soham0777/dermasense-vishwakarma-2026/5_cad/calc_mechanical_report.md

# Mechanical calculations (generated by calc_mechanical.py, 2026-10-14)

| Quantity | Result | Basis |
|---|---|---|
| Pin spring rate (linear assumption) | 0.49 N/mm | [DS] 100 g at 2 mm travel (Probots P75-B1 listing) |
| Pin compression when clamped | 1.48 mm (of 2.0 mm travel) | [DES] protrusion − film |
| Contact force per pin / total | 0.72 N / 2.89 N | [EST] |
| Lid deflection (PETG, 4.0 mm, span 35.7 mm) | 11.2 µm | [EST] simply supported, centre load |
| Lid bending stress (same beam model) | 0.42 MPa | [EST] vs PETG yield ~40-50 MPa [DS typ.]: FoS ≈ 95; > 40 even if FDM printing halves strength. Analytical check, not FEA |
| Pin landing tolerance on 3 mm pad | allow ±1.35 mm; worst-case 0.49, RSS 0.25 mm | [EST] margin 2.8× worst-case |
| Strip bending strain at 10 mm radius | 0.62 % | t/2R; Kapton yields near 3 % [DS]; LIG cracking limit unknown → T-MECH-01 |
| Kapton bearing stress at dowels, 10 N tug | 20 MPa vs 231 MPa tensile | [EST] dowels take the load, not the pins (strain relief) |
| Pointed-tip contact stress (0.1 mm tip radius) | 23 MPa | [EST] may dent porous LIG → prefer rounded-head pins; verify in T-CON-01 |
| Stack heights | base 16.0 mm; dressing 4.0 mm; spacer 12 mm | [DES] keeps the dressing top level with the clamp top |

**Conclusions:**
- The two M3 screws easily provide the 2.9 N pin reaction.
- The lid deflects only about 11 µm against 1.48 mm of pin compression, so contact force is set by the pin springs, not the lid.
- The tolerance stack uses at most 0.49 mm of the 1.35 mm allowed.
- The dowels take any pull on the strip (strain relief).
- **Open risk:** pointed pin tips on porous LIG. Use rounded-head pins or a silver-paint pad, and verify in T-CON-01.
