soham0777/dermasense-vishwakarma-2026/FINAL_SUBMISSION/SUBMIT_CHECKLIST.md

# Stage 2 submission: VK26-IITI-HT-0050 (Dermasense)

> **Submitted on 20 Oct 2026** through the Design Stage Form (Health Tech · Emergency Response & Remote Monitoring), with the PDF in this folder (MD5 `3264735b…`). The form confirmed: "We have received your response for Stage 2". The table below is kept as a record.

**Files to upload**
- `Dermasense_VK26-IITI-HT-0050_Stage2.pdf`: 19 pages, exported by PowerPoint from the PPTX next to it.
- `Dermasense_VK26-IITI-HT-0050_Stage2.pptx`: the editable source.

**Project link** (use it wherever the form asks for a project, repository or Drive link):
https://github.com/soham0777/dermasense-vishwakarma-2026

**Deadline:** 11:59 PM, 25 October 2026 (organiser's email; no timezone given). Submit a day early if you can.

## Already done
- Team feedback applied to slides 1–19 (wording, numbers, sources).
- Slide 12 now has the team photos (Soham with the early laser-written samples; Bhakti in the cleanroom) and the roles. It also has the GitHub link, which is clickable in the PDF.
- Old deck versions removed from the repository. The template and the engineering PDFs are kept (CAD drawings, KiCad schematic, E2 bench sheets).

## Still needs you
| # | Do | Pass when |
|---|---|---|
| 1 | Flip through the PDF once | Nothing looks wrong to you |
| 2 | **Roles on slide 12:** Soham = Mechanical Architecture & Sensor Design; Bhakti = Materials & Micro-fabrication (semiconductor background) | Both of you agree |
| 3 | **ID badges:** the template asks for institutional ID badges to be visible in the team photo. Neither photo shows one. If you have a photo with badges, right-click the photo → **Change Picture**, then **File → Export → PDF** | Badges visible, or you accept the risk |
| 4 | **Canva:** these edits are in the PPTX/PDF, not in your Canva design. Upload the PDF, or import the PPTX into Canva before sharing a Canva link | The file you submit is this version |
| 5 | Submit through the Design Stage Form in the organiser's email | Confirmation screenshot saved in `_private/` |
