soham0777/dermasense-vishwakarma-2026/3_decisions/decision_matrix.md

# Sensor decision matrix (generated by decision_matrix.py)

Scores 1–5 (5 = better / simpler / cheaper). Engineering judgement, to be re-scored after E2 and E4.

| Criterion (weight) | S1 | S2 | S3 | S4 | S5 |
|---|---|---|---|---|---|
| Signal contrast wet vs dry (3) | 5 | 5 | 5 | 3 | 3 |
| Discrimination (front vs condensation, leak, handling, failure) (3) | 2 | 4 | 4 | 3 | 3 |
| Repeatability given unknown LIG batch variation (3) | 4 | 4 | 4 | 2 | 3 |
| Calibration burden (2) | 4 | 4 | 4 | 2 | 3 |
| Geometry feasible with ~0.3 mm laser lines (2) | 5 | 4 | 3 | 4 | 4 |
| Fluid compatibility (fouling, electrochemistry) (2) | 4 | 4 | 4 | 3 | 5 |
| Electronics complexity (2) | 5 | 5 | 4 | 4 | 2 |
| Fabrication difficulty (layers, registration) (2) | 5 | 4 | 3 | 4 | 3 |
| Unit cost (2) | 5 | 5 | 4 | 5 | 4 |
| Disposable waste (1) | 5 | 5 | 4 | 5 | 4 |
| User workflow (2) | 4 | 4 | 4 | 4 | 4 |
| Safety (2) | 5 | 5 | 5 | 5 | 5 |
| Validation burden (2) | 4 | 4 | 3 | 2 | 3 |
| **Weighted score / 5** | **4.29** | **4.36** | **3.96** | **3.39** | **3.46** |

## Ranking

1. S2 Two-zone strip: centre C + change line A: **4.36**. Adds an ORDER check: a real front wets C before A. A-before-C flags CHECK (leak, handling, misplacement). Needs only 2 sense lanes.
2. S1 Single-zone strip at the change line: **4.29**. Simplest. Cannot tell a genuine front from a drip, an external leak or handling at the window.
3. S3 Four-zone front strip: C, M, A, E: **3.96**. Early warning (M) and a leak zone (E), but 4 lanes, tighter routing and more registration-critical windows; unproven benefit.
4. S5 Capacitive sealed electrodes (no fluid contact): **3.46**. Best fluid compatibility; needs a capacitance front end (the ESP32-C3 has no touch peripheral) and lamination.
5. S4 Continuous resistive front locator (1 line + collector): **3.39**. Elegant (3 contacts), but the reading depends directly on LIG Rs uniformity, our least-known property.
