soham0777/dermasense-vishwakarma-2026/3_decisions/sensor_selection.md

# Primary sensor design: two-zone moisture-front strip (decision D-012)

**Status:** SELECTED as design v0.1 (2026-10-14). **Not fabricated, not tested.** Scores are in `decision_matrix.md` (generated by `decision_matrix.py`).

## 1. Decision

| Rank | Concept | Score | Role |
|---|---|---|---|
| 1 | **S2: two-zone strip, pad centre C + change line A** | 4.36 | **Primary (v0.1)** |
| 2 | S1: single zone at the change line | 4.29 | **Fallback 1**, if sealing registration fails in E2 (one window, no lane under it) |
| 3 | S3: four zones C, M, A, E | 3.96 | **Upgrade path**, only if E4 shows that early warning (M) or leak warning (E) changes a decision |
| 4 | S5: capacitive, sealed | 3.46 | Fallback 2, if saline contact proves unworkable (fouling, drift) |
| 5 | S4: continuous resistive locator | 3.39 | Rejected for now: its reading depends directly on LIG uniformity, our least-known property |

**Why S2 beats the earlier 4-zone idea under *our* constraints:**
- It keeps the one thing a single zone can't do, the **order check**: a real front wets C before A.
- It halves the routing (2 sense lanes instead of 4) and the number of alignment-critical windows.

## 2. How it works

- **Electrodes:** LIG electrodes face the absorbent pad on the pad's outer face, under the cover film. The strip never touches the wound.
- **Wetting:** when exudate reaches a zone window, the saline-like fluid bridges a 1.0 mm gap between that zone's sense electrode and the common electrode.
- **Signal:** resistance falls from ≥ 1 MΩ (dry, estimate) to about 4–15 kΩ (wet, calculated including leads). Details in `6_electronics/calc_readout_report.md`.
- **LIG is only the conductor here.** No chemical selectivity is claimed. LIG made in air is superhydrophilic (Li 2017), so fluid wets the windows readily. For the same reason **every trace outside a window is sealed** under polyimide tape, otherwise fluid could wick along it.

**Layer stack, wound side last:**
1. cover film
2. strip: Kapton with LIG facing down, plus polyimide-tape seal with windows
3. absorbent pad
4. wound-contact layer
5. wound

## 3. States (all must be physically measurable; firmware `zone_logic.h`)

| State | Condition (each zone: wet < 100 kΩ, dry > 300 kΩ, hysteresis between) | Meaning |
|---|---|---|
| OK | C dry, A dry; or C wet, A dry | Dressing still has capacity at the change line |
| CHANGE | A wet **after** C was wet, persisting ≥ 3 scans | Front reached the maker's change line |
| CHECK | A wet while C dry (order violated), persisting ≥ 3 scans | Possible external leak, handling, misplaced strip, or condensation at A only |
| FAULT | Common loop open (> 50 kΩ between its two ends), reading below the lead floor (< 1 kΩ = short), or self-test resistor out of ±5 % | Sensor or contact failure; never shown as "OK" |

**Decided against for v0.1:** SOON and LEAK. They need M and E zones, which are not in v0.1.

## 4. Telling a real front from look-alikes

| Look-alike | Expected signature (hypothesis) | Detection in v0.1 | Test that confirms or refutes |
|---|---|---|---|
| Real saturation front | C wets, then A after a delay that depends on flow; both reach low kΩ | Order + persistence | E4 runs (dressing + Solution A, centre inflow) |
| External leak or spill at the edge | A wets first, C stays dry | CHECK | E4-L: drip on the outer face at A |
| Condensation under the cover film | Both zones drift down slowly, probably not to the kΩ range (unknown) | Not separable from a front if it reaches < 100 kΩ | **E4-H:** warm humid chamber, dry dressing, 2 h. If readings drop below 300 kΩ, the threshold must change |
| Sweat (skin side) | The strip is on the outer face of the pad; sweat must pass through the pad first | Same as a front | Not tested on the bench; documented limitation |
| Handling / pressing | Brief changes | Persistence ≥ 3 scans (15 s) | E4-P: press and flex a dry strip |
| Cracked trace or bad contact | Loop open, or one zone stuck at the open-circuit limit | FAULT | Cut test: cut the common leg → must report FAULT |

## 5. Geometry v0.1 (PROVISIONAL: conservative 1.0 mm features until E2 measures line growth and minimum gap)

- **Strip:** 10 mm wide.
- **Zone windows:** 6 mm long along the strip; they expose the sense electrode, a 1.0 mm gap and the common electrode.
- **Spacing C to A:** 17.5 mm.
  - This assumes a 75 × 75 mm pad with the change line 20 mm inside the pad edge.
  - **It must be re-set to the actual test dressing's pad and its IFU rule.**
- **Tail:** leaves the dressing to a 4-pad paddle (SENSE_C, SENSE_A, COM_1, COM_2) at 5.08 mm pitch, with two Ø2.0 mm alignment holes.
- **Generated by** `4_sensor_strip/make_strip.py`, which writes the DXF and JSON and runs a clearance check. SolidWorks reads the same JSON (`5_cad/sw_build.py`).

## 6. What is NOT yet known

- Real Rs and line width (E2).
- Minimum isolating gap and sealing registration (E2).
- Dry baseline on real dressings, and the condensation response (E4-H).
- Whether the strip changes the dressing's fluid uptake (E4 control with no strip).
- Whether pogo-pin contact on LIG pads is stable (T-CON-01).
