soham0777/dermasense-vishwakarma-2026/1_presentation/template/TEMPLATE_PROVENANCE.md

# Official template: provenance

| File | MD5 | Source |
|---|---|---|
| `Vishwakarma Awards 2026-27 Stage 2 Submission Template.pptx` | 4d96244a04c6be5a3a952b42eb965679 | First copy (2026-10-14) |
| `Vishwakarma Awards 2026-27 Stage 2 Submission Template (2).pptx` | c58ef4fe526045f1a82a806e6532bc3c | The file the team named as the official template (`Downloads`, 2026-10-14) |

**Compared on 2026-10-14 with python-pptx:** both have 20 slides at 16:9, and every slide has the same shape count and the same text. The bytes differ only because the file was re-exported.

**Rule:**
- Both files stay unmodified. The deck builder must start from **Template (2)**.
- Never edit a template in place; work on a copy.
