soham0777/dermasense-vishwakarma-2026/6_electronics/kicad/out/reader_v0_1_schematic.pdf

1 | 2 | 3 | 4 | 5 | 6
1 | 2 | 3 | 4 | 5 | 6

AB

C

D

AB

C

### D Date: 2026-10-14

### KiCad E.D.A. 10.0.6

Size: A4 | Rev: 0.1 PROVISIONAL Id: 1/1

## Title: Dermasense two-zone reader v0.1

### File: reader_v0_1.kicad_sch

### Sheet: /

## Team Dermasense, Vishwakarma Awards 2026-27

### Bench reader: ESP32-C3 SuperMini + ADS1115 module

Generated by 6_electronics/kicad/make_reader_schematic.py - edit the script, not this file

R3
1k D1

LED green OK

R9

1k R2
1k R8
1k +3V3 | GND GND | R1

1k 1
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
# SuperMini left header GND

PWR_FLAG | GND+3V3 | D2
LED amber CHANGE D3

LED red CHECK/FAULT 1
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
# SuperMini right header PWR_FLAG

R7

1k GND | GND GND

1
2
3
4

J4

Strip pads (pogo P75-B1) +3V3 | R6

100k 0.1%

R5
100k 0.1%

R4
1k C1

10nF C0G

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
ADS1115 module header +3V3 GND
DRV_C | DRV_CHK N

N

S_C
S_A COM1

LED_G

DRV_LOOP
SDA SCL
LED_Y | COM2

LED_G

LED_Y

LED_R

DRV_REF DRV_CHK

LED_R

DRV_A | SCL SDAN | S_C DRV_C | DRV_A | COM1 S_A | N | COM2 N | DRV_LOOP | DRV_REF

GND
3V3 GPIO2/8/9 = strapping pins (8 = on-board LED, 9 = BOOT): left unused. 5V pin unused (USB powers the module). 1 Zone C: DRV_C and DRV_REF drive, all other drive pins high-Z. Phase +: DRV_C=1, DRV_REF=0; phase -: DRV_C=0, DRV_REF=1. Rx = Rref(Vdd/VN - 1) (phase +), Rx = Rref VN/(Vdd - VN) (phase -); average; subtract R1 + R3 = 2 x 1k. 2 Zone A: same with DRV_A. 3 Loop: DRV_LOOP vs DRV_REF through COM2 -> COM loop -> COM1 (open = FAULT). Thresholds (calc_readout): wet < 100 kohm, dry > 300 kohm, 3 consecutive scans. States: OK / CHANGE / CHECK (A wet before C) / FAULT.

A3

I2C address 0x48 (ADDR to GND); 10k pull-ups are on the module. A0 = node N (zone/loop/check). A1 = 3V3 rail (ratiometric Vdd). GPIO3 GPIO2

4 Check: DRV_CHK vs DRV_REF (known 100k) -> gain/loading correction. Between scans every drive pin is high-Z (no DC on the strip).

GPIO1 GPIO0 GPIO5 GPIO6 GPIO21 GPIO7 GPIO8 GPIO9 GPIO10 GPIO20 U1 ESP32-C3 SuperMini (module headers) | ADDR

# VDD Dermasense minimum two-zone reader v0.1 (bench, PROVISIONAL)

SENSE_C
SENSE_A
A1 | COM_1 U2 ADS1115 ADC module Measurement sequence (firmware 7_firmware/reader_v0_1):

## Drive and sense network (one node N, one zone at a time)

Bipolar DC drive per zone; values from 6_electronics/calc_readout.py. USB-powered bench tool, not for patient use. ALRT Power: USB-C -> SuperMini LDO -> 3V3

# A2GND

GPIO4 | SDA | J4 strip contact: 4 pogo pins in clamp_base_v0_1
SCL | COM_2 Status LEDs (1.3 mA each) 5V

A0 GND

PWR_FLAG +3V3 | PWR_FLAG

R5
100k 0.1%

R6
100k 0.1%

D3

LED red CHECK/FAULT D2 GND | LED amber CHANGE GND
D1 GND | LED green OK
