soham0777/dermasense-vishwakarma-2026/3_decisions/README.md

# 3_decisions: what we decided, and why

| File | What it is |
|---|---|
| `requirements.md` | Requirements for strip v0.1 → design element → test → status |
| `decisions.md` | Decision log (D-001 … D-015): what we chose, the alternatives, and what would change our mind |
| `sensor_selection.md` | Why the two-zone strip (decision D-012) |
| `decision_matrix.py` → `decision_matrix.md` | 5 concepts scored on 13 weighted criteria |
| `make_fmea.py` → `fmea_v0_1.md`, `fmea_v0_1.csv` | Design FMEA: 15 failure modes (ratings are estimates until tested) |
| `evidence_register.csv` | Every claim, labelled A (our record), B (to be measured), C (literature) or X (excluded) |
