soham0777/dermasense-vishwakarma-2026/2_research/README.md

# 2_research

| File | What it is |
|---|---|
| `literature.csv` | 41 sources, each with how it was verified and what we use from it |
| `research_matrix.csv` | 16 key sources compared side by side (material, process, results, limits, decision supported) |
| `research_gap.md` | What is known, what is not, and the evidence we still need |
| `interview_guide.md` | Guide for talking to nurses and carers (interviews not yet done) |
| `rezaei2024_critique.md` | Why a cited "Kapton graphene biosensor" paper is simulation only |
