soham0777/dermasense-vishwakarma-2026/1_presentation/figures/fig_journey_after.png

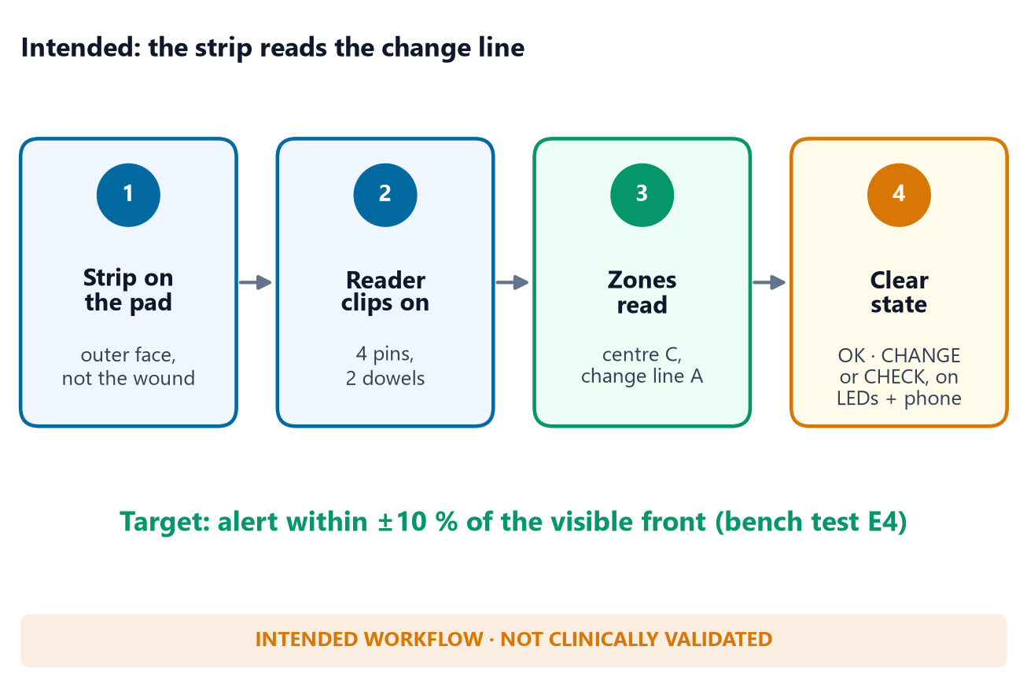
1_presentation/figures/fig_journey_after.png
