soham0777/dermasense-vishwakarma-2026/1_presentation/figures/fig_journey_before.png

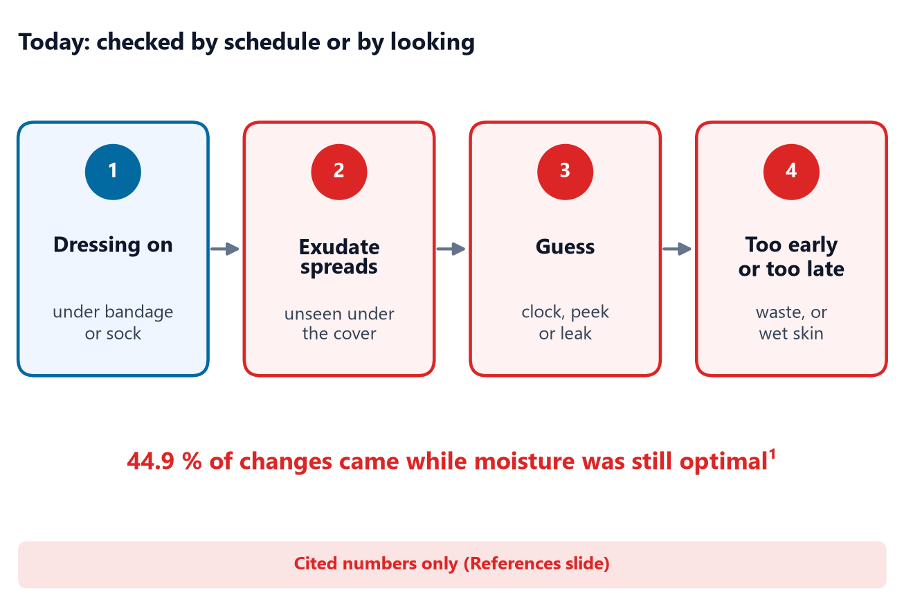
1_presentation/figures/fig_journey_before.png
