soham0777/dermasense-vishwakarma-2026/1_presentation/figures/fig_strip.png

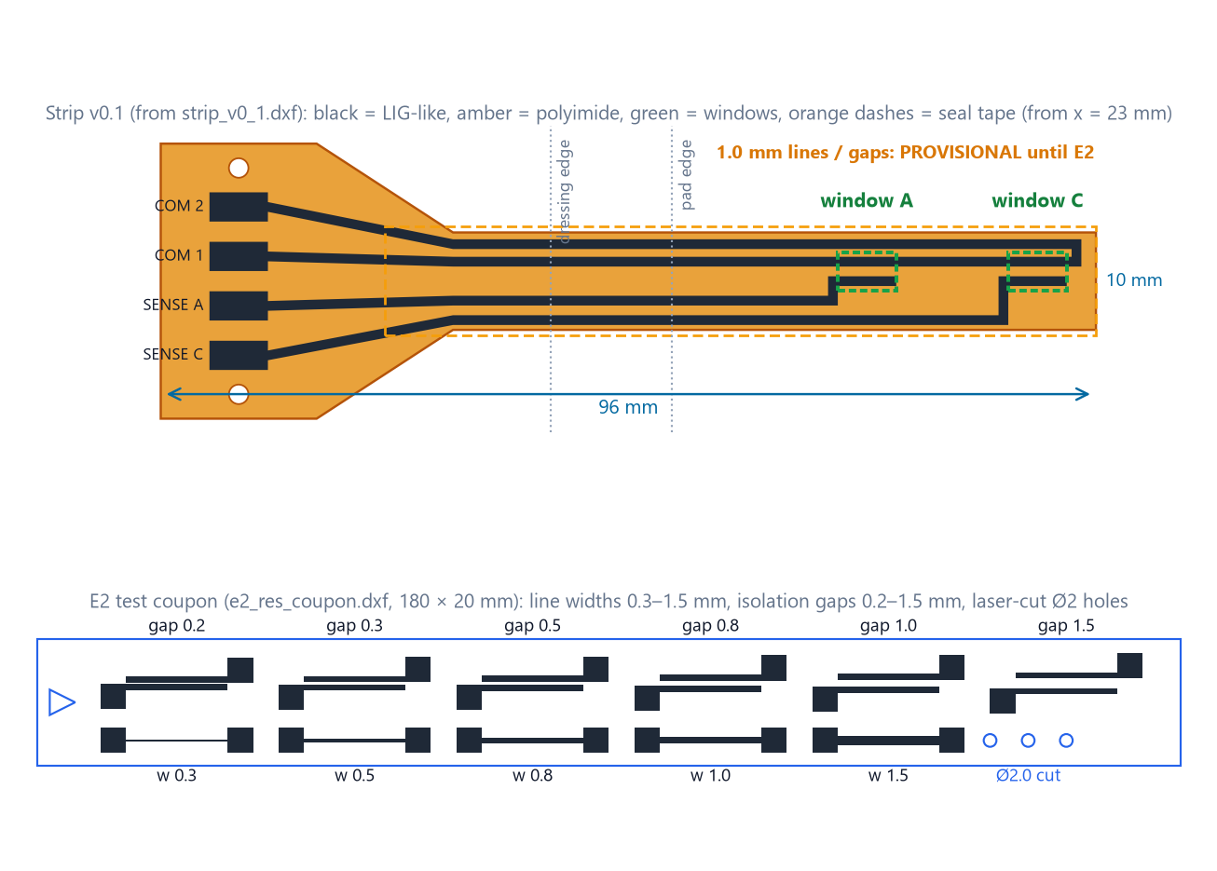
1_presentation/figures/fig_strip.png
