soham0777/dermasense-vishwakarma-2026/1_presentation/figures/placeholder_lab.png

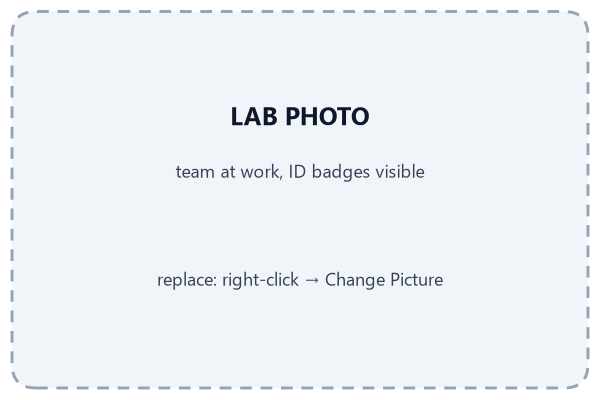
1_presentation/figures/placeholder_lab.png
