soham0777/dermasense-vishwakarma-2026/1_presentation/figures/placeholder_team.png

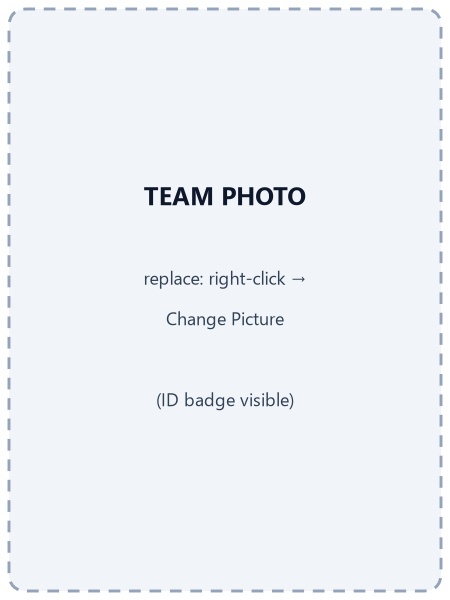
1_presentation/figures/placeholder_team.png
