soham0777/dermasense-vishwakarma-2026/5_cad/solidworks/clamp_base_v0_1_iso.JPG

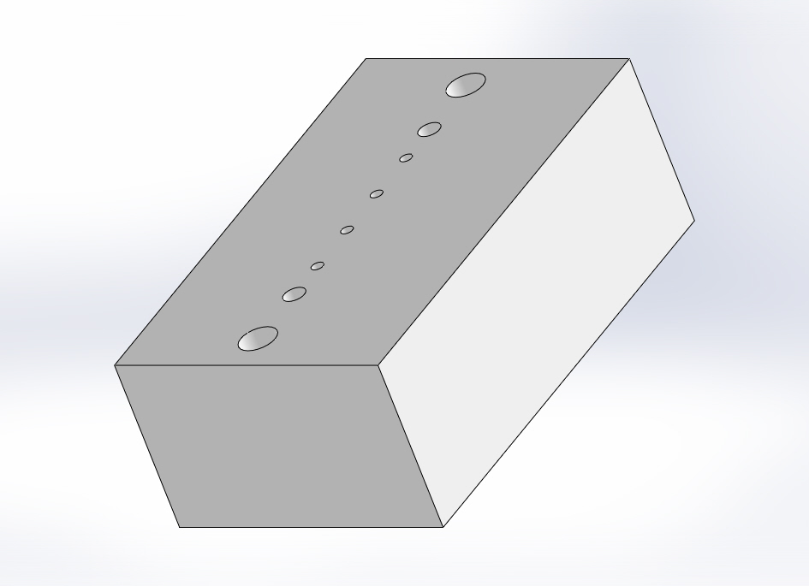
5_cad/solidworks/clamp_base_v0_1_iso.JPG
