soham0777/dermasense-vishwakarma-2026/5_cad/solidworks/dermasense_bench_v0_1_iso.JPG

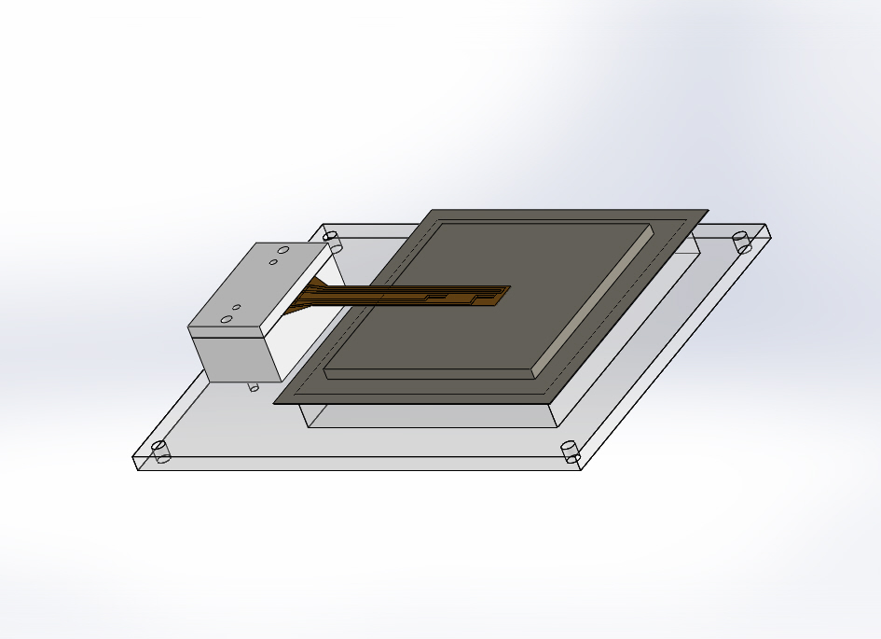
5_cad/solidworks/dermasense_bench_v0_1_iso.JPG
