soham0777/dermasense-vishwakarma-2026/6_electronics/bom_v0_1.csv

id | needed_for | subsystem | item | specification | qty | unit | est_unit_cost_inr | price_status | where_to_check | requirement_source | have_it_YN | notes
P01 | E2 | LIG | Polyimide film | Kapton-type polyimide, 0.125 mm (confirm the film already used; record lot) | 1 | sheet/roll | 0-1500 | estimate - may already be in lab | existing stock / Robu / Amazon.in | 4_sensor_strip/e2_experiment/E2_procedure.md S0-4 |  | say 'polyimide film' unless the label says Kapton
P02 | E2 | LIG | Silver conductive paint | for pad contacts; small bottle | 1 | bottle | 600-1500 | estimate | Robu.in / local electronics | E2 procedure A-6/B-3 |  | fallback: firm probe pressure (recorded)
P03 | E2 | LIG | Reference resistors 1 % | 100 ohm, 10 kohm, 1 Mohm (meter check) + 1k,10k(x3),47k,100k,220k,470k,1M (reader bench test) | 1 | set | 100-300 | estimate | local electronics / Robu | E2 A-5 + 7_firmware/BENCH_TEST.md
P04 | E2 | LIG | 2.00 mm dowel pin or drill bit (hole gauge) | ISO 8734 2 m6 x 12 stainless (same as the clamp dowel) | 4 | pcs | 10-40 | estimate | Amazon.in / industrial supplier | E2 B-6 + clamp |  | also used in the clamp (2 pcs)
P05 | E2 | LIG | IPA + lint-free wipes | isopropyl alcohol 99 % | 1 | bottle | 150-300 | estimate | lab stock / chemist | E2 A-1 |  | flammable: away from the laser
P06 | E2 | LIG | Nitrile gloves | box | 1 | box | 200-400 | estimate | lab stock | E2_safety_checklist.md
P07 | E2 (optional W) | LIG | Saline 0.9 % NaCl | sterile bottle, pharmacy | 1 | bottle | 30-60 | estimate | chemist | E2 Part W
P08 | E2 | LIG | DMM with >= 20 Mohm range | must read > 3 Mohm for the isolation rule | 1 | pcs | 0 (borrow) - 2500 | estimate | lab instrument | E2 equipment table |  | a 2 Mohm meter makes isolation inconclusive
R01 | Reader | Electronics | ESP32-C3 SuperMini | USB-C, native USB (CDC) | 1 | pcs | 242 | quoted 19 Oct 2026 incl. GST, in stock | probots.co.in SKU PRO4607 (ESP32-C3 SuperMini, USB-C) | 6_electronics/kicad/reader_v0_1.kicad_sch J1/J2
R02 | Reader | Electronics | ADS1115 module | 16-bit I2C ADC breakout (VDD,GND,SCL,SDA,ADDR,ALRT,A0-A3) | 1 | pcs | 125 | quoted 19 Oct 2026 incl. GST, in stock | probots.co.in SKU PRO789; alt. hubtronics.in Rs 190 | schematic J3
R03 | Reader | Electronics | Resistor 100 kohm 0.1 % 25 ppm/C | metal film (R5 Rref and R6 check) | 2 | pcs | 20-60 | estimate | element14 India / Mouser India / local | schematic R5 R6 |  | accuracy depends on these
R04 | Reader | Electronics | Resistor 1 kohm 1 % | metal film (R1-R4 protection; R7-R9 LEDs) | 7 | pcs | 1-3 | estimate | local | schematic
R05 | Reader | Electronics | Capacitor 10 nF C0G/NP0 | 50 V, 5 mm pitch | 1 | pcs | 5-15 | estimate | local | schematic C1 |  | ceramic X7R is NOT acceptable
R06 | Reader | Electronics | LEDs 3 mm | green, amber, red | 3 | pcs | 2-5 | estimate | local | schematic D1-D3
R07 | Reader | Electronics | Perfboard + female headers + hook-up wire | ~50 x 70 mm; 2 x 8-pin, 1 x 10-pin, 1 x 4-pin | 1 | set | 100-250 | estimate | local | 7_firmware/WIRING.md
R08 | Reader | Electronics | USB-C data cable |  | 1 | pcs | 0-200 | estimate | existing | BENCH_TEST T1
M01 | Clamp | Mechanical | Spring probe P75-B1 | 1.02 mm, 2 mm travel, ~100 g (Probots/Hubtronics listing) | 1 | pack of 100 | 354 | quoted 19 Oct 2026 incl. GST, 140 in stock | hubtronics.in SKU 05880 (P75-B1, 1 mm x 15.85 mm) | 5_cad pogo_pin_P75_simplified + calc_mechanical |  | 4 used + spares; pack of 100 is the smallest listed; tip shape not stated - prefer rounded head (calc_mechanical open risk)
M02 | Clamp | Mechanical | PETG print: clamp base + lid | 0.2 mm layers, 100 % infill around pin holes | 1 | set | 0-300 | estimate | lab printer | 5_cad clamp_base_v0_1 / clamp_lid_v0_1
M03 | Clamp | Mechanical | M3 x 25 screws + M3 nuts | stainless; 2 for the clamp | 4 | pcs | 5-15 | estimate | local | 5_cad screw_points
M04 | Rig | Mechanical | Cast acrylic 5 mm (rig base) + 6 mm (spacer x 2) | laser-cut | 1 | set | 0-600 | estimate | lab offcuts | 5_cad rig_base_v0_1 / wound_bed_spacer_v0_1
M05 | Rig | Mechanical | M4 rubber feet |  | 4 | pcs | 10-30 | estimate | local | rig_base_v0_1
S01 | Strip | Sensor | Polyimide adhesive tape (seal) | ~0.09 mm total, silicone adhesive; width >= 10 mm | 1 | roll | 200-500 | estimate | Robu.in / Amazon.in | 4_sensor_strip/strip_v0_1_encap.dxf
S02 | E4 (later) | Test | Bordered foam dressing (reference) | pad 75 mm, border 12.5 mm (as modelled) | 3 | pcs | 100-300 | estimate | chemist | 5_cad dressing_reference |  | needed for E4 concept validation
