soham0777/dermasense-vishwakarma-2026/6_electronics/kicad/out/reader_v0_1_bom.csv

Reference | Value | Footprint | QUANTITY | Description
C1 | 10nF C0G | Capacitor_THT:C_Disc_D5.0mm_W2.5mm_P5.00mm | 1 | node filter; settle >= 10 ms (10 tau)
D1 | LED green OK | LED_THT:LED_D3.0mm | 1 | green OK
D2 | LED amber CHANGE | LED_THT:LED_D3.0mm | 1 | amber CHANGE
D3 | LED red CHECK/FAULT | LED_THT:LED_D3.0mm | 1 | red CHECK/FAULT
J1 | SuperMini left header | Connector_PinHeader_2.54mm:PinHeader_1x08_P2.54mm_Vertical | 1 | ESP32-C3 SuperMini module pins
J2 | SuperMini right header | Connector_PinHeader_2.54mm:PinHeader_1x08_P2.54mm_Vertical | 1 | ESP32-C3 SuperMini module pins
J3 | ADS1115 module header | Connector_PinHeader_2.54mm:PinHeader_1x10_P2.54mm_Vertical | 1 | ADS1115 breakout
J4 | Strip pads (pogo P75-B1) | Connector_PinHeader_2.54mm:PinHeader_1x04_P2.54mm_Vertical | 1 | pads at 5.08 mm pitch, strip_v0_1
R1-R4,R7-R9 | 1k | Resistor_THT:R_Axial_DIN0207_L6.3mm_D2.5mm_P10.16mm_Horizontal | 7 | LED series resistor,common electrode protection,loop-check protection,zone A protection,zone C protection
R5,R6 | 100k 0.1% | Resistor_THT:R_Axial_DIN0207_L6.3mm_D2.5mm_P10.16mm_Horizontal | 2 | Rref, 0.1 %, 25 ppm/C,check resistor, 0.1 %
