soham0777/dermasense-vishwakarma-2026/3_decisions/fmea_v0_1.csv

id | item | failure_mode | effect | S | cause | O | current_control | D | RPN | action | verified_by
F01 | Zone electrodes (LIG) | Layer not conductive / Rs far higher than expected | Zones always read dry: CHANGE missed | 7 | Laser setting or focus drift, film lot | 5 | E2 Rs + CV acceptance; per-strip dry/loop check before use | 4 | 140 | Run E2; add a per-strip QC record (loop R, both zones dry > 1 Mohm) | E2
F02 | Electrode gap | Carbon bridges the gap | Zone reads wet when dry: false CHANGE/CHECK | 6 | Line growth larger than the 0.95 mm clearance | 4 | E2 isolation test; start-up rule: both zones must read dry | 3 | 72 | Set MIN_CLEAR from the E2 smallest isolating gap + growth | E2
F03 | COM loop trace | Crack or break | FAULT shown (no wrong state) | 5 | Bending at the dressing edge | 4 | Loop continuity measured every scan | 2 | 40 | Bend test of 1.0 mm lines at a 10 mm radius | T-MECH-01
F04 | SENSE_C / SENSE_A lead | Crack or break | That zone reads open = dry forever: CHANGE missed, no alarm | 7 | Bending at the dressing edge | 4 | None (the loop check covers COM only) | 8 | 224 | v0.2 candidate: loop each SENSE lead to a second pad (6-pad strip) so its continuity is checked every scan | design v0.2 + T-MECH-01
F05 | Pogo-pin contact on LIG pad | High or unstable contact resistance | Readings drift high (towards dry) | 6 | Porous LIG dented by pointed tips, dust, oxidation | 5 | COM pins checked by the loop; silver-painted pads | 4 | 120 | Rounded-head pins; measure contact R vs clamp cycles | T-CON-01
F06 | Seal registration | Window shifted onto a lead | Wet lead read as wet zone: early CHANGE/CHECK | 5 | Tape cut or placement error | 4 | DRC: window A is 2.5 mm from the nearest foreign net; alignment holes | 5 | 100 | Seal jig using the 2 mm dowels; inspect each strip | E4
F07 | Sensing concept | Exudate front does not reach the windows as assumed | CHANGE late or never | 7 | Dressing wicking differs from the model; strip position | 5 | None yet (concept not validated) | 6 | 210 | Simulated-exudate test on real bordered foam dressings | E4
F08 | Thresholds | Dry baseline of a humid dressing below 300 kohm | False wet | 6 | Humidity, saline residue | 5 | Hysteresis + 3-scan persistence | 5 | 150 | Measure dry baselines on dressings; adjust config.h with a written reason | E4
F09 | Readout | Wrong reading from ADC or reference drift | Wrong state | 7 | Component fault, wiring error | 2 | Known 100 k check resistor every scan -> FAULT outside +/-5 %; consistency check of netlist vs firmware | 2 | 28 | Bench test T2-T10 | BENCH_TEST
F10 | Readout | DC current through wet electrodes | Electrode corrosion, drift | 4 | Firmware bug leaves a pin driven | 2 | Bipolar drive; all pins high-Z between scans | 3 | 24 | Bench test T8 (average DC < 5 mV) | BENCH_TEST
F11 | Strip placement | Strip inserted reversed or off-centre | Zones swapped: CHECK instead of OK/CHANGE | 5 | User error | 3 | CHECK state flags A-before-C; asymmetric paddle | 3 | 45 | Orientation mark on the paddle; instructions | E4
F12 | Fabrication | Operator exposed to polyimide fumes | Respiratory irritation | 8 | Exhaust off or lid opened early | 3 | E2 safety checklist (exhaust check, 30 s wait) | 2 | 48 | Checklist signed every session | E2 safety checklist
F13 | Fabrication | Fire in the laser | Injury, equipment damage | 9 | Unattended job, too much power | 2 | Never unattended; CO2 extinguisher; lowest power first | 2 | 36 | Checklist signed every session | E2 safety checklist
F14 | Bench reader | Mains-connected laptop coupled to a person | Electric shock path | 9 | Using the USB bench reader on a person | 1 | Bench-only rule; 'not for patient use' on schematic and README | 3 | 27 | Battery-only, isolated design before any human use (out of v0.1 scope) | design rule
F15 | Strip material | LIG particles shed into the dressing | Foreign material near the wound | 8 | Abrasion, porous carbon | 3 | Strip is outside the wound bed; leads sealed; tape test in E2 | 5 | 120 | Literature and standards review of carbon/polyimide contact; shedding test on wet dressing | E2 tape test + E4 + review
