soham0777/dermasense-vishwakarma-2026/Stage2_Review_Output_2026-10-20/new_sources.csv

ref | citation | doi_or_url | how_read | number_used | where_used | caveat
16 | Gupta N, Gupta SK, Shukla VK, Singh SP. An Indian community-based epidemiological study of wounds. J Wound Care 13(8):323-325 (2004) | 10.12968/jowc.2004.13.8.26657 | abstract (BHU repository) + citation in ref 17, read 20 Oct 2026 | 31 chronic wounds in 6,917 people = 4.5 per 1,000 | slide 4 card | 2001-03, Varanasi urban + rural; small sample
17 | Sharma A, Srivastava V, Shankar R, Yadav AK, Ansari MA, Gupta SK. Epidemiological profile of chronic wounds in an Indian population. Cureus 16(9):e68684 (2024) | 10.7759/cureus.68684 | full text (PMC11452775), read 20 Oct 2026 | 19 in 10,003 = 1.9 per 1,000; diabetic foot ulcers 36.8 % of chronic wounds | slide 4 card + notes | one district; 19 cases
18 | Anjana RM et al. Metabolic non-communicable disease health report of India: the ICMR-INDIAB national cross-sectional study (ICMR-INDIAB-17). Lancet Diabetes Endocrinol 11(7):474-489 (2023) | Lancet Diabetes Endocrinol 2023;11(7):474-489 | abstract and press summaries, read 20 Oct 2026 | 101 million with diabetes (11.4 %) | slide 4 card | data window reported differently by summaries
19 | Armstrong DG, Boulton AJM, Bus SA. Diabetic foot ulcers and their recurrence. N Engl J Med 376:2367-2375 (2017) | 10.1056/NEJMra1615439 | secondary summaries, read 20 Oct 2026 | lifetime foot-ulcer incidence 19-34 % in diabetes | slide 4 card (labelled EST.) | review estimate; upper bound contested (Diabetic Foot Journal commentary)
20 | Price PE et al. Dressing-related pain in patients with chronic wounds: an international patient perspective. Int Wound J 5(2):159-171 (2008) | 10.1111/j.1742-481X.2008.00471.x | abstract, read 20 Oct 2026 | 790 of 2,018 patients (40.3 %): pain at dressing change is the worst part of living with a wound | slides 3, 4, 5 | 15 countries, not India-specific
