soham0777/dermasense-vishwakarma-2026/3_decisions/evidence_register.csv

id | category | statement | source | date_recorded | status | how_to_verify_or_use
A1 | A (team observation) | At a machine/LaserCAD power setting described as "12", a black layer that looked like laser-induced graphene formed on Kapton film | Team member recollection (Soham) | 2026-10-14 | PRELIMINARY - no photo | parameter record or measurement found on this PC | Reproduce in Experiment E1 (reference condition); record all settings
A2 | A (team record) | LaserCAD V8.28 installed on the team laptop on 2026-07-20; config written 2026-07-20 (SysCfg.ini) and temp file 2026-08-23 - consistent with 'several months ago' timing | C:\LaserCAD\ file timestamps | 2026-10-14 | RECORDED | Confirm the Kapton trial date from phone photos/messages
A3 | A (team record) | Machine configuration stored by LaserCAD: X range 1200 mm, Y range 900 mm, max speed X 500 / Y 400 mm/s, engrave accel 10000, PWM frequency 20000 Hz, MaxPower 98 (%), LaserMode 0 | C:\LaserCAD\AWCCfg\SysCfg.ini | 2026-10-14 | RECORDED (laptop copy) | Confirm it matches the lab machine (bed size | controller model on panel)
A4 | A (team record) | Last LaserCAD document name was 'laptop_sta' (an unrelated job); temp files contain no Kapton job parameters | C:\LaserCAD\AWCCfg\SoftCfg.ini, _Temp2 | 2026-10-14 | RECORDED | Earlier Kapton settings must come from memory/lab PC/phone photos
A5 | A (team document claim) | Substrate described as '100-micron DuPont Kapton HN film' | Stage 1 proposal PDF (archive) | 2026-10-14 | UNVERIFIED CLAIM - no purchase record or measurement | Measure thickness with micrometer; check packaging/label/invoice
B1 | B (planned measurement) | Meaning of setting '12' (LaserCAD % command vs panel value) and tube current (mA) at settings 10-16 | E1 Session 0 (machine_record.md) |  | PLANNED | Read LaserCAD layer dialog + machine ammeter during firing
B2 | B (planned measurement) | Film thickness (5 points) and grade | E1 Session 0 |  | PLANNED | Micrometer screw gauge 0.01 mm
B3 | B (planned measurement) | Sheet resistance (TLM), contact resistance and fit quality per cell around the reference setting | E1 coupons |  | PLANNED | 4_sensor_strip/analyze_e1.py
B4 | B (planned measurement) | Reproducibility: CV of sheet resistance for the reference condition within a day and between two days | E1 (n = 8 reference cells) |  | PLANNED | Acceptance: CV <= 20 %
B5 | B (planned measurement) | Measured vs drawn strip width (line growth) at each condition | E1 microscope |  | PLANNED | Needed before any sensor geometry is finalised
C1 | C (literature) | LIG on Kapton with 10.6 um CO2 laser: threshold 2.4 W at ~89 mm/s, ~120 um spot; Rs < 35 ohm/sq at threshold, < 15 ohm/sq at 5.4 W | Lin et al. 2014 Nat Commun (L01) | 2026-10-14 | CONFIRMED (full text) | Benchmark for our Rs values
C2 | C (literature) | Desktop CO2 laser limited LIG quality (inconsistent scribing speed, poor thermal management); PI brand strongly affected LIG quality | Carbon Letters 2023 lasing-parameter study (L30) | 2026-10-14 | SUPPORTED (abstract) | Supports reproducibility as a real issue; record film brand/lot
C3 | C (literature) | Sheet-resistance minima do not follow a constant power/speed ratio - parameter interactions matter | Design-of-experiments LIG study (L31) | 2026-10-14 | SUPPORTED (abstract) | Change one factor at a time around reference; replicate centre point
C4 | C (engineering observation) | CO2 glass-tube current is spiky/unstable below ~25 % PWM; current vs PWM roughly linear only at mid range | Engineering blog measurements (L34; not peer-reviewed) | 2026-10-14 | SUPPORTED-WEAK | Our '12' is in this range -> measure tube current and repeatability
C5 | C (theory/software) | In LaserCAD/AWC systems layer power is entered as a percentage (Min/Max power %) of the PWM command; it is not watts | LaserCAD UI convention + SysCfg MaxPower=98 | 2026-10-14 | LIKELY - TO CONFIRM on machine | Session 0
C6 | C (literature) | 44.9 % of 588 dressing changes occurred when wound moisture was in the optimal range (WoundSense study) | Milne et al. 2016 Int Wound J (L08) | 2026-10-14 | CONFIRMED (full text) | Problem framing only; not our result
C7 | C (literature) | Dressing makers define change as exudate approaching ~2 cm from pad edge (some foams) or strike-through at 3 edges (Mepilex Border Flex) | Manufacturer instructions (L28) | 2026-10-14 | SUPPORTED | Application hypothesis H-APP1 only
C8 | C (literature) | Moisture inside dressings is spatially non-uniform; 8-point in-vitro sensor array under dressings (2007) | McColl et al. 2007 Int J Surg (L26) | 2026-10-14 | SUPPORTED (abstract) | Prior art: spatial mapping itself is not novel
X1 | X (unsupported earlier claim) | 'Repeatable 130 ohm/sq at Z = 6 mm, 288 um spot' | v1 deck slides 6/8/12 (archive) | 2026-10-14 | EXCLUDED - no data | Do not reuse
X2 | X (unsupported earlier claim) | 'Penetrates precisely 20 +/- 2 um, 80 um virgin barrier' | v1 deck slide 8 | 2026-10-14 | EXCLUDED - no data | Would need cross-section microscopy/SEM
X3 | X (unsupported earlier claim) | '<4.8 % resistance change after 1000 bends'; '+/-12 ohm/sq across 30 samples'; 'chiller drift 120 -> 380 ohm/sq'; '+/-35 % contact drift' | v1 deck slides 8/12/16/18 | 2026-10-14 | EXCLUDED - no data | Do not reuse
X4 | X (unsupported earlier claim) | Pluronic F-127 rheology, 1.5 m drop test, ISO 10993 'confirmed', KiCad '0 DRC', SolidWorks '18 features', team lab photo | v1 deck | 2026-10-14 | EXCLUDED - no files/data; images were AI-generated | Do not reuse
