soham0777/dermasense-vishwakarma-2026/2_research/literature.csv

id | citation | year | doi_or_url | type | how_verified | topic | what_we_use_from_it | evidence_level | used_for | caveats
L01 | Lin J, Peng Z, ... Tour JM. Laser-induced porous graphene films from commercial polymers. Nat Commun 5:5714 | 2014 | 10.1038/ncomms6714 | peer-reviewed | full text (PMC4264682) read 2026-10-14 | LIG process | CO2 10.6 um, threshold 2.4 W @3.5 in/s, ~120 um beam, 0.005in Kapton; Rs <35 ohm/sq at threshold, <15 at 5.4 W; BET ~340 m2/g; C 97 at%; 2D peak single Lorentzian ~2700 cm-1 | CONFIRMED | process window anchor | different machine; our nominal power unverified
L02 | Ye R, James DK, Tour JM. Laser-induced graphene: from discovery to translation. Adv Mater 31(1):1803621 | 2018 | https://scholars.cityu.edu.hk/en/publications/laser-induced-graphene-from-discovery-to-translation/ | review | bibliographic record only | LIG review | background on porosity/composition control and applications | SUPPORTED | background | DOI likely 10.1002/adma.201803621 but NOT verified; read full text before quoting
L03 | Jiang Y, Trotsyuk AA, Niu S, ... Gurtner GC, Bao Z. Wireless, closed-loop, smart bandage with integrated sensors and stimulators for advanced wound care and accelerated healing. Nat Biotechnol | 2022 | 10.1038/s41587-022-01528-3 | peer-reviewed | NIH listing + press coverage (PMID 36424488) | prior art | impedance + temperature -> electrical stimulation, closed loop, wireless; thermoresponsive adhesive hydrogel releasing ~40 C; ~25% faster closure in mice | CONFIRMED | competitive landscape; ES deferred | mouse model; not LIG
L04 | Shirzaei Sani E, Xu C, ... Armstrong DG, Gao W. A stretchable wireless wearable bioelectronic system for multiplexed monitoring and combination treatment of infected chronic wounds. Sci Adv 9:eadf7388 | 2023 | 10.1126/sciadv.adf7388 | peer-reviewed | full text read 2026-10-14 | prior art | temperature, pH, NH4+, glucose, lactate, uric acid in wound exudate + ES + drug release; Au on SEBS (not LIG) | CONFIRMED | competitive landscape; analyte choice | microfabricated (cleanroom); rodents
L05 | Asgharian H, Kammarchedu V, Gu SJ, Ebrahimi A. WoundMx: multiplexed detection of wound infection biomarkers with a multimodal sensor system based on laser-induced graphene. Research Square preprint | 2025 | 10.21203/rs.3.rs-7274589/v1 | preprint | full text read via PMC12393471 | prior art / S3 | LIG on 0.005in Kapton; PANi pH -54 mV/pH buffer, -49 in wound-simulating medium, -26 on agar; UA by DPV; ESP32 + app; in vitro only | SUPPORTED | S3 design anchor; competitive landscape | preprint; peer-reviewed version (npj 2D Mater Appl) not checked
L06 | Singh SP, Li Y, Be'er A, Oren Y, Tour JM, Arnusch CJ. Laser-induced graphene layers and electrodes prevents microbial fouling and exerts antimicrobial action. ACS Appl Mater Interfaces | 2017 | 10.1021/acsami.7b04863 | peer-reviewed | title/authors + ACS SI listing; press coverage | LIG biology | LIG resists biofilm; at 1.1-2.5 V strongly antibacterial, partly via H2O2 | SUPPORTED | risk note for any DC on LIG electrodes | full text not read
L07 | Yang Y, Song Y, Bo X, ... Gao W. A laser-engraved wearable sensor for sensitive detection of uric acid and tyrosine in sweat. Nat Biotechnol 38:217-224 | 2019 | 10.1038/s41587-019-0321-x | peer-reviewed | DOI page + Caltech record | LIG sweat sensing | all-laser-engraved sensor: temperature, respiration, uric acid, tyrosine in sweat | SUPPORTED | sweat concept evaluation | online Nov 2019, print 2020; volume/pages not re-verified
L08 | Milne SD, Seoudi I, Al Hamad H, ... Connolly P. A wearable wound moisture sensor as an indicator for wound dressing change: an observational study of wound moisture and status. Int Wound J 13(6):1309-1314 | 2016 | 10.1111/iwj.12521 | peer-reviewed | full text read via PMC7950073 | clinical need S1 | WoundSense (impedance) readings: 44.9% (264/588) of dressing changes made while moisture optimal -> many unnecessary changes; DFU dressings wetter than pressure ulcers | CONFIRMED | UN-1 / S1 justification; competitor | observational; mixed dressings; sensor is spot-check not continuous
L09 | Armstrong DG, Holtz-Neiderer K, Wendel C, Mohler MJ, Kimbriel HR, Lavery LA. Skin temperature monitoring reduces the risk for diabetic foot ulceration in high-risk patients. Am J Med | 2007 | https://experts.arizona.edu/en/publications/skin-temperature-monitoring-reduces-the-risk-for-diabetic-foot-ul/ | peer-reviewed RCT | institutional record + trial summary | clinical need C9/S2 | RCT n=225; >4 F (~2.2 C) left-right difference triggered action; ulceration 12.2% vs 4.7% (OR 3.0, CI 1.0-8.5) | SUPPORTED | C9 pivot option; S2 relevance | author list and DOI not re-verified; CI lower bound at 1.0
L10 | Fierheller M, Sibbald RG. A clinical investigation into the relationship between increased periwound skin temperature and local wound infection in patients with chronic leg ulcers. Adv Skin Wound Care 23:369-379 | 2010 | 10.1097/01.ASW.0000383197.28192.98 | peer-reviewed | DOI from citing literature; abstract-level only | clinical need S2 | periwound skin temperature increase associated with local infection (n=40) | SUPPORTED | UN-2 / S2 | full text not read
L11 | (Authors not recorded) Wound bed temperature has potential to indicate infection status: a cross-sectional study | 2025 | https://pmc.ncbi.nlm.nih.gov/articles/PMC12315627/ | peer-reviewed | search abstract | clinical need S2 | n=267; wound-periwound temperature difference vs clinician infection status: fair correlation r=0.32 | SUPPORTED | tempers S2 claims (supplementary indicator only) | record authors/DOI before citing
L12 | Gethin G. The significance of surface pH in chronic wounds. Wounds UK 3:52-56 | 2007 | https://research.universityofgalway.ie/en/publications/the-significance-of-surface-ph-in-chronic-wounds/ | review | institutional record | clinical need S3 | chronic non-healing wounds tend to be alkaline; healing favoured in acidic environment; pH monitoring proposed | SUPPORTED | S3 justification | no DOI; NOTE Gethin et al. 2008 honey/pH study is RETRACTED - do not cite
L13 | Kuo SH, et al. Role of pH value in clinically relevant diagnosis. Diagnostics 10(2):107 | 2020 | 10.3390/diagnostics10020107 | review | search listing | clinical need S3 | pH as diagnostic marker incl. skin and wound status | SUPPORTED | S3 justification | read before quoting numbers
L14 | Fei, Huang, Shi. Humidity sensor composed of laser-induced graphene electrode and graphene oxide for monitoring respiration and skin moisture. Sensors 23(15):6784 | 2023 | 10.3390/s23156784 | peer-reviewed | abstract | LIG IDE / humidity | picosecond-laser LIG IDE + drop-cast GO; capacitive 10-90% RH; electrode gap studied; impedance used for mechanism | SUPPORTED | S1 IDE design ideas; C7 | different laser (ps); GO coating needed for humidity
L15 | Barber R, et al. Laser induced graphene sensors for assessing pH: application to wound management. Electrochem Commun 123:106914 | 2021 | https://pure.ulster.ac.uk/en/publications/laser-induced-graphene-sensors-for-assessing-ph-application-to-wo/ | peer-reviewed | search abstract | S3 | bare LIG potentiometric pH sub-Nernstian; riboflavin voltammetric ~56 mV/pH | SUPPORTED | S3: bare LIG is NOT a good pH sensor | DOI not recorded
L16 | (Authors not recorded) PANi-modified LIG potentiometric pH and uric acid sensors made with a low-cost visible laser on polyimide tape. ACS Omega 11(17):25139-25148 | 2026 | search listing only | peer-reviewed | search abstract | S3 | PANi-LIG 56.7 +/- 2.6 mV/pH (pH 4-10), <10 s response, stable 6 weeks; made on PI TAPE with low-cost laser | SUPPORTED | S3 design anchor (tape + cheap laser like ours) | record DOI and reference-electrode details before citing
L17 | Massaglia G, et al. Laser-induced graphene electrodes for flexible pH sensors. Nanomaterials 14(24):2008 | 2024 | 10.3390/nano14242008 | peer-reviewed | search abstract | S3 alternative | fully LIG 3-electrode pH with PEDOT:PSS; super-Nernstian 75.6 +/- 9.1 mV/pH (pH 1-7) | SUPPORTED | S3 alternative chemistry | acidic range only; large spread
L18 | (Penn State group) Moisture-resistant, stretchable NOx gas sensors based on laser-induced graphene for environmental monitoring and breath analysis. Microsyst Nanoeng | 2022 | https://pmc.ncbi.nlm.nih.gov/articles/PMC9270215/ | peer-reviewed | search abstract | C10 gas | LIG is hydrophilic -> humidity interferes; needed semipermeable encapsulation to tolerate 90% RH | SUPPORTED | reason to reject gas concept | record authors/DOI before citing
L19 | Review: Challenges and strategies in developing an enzymatic wearable sweat glucose biosensor | 2022 | https://pmc.ncbi.nlm.nih.gov/articles/PMC8781831/ | review | search abstract | C6 sweat glucose | sweat glucose ~0.01-1.1 mM vs blood 2-40 mM; sample volume, evaporation, enzyme instability; Berkeley work found no simple sweat-blood correlation | SUPPORTED | reason to reject sweat glucose | record authors before citing
L20 | Rezaei I, Haghverdi AB, Soldoozy A, Aghaee T, Biabanifard S. Wearable Kapton graphene biosensor for detection of toxic gases. J Hazard Mater Adv 15:100452 | 2024 | 10.1016/j.hazadv.2024.100452 | peer-reviewed | full text read | uploaded paper | CST simulation of 76-86 GHz graphene patch on 125 um Kapton; no fabrication; not LIG | WRONG (physics) - see paper_notes/rezaei2024_critique.md | critical evaluation only | do NOT use as feasibility evidence
L21 | (Several) Temperature coefficient of resistance of LIG on polyimide ~ -0.04 to -0.05 %/C (e.g. J Mater Chem C 2026, D5TC04055H) | 2026 | https://pubs.rsc.org/en/Content/ArticleLanding/2026/TC/D5TC04055H | peer-reviewed | search snippets only | S2 | LIG/PI is a weak NTC thermistor (~-0.05 %/C) -> needs good ADC; humidity/strain cross-sensitivity | SUPPORTED | S2 design; ES-3 | full text not read; we will MEASURE ours
L22 | DuPont statement on use of DuPont materials in medical applications (+ Kapton datasheet caution H-50102) | 2019 | https://www.dupont.com/position-statements/medical-applications-policy.html | manufacturer statement | web page | materials/regulatory | Kapton is not sold as medical grade; caution against implantation; trademark not to be used with medical devices without agreement | CONFIRMED | PR-8 wording; risk register
L23 | Escobar-Chavez JJ, et al. Applications of thermo-reversible Pluronic F-127 gels in pharmaceutical formulations. J Pharm Pharm Sci 9(3):339-358 | 2006 | https://sites.ualberta.ca/~csps/JPPS9_3/Article_349/art349.html | review | web page | materials | F-127 is a reverse thermogel: liquid cold -> gel warm; reverses on cooling | CONFIRMED | correction of v1 hydrogel claim | first author name from memory - check page
L24 | Analog Devices AD5940/AD5941 datasheet and product pages | 2024 | https://www.analog.com/en/products/ad5941.html | datasheet | product page + distributor listings | electronics | impedance to 200 kHz (HS loop), low-power potentiostat, 16-bit ADC; AD5940 = WLCSP-56 (not hand-solderable), AD5941 = LFCSP-48 | CONFIRMED | Phase B AFE | check full datasheet before schematic
L25 | Espressif ESP32-C3 datasheet | 2025 | https://documentation.espressif.com/api/resource/doc/file/aYwvqd1B/FILE/esp32-c3_datasheet_en.pdf | datasheet | search of datasheet text | electronics | BLE 5; 2x 12-bit SAR ADC; no DAC in feature list; chip deep-sleep 5 uA (boards draw more, e.g. ~43 uA) | CONFIRMED | MCU choice; power budget | BLE TX current not yet read
L26 | McColl D, Cartlidge B, Connolly P. Real-time monitoring of moisture levels in wound dressings in vitro: an experimental study. Int J Surg 5(5):316-322 | 2007 | 10.1016/j.ijsu.2007.02.008 | peer-reviewed | Strathclyde repository abstract + PubMed listing | prior art (moisture mapping) | model wound bed + fluid injection + 8 monitoring points beneath dressing; moisture across dressings non-uniform; parts of foam dressings dried during constant injection | SUPPORTED | differentiator prior art (spatial mapping not novel) | full text not read
L27 | US patents on wound moisture maps / impedance dressings: US 11141100, US 11744511, US 12458278, US 12414881 (moisture assessment systems); US 10716490 (dressing with impedance sensor); US 12714606 (moisture sensor) | 2015-2026 | https://image-ppubs.uspto.gov/dirsearch-public/print/downloadPdf/11141100 | patents | search snippets only | prior art / IP | multi-element moisture arrays and moisture maps around wounds; occlusion/maceration problem of array sensors on insulating substrates (10716490) | SUPPORTED | freedom-to-operate check needed before any IP claim | claims not read - patent attorney/search needed
L28 | Dressing manufacturer instructions: some foam dressings 'change when exudate approaches 2 cm from the edge'; 3M Tegaderm silicone foam border 'when exudate spreads to the edges of the foam pad'; Molnlycke Mepilex Border Flex 'saturated when strike-through reaches 3 edges' | 2020-2025 | https://www.molnlycke.com/globalassets/local/anz/campaigns/mepilex-border-flex_time-to-change_brochure.pdf | manufacturer IFU | search snippets of IFU documents | application (change criterion) | dressing change criterion is spatial (distance of exudate front from pad edge) | SUPPORTED | H-APP1 framing | product-specific; quote the exact IFU of the dressing used in tests
L29 | EN 13726-1:2002 Test methods for primary wound dressings - absorbency ('Solution A': 142 mmol/L Na+, 2.5 mmol/L Ca2+ as chlorides); replaced by EN 13726:2023 | 2002/2023 | https://iteh.es/catalog/standards/cen/3eb17b79-e68a-4ea2-a2a8-dd6d98145e73/en-13726-1-2002 | standard | catalogue + citing papers | test method | simulated exudate composition for bench dressing tests | SUPPORTED | E3 test fluid | check 2023 edition text if available; Solution A is a simplified protein-free fluid
L30 | (Javeriana / Caltech authors) Influence of lasing parameters on the morphology and electrical resistance of polyimide-based laser-induced graphene. Carbon Letters | 2023 | https://perfilesycapacidades.javeriana.edu.co/en/publications/influence-of-lasing-parameters-on-the-morphology-and-electrical-r/ | peer-reviewed | search abstract | LIG process / reproducibility | desktop CO2 unit limited LIG quality via inconsistent scribing speed and poor thermal management; passes and spot overlap reduce Rs; PI brand strongly affects LIG quality | SUPPORTED | research gap rows 2-4 | record authors/DOI from full text
L31 | (UCC Cork authors) Design of experiments and optimization of laser-induced graphene | 2023 | https://research.ucc.ie/en/publications/design-of-experiments-and-optimization-of-laser-induced-graphene/ | peer-reviewed | search abstract | LIG process | Rs global minimum at low speed (70 mm/s) and low power (2.1 W) and a second minimum at 340 mm/s, 3.4 W; minima do not follow constant power/speed ratio | SUPPORTED | E1 design (interactions matter) | record DOI and Rs values from full text
L32 | (Authors not recorded) LIG with continuous-wave CO2 laser: conductivity 7.7-10 S/cm, Rs 26-49 ohm/sq, contact resistivity 9-43 ohm.mm2 for fluence 31-137 J/cm2 | 2024 | https://journals.ioffe.ru/articles/viewPDF/62275 | peer-reviewed | search snippet | LIG process | fluence rather than power alone drives Rs | SUPPORTED-WEAK | benchmark ranges | verify authors, journal and values from the PDF
L33 | (Authors not recorded) 40 W CO2 laser LIG: optimum at 2.9 W optical, 29 J/cm2, 100 mm/s, 0.1 mm focal diameter | 2025 | search snippet only | peer-reviewed? | search snippet | LIG process | example of reporting delivered optical power rather than % setting | UNCERTAIN | illustrates why '12' must be converted to measured quantities | source not identified - do not cite until found
L34 | Engineering blog measurements of CO2 laser tube current vs PWM (softsolder.com series, 2022-2024) | 2022 | https://softsolder.com/2022/09/29/co₂-laser-tube-current-variable-power/ | engineering blog (not peer-reviewed) | web pages via search | laser source behaviour | below ~25 % PWM tube current appears as high spiky pulses with little difference between settings; mid-range roughly linear | SUPPORTED-WEAK | research gap row 4; E1 Session 0 | non-peer-reviewed; different machine/PSU
L35 | LightBurn forum user data: 90 W tube on Ruida controller, ~6 mA at 25 %, ~18 mA at 50 %, ~31 mA above 85 % | 2024 | https://forum.lightburnsoftware.com/t/reasons-to-tune-my-psu-to-my-tube-ratings/116722 | user forum | search snippet | laser source behaviour | setting % to tube current is non-linear and machine-specific | SUPPORTED-WEAK | why we measure our own mA | anecdotal
L36 | Le et al. Machine-learning prediction of sheet resistance of laser-induced graphitic carbon. Flexible and Printed Electronics | 2023 | https://www.eecs.yorku.ca/~grau/Publications/Le%20et%20al%20LIG%20ML%20sheet%20resistance%20prediction%202023.pdf | peer-reviewed | search listing | LIG process | ML models predict Rs from laser settings | SUPPORTED | research gap row 2 (parameter-property mapping well studied) | full text not read
L39 | Wounds UK news: 'New research finds UK nurses carry out 180 wound dressing changes a year - on each chronic wound patient' (survey of >200 people with chronic wounds, conducted by Molnlycke, Aug 2018) | 2018 | https://wounds-uk.com/must-reads/new-research-finds-uk-nurses-carry-out-180-wound-dressing-changes-a-year-on-each-chronic-wound-patient/ | industry-sponsored survey (news report) | web page read 2026-10-19 | workload benchmark | patients report an average dressing time of 18 min; changes on average 5 times a week; 80 % at least twice weekly; 35 % daily | SUPPORTED-WEAK | slide 3 time benchmark | patient-reported, UK, sponsored by a dressing maker; headline 180/yr does not match 5/week; not a time-and-motion study
L40 | Smith+Nephew ALLEVYN LIFE product page (Australia pharmacy range): change indicator | 2026 | https://prod-we-cm.smith-nephew.com/en-au/pharmacy/product-range/healthcare-in-the-home/allevyn-life | manufacturer web page | web page read 2026-10-19 | prior art (visual change indicator) | 'has a change indicator that lets you know when dressing changes are needed'; 'At 75%, it's time to change your dressing'; up to 7-day wear | SUPPORTED | slides 2, 12: makers already define a visual change point; it is hidden when the dressing is covered | marketing page; indicator is visual, so it needs the dressing face to be visible
L41 | Indian retail listings (Truemeds): Mepilex Lite 10x10 cm and Mepilex Border 10x10 cm foam dressings | 2025 | https://www.truemeds.in/otc/mepilex-lite-10-x-10cm-dressing-1-tm-sual1-000048 ; https://www.truemeds.in/otc/mepilex-border-10-x-10cm4-x-4in-dressing-1-tm-sual1-000046 | retail price listing | Border page read 2026-10-19; Lite price from search listing | cost benchmark | Mepilex Lite 10x10 cm: Rs 241.86 (MRP 268.73), single dressing; Mepilex Border 10x10 cm: Rs 514.14 (MRP 571.27) | SUPPORTED-WEAK | slide 3 material cost per change; payback estimate | Border listing says 'box of 1' in the title but '5 dressings' in the text; prices dated Feb 2025; one retailer only
L42 | Vishwakarma Awards 2026-27 official website (Maker Bhavan Foundation): themes, timeline, eligibility, FAQ judging criteria | 2026 | https://vishwakarma-awards.org/ | organiser website | web page read 2026-10-19 | competition rules | Stage 2 = PPT of design specifications; prototype stage = 3-min video + updated PPT (Dec); semi-final virtual interviews (IIT Indore: Jan); IIT Indore finale 26 Jan - 1 Feb 2027; criteria: relevance, effectiveness, clarity, uniqueness, patentability, commercial viability, fact check, ease of use; only work done during the programme is evaluated; working hardware required | SUPPORTED | STAGE2_CHECKLIST.md; roadmap (D-014) | page mixes open/closed application wording; no stage-specific rubric weights
L43 | Internshala competition listing: Vishwakarma Awards 2026-27 | 2026 | https://internshala.com/competitions/vishwakarma-awards-2026-27/ | third-party listing | web page read 2026-10-19 | competition rules | design proposal submission 16 Oct 2026; design results 26 Oct 2026; prototype submission 4 Dec 2026; prizes per theme Rs 2,00,000 / 1,00,000 / 50,000; Rs 30,000 grant per finalist | SUPPORTED-WEAK | STAGE2_CHECKLIST.md; roadmap (D-014) | its 16 Oct design date conflicts with the organiser's email to us (25 Oct 2026, 23:59); the email is the direct instruction - confirm with the organisers
