soham0777/dermasense-vishwakarma-2026/2_research/research_matrix.csv

id | source | doi_or_link | read_level | type | material | laser_and_process | characterisation | measured_results | limitations | relevance_to_us | engineering_decision_supported
L01 | Lin et al., Nat Commun 5:5714 (2014) | 10.1038/ncomms6714 | full text | peer-reviewed experiment | Kapton PI, 0.005 in (127 um) | CO2 10.6 um, ~14 us pulses, ~120 um beam, 2.4-5.4 W, 3.5 in/s (~89 mm/s), 1000 ppi, air | sheet resistance, Raman, XPS, BET, SEM/TEM, CV (supercapacitors) | Rs <35 ohm/sq at 2.4 W threshold, <15 ohm/sq at 5.4 W; BET ~340 m2/g; C 97 at%; areal capacitance >4 mF/cm2 at 20 mV/s in 1 M H2SO4 | different laser (ULS); capacitance in acid electrolyte, not saline | benchmarks for Rs and process window; capacitance order of magnitude | E1 acceptance thinking (Rs tens of ohm/sq is achievable); readout calc: double-layer charging negligible -> bipolar DC pulses acceptable (calc_readout.py)
L37 | Li et al., Adv Mater 29:1700496 (2017) - LIG in controlled atmospheres | 10.1002/adma.201700496 | abstract + press + patent summary | peer-reviewed experiment | PI | CO2 laser in O2/air vs Ar/H2 atmospheres | water contact angle | contact angle 0 deg (air/O2, superhydrophilic) vs >150 deg (Ar/H2) | our atmosphere is air; no data on aged surfaces | exudate will wet LIG electrodes, and can wick along exposed LIG traces | all traces outside sensing windows must be sealed (polyimide tape); zone windows sized to define the wetted area
L08 | Milne et al., Int Wound J 13(6):1309-1314 (2016) | 10.1111/iwj.12521 | full text | observational clinical study | WoundSense Ag/AgCl impedance sensor | n/a | spot impedance readings in 5 moisture bands at dressing change (n=30 patients, 588 readings) | 44.9 % of changes made in optimum moisture band | observational; mixed dressings; spot-check device; not an RCT | baseline inefficiency figure for the user journey (published evidence) | quantified before-state (cite as published evidence only)
L26 | McColl, Cartlidge, Connolly, Int J Surg 5(5):316-322 (2007) | 10.1016/j.ijsu.2007.02.008 | abstract | peer-reviewed bench study | electrode array under dressings | n/a | 8-point impedance moisture mapping with fluid injection | moisture distribution non-uniform; some foam regions dried during constant injection | abstract only | prior art for spatial moisture sensing; motivates measuring spread, not one point | multi-zone concept is prior art -> novelty limited to change-line placement + LIG process
L28 | Dressing instructions for use (foam dressings with 2 cm rule; Molnlycke Mepilex Border Flex; 3M Tegaderm silicone foam border) | https://www.molnlycke.com/globalassets/local/anz/campaigns/mepilex-border-flex_time-to-change_brochure.pdf | search snippets | manufacturer IFU | dressings | n/a | n/a | change when exudate approaches ~2 cm from pad edge (some foams); saturated when strike-through reaches 3 edges (Mepilex) | product-specific; read exact IFU of dressing actually tested | defines the change line the strip must detect | alert zone A placed at the IFU change line of the specific test dressing
L29 | EN 13726-1:2002 (replaced by EN 13726:2023) - absorbency test methods | https://iteh.es/catalog/standards/cen/3eb17b79-e68a-4ea2-a2a8-dd6d98145e73/en-13726-1-2002 | catalogue + citing papers | standard | 'Solution A': 142 mmol/L Na+, 2.5 mmol/L Ca2+ (chlorides) | n/a | gravimetric absorbency | n/a | protein-free; free-swell method criticised as non-physiological | simulated exudate recipe for bench tests | E3 uses Solution A (documented recipe) and directional inflow from a centre port, not free swell
L38 | Dealey C, Cameron J, Arrowsmith M. A study comparing two objective methods of quantifying the production of wound exudate. J Wound Care 15(4):149-153 (2006) | https://research.birmingham.ac.uk/en/publications/a-study-comparing-two-objective-methods-of-quantifying-the-produc | abstract (repository page read 2026-10-15) | clinical method study | n/a | n/a | gravimetric / canister methods | 0.10-0.21 g/cm2/24h (2 patients, one method); mean 1.3 g/cm2/24h (one method, 5 patients) - methods disagree | tiny sample; which value belongs to which method unclear | order of magnitude of real exudate rates | E3 runs at accelerated inflow (documented); real-time rates are 10-100x slower -> state that bench timing is not clinical timing
L30 | Influence of lasing parameters on morphology and electrical resistance of PI-based LIG, Carbon Letters (2023) | https://perfilesycapacidades.javeriana.edu.co/en/publications/influence-of-lasing-parameters-on-the-morphology-and-electrical-r/ | abstract | peer-reviewed experiment | PI (several brands) | desktop CO2 laser; power, speed, passes, spot overlap | Raman, sheet resistance, SEM | passes and spot overlap reduce Rs; PI brand strongly affects quality; desktop unit limited by speed control and thermal management | abstract only | process variability is real; film brand is a variable | record film brand/lot in every E1 row; keep one roll for all experiments
L31 | Design of experiments and optimization of LIG (UCC Cork, 2023) | https://research.ucc.ie/en/publications/design-of-experiments-and-optimization-of-laser-induced-graphene/ | abstract | peer-reviewed experiment | PI | CO2 laser engraver; power x speed DoE | sheet resistance | Rs minima at (70 mm/s, 2.1 W) and (340 mm/s, 3.4 W); minima do not follow constant power/speed ratio | abstract only | parameter interactions matter | E1 brackets power AND speed around the reference rather than assuming a P/v rule
L32 | (Authors not recorded) CW CO2 LIG fluence study (2024) | https://journals.ioffe.ru/articles/viewPDF/62275 | search snippet | peer-reviewed experiment | PI | CW CO2; fluence 31-137 J/cm2 | conductivity, Rs, contact resistivity | Rs 26-49 ohm/sq; contact resistivity 9-43 ohm.mm2 | authors/journal not verified | contact resistance to LIG is significant | transmission-line (3-length) test separates contact from material resistance
L34 | softsolder.com CO2 tube current vs PWM measurements (2022) | https://softsolder.com/2022/09/29/co%e2%82%82-laser-tube-current-variable-power/ | web pages | engineering blog (not peer-reviewed) | n/a | glass CO2 tube + PSU | oscilloscope tube current | below ~25 % PWM current is spiky with little difference between settings | different machine; not peer-reviewed | our '12' sits in the low-PWM range | E1 logs tube current per setting and repeats the reference on 2 days
L05 | Asgharian et al., WoundMx preprint (2025) | 10.21203/rs.3.rs-7274589/v1 | full text | preprint experiment | LIG on 0.005 in Kapton | ULS VLS2.30, 12.6 % power, 5.5 % speed, 1000 ppi | OCP, DPV, EGFET in buffer, wound-simulating medium, agar | pH -54 mV/pH (buffer) falling to -26 mV/pH on agar | in vitro only; preprint | LIG wound sensors exist in labs; sensitivity drops in realistic media | do not claim chemical sensing; moisture-front sensing is physically simpler
L03 | Jiang et al., Nat Biotechnol (2022) | 10.1038/s41587-022-01528-3 | abstract + press | peer-reviewed experiment (mice) | PEDOT:PSS hydrogel electrodes + flexible electronics | n/a | impedance, temperature, ES in mouse wounds | ~25 % faster closure in mice | animal model; complex electronics | closed-loop therapy is prior art and out of our reach | therapy deferred; scope = moisture-front indication only
P01 | US 5,469,145 and US 5,838,240 - Wet diaper detector (detachable conductor strip + clip-on detector) | https://patents.google.com/patent/US5469145A/en | search summary | patent | embedded spaced conductors in disposable strip | n/a | n/a | n/a | claims not read; legal status not checked | architecture prior art: disposable strip + reusable clip-on reader | no novelty claim on architecture; patent check before any IP filing
P02 | US 9,291,589 - Wearable articles with wetness sensing (carbon-ink electrodes on PE film); US 10,928,344 - slotted sensor for diaper moisture (detachable strip) | https://patents.google.com/patent/US10928344 | search summary | patent | printed carbon electrodes on polymer film | n/a | n/a | n/a | claims not read; US 10,928,344 listed as active (Google assumption) | printed-electrode film wetness strips are prior art; LIG is a different way to make the electrodes | freedom-to-operate check needed; our contribution must be the wound-dressing change-line use + validation, not the strip itself
L20 | Rezaei et al., J Hazard Mater Adv 15:100452 (2024) - uploaded paper | 10.1016/j.hazadv.2024.100452 | full text | simulation only (CST) | idealised graphene sheet on 125 um Kapton | no laser; no fabrication | S11 simulation 76-86 GHz | claimed 0.12-2.4 % resonance shifts for gases | physically implausible by ~10^6; no experiment | none for design | not used as evidence (D-007)
