soham0777/dermasense-vishwakarma-2026/4_sensor_strip/e2_experiment/e2_res_coupon.dxf

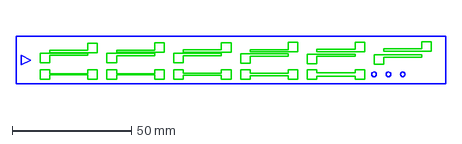
[picture p39: CAD file, 2026-10-14]
4_sensor_strip/e2_experiment/e2_res_coupon.dxf
180.0 x 20.0 mm
