soham0777/dermasense-vishwakarma-2026/4_sensor_strip/strip_v0_1.dxf

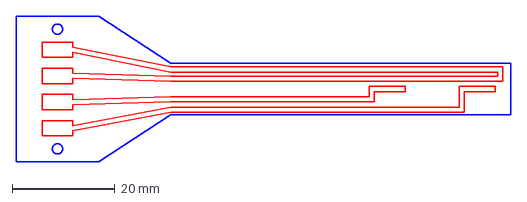
[picture p40: CAD file, 2026-10-14]
4_sensor_strip/strip_v0_1.dxf
96.0 x 28.2 mm
