soham0777/dermasense-vishwakarma-2026/5_cad/solidworks/rig_base_v0_1.STEP

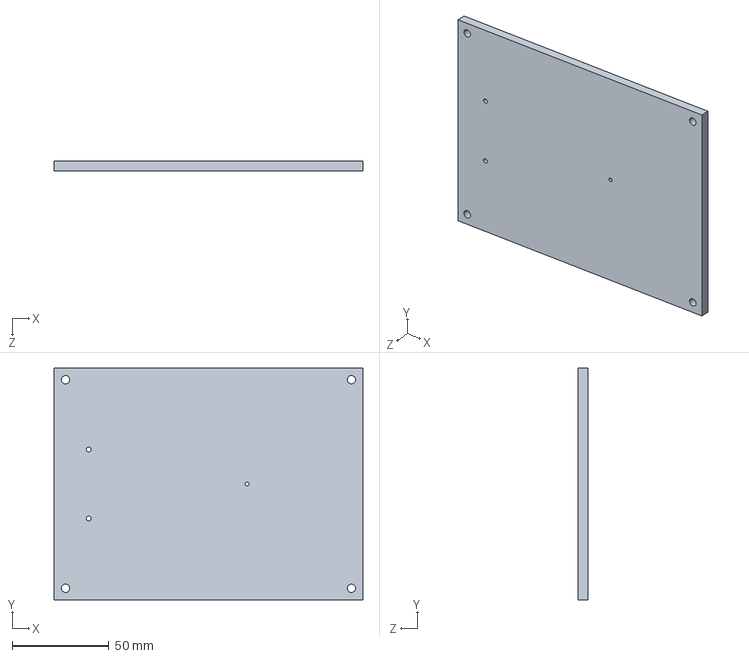
[picture p41: CAD file, 2026-10-14]
5_cad/solidworks/rig_base_v0_1.STEP
160.0 x 120.0 x 5.00 mm
