soham0777/dermasense-vishwakarma-2026/4_sensor_strip/strip_v0_1_encap.dxf

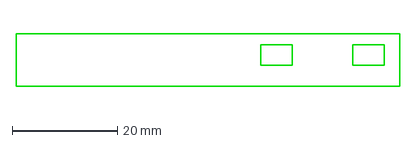
[picture p42: CAD file, 2026-10-14]
4_sensor_strip/strip_v0_1_encap.dxf
73.0 x 10.0 mm
