soham0777/dermasense-vishwakarma-2026/5_cad/solidworks/dressing_reference_bordered_foam.STEP

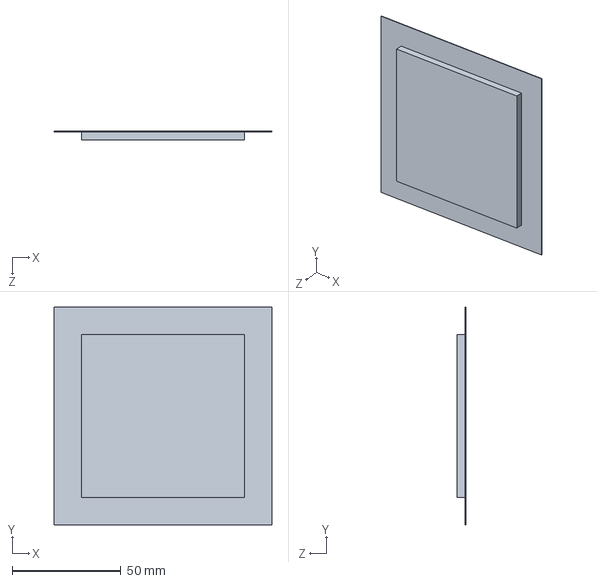
[picture p43: CAD file, 2026-10-14]
5_cad/solidworks/dressing_reference_bordered_foam.STEP
100.0 x 100.0 x 4.00 mm
