soham0777/dermasense-vishwakarma-2026/4_sensor_strip/lig_test_coupon.dxf

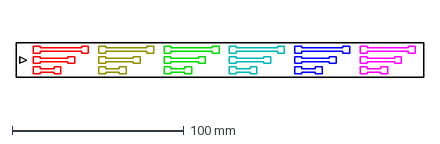
[picture p44: CAD file, 2026-10-14]
4_sensor_strip/lig_test_coupon.dxf
237.0 x 20.0 mm
