soham0777/dermasense-vishwakarma-2026/5_cad/solidworks/pogo_pin_P75_simplified.STEP

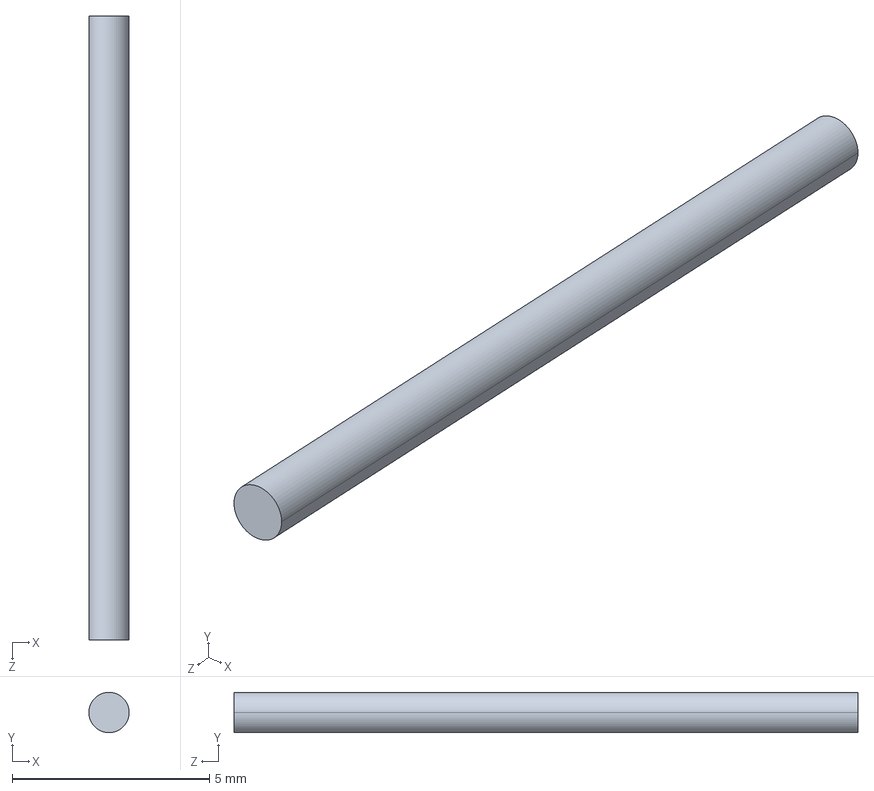
[picture p45: CAD file, 2026-10-14]
5_cad/solidworks/pogo_pin_P75_simplified.STEP
1.02 x 1.02 x 15.8 mm
