soham0777/dermasense-vishwakarma-2026/5_cad/solidworks/clamp_base_v0_1.STEP

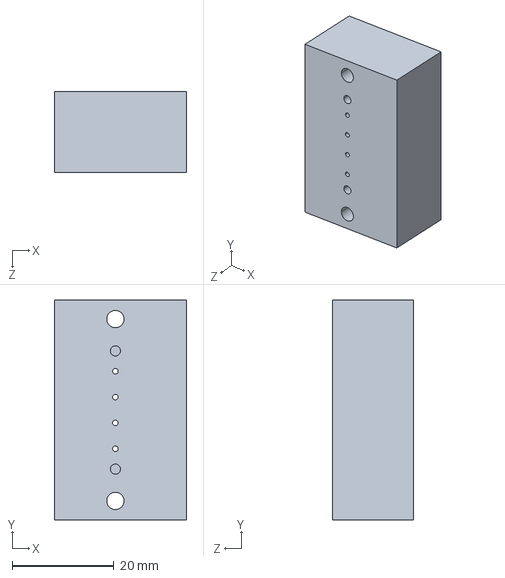
[picture p46: CAD file, 2026-10-14]
5_cad/solidworks/clamp_base_v0_1.STEP
26.0 x 43.2 x 16.0 mm
