soham0777/dermasense-vishwakarma-2026/5_cad/solidworks/dowel_2x12.STEP

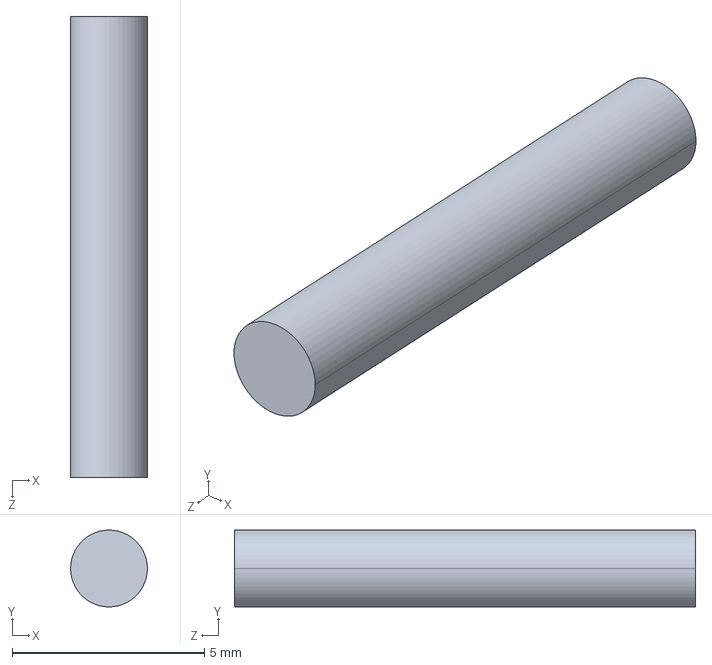
[picture p47: CAD file, 2026-10-14]
5_cad/solidworks/dowel_2x12.STEP
2.00 x 2.00 x 12.0 mm
