soham0777/dermasense-vishwakarma-2026/5_cad/solidworks/clamp_lid_v0_1.STEP

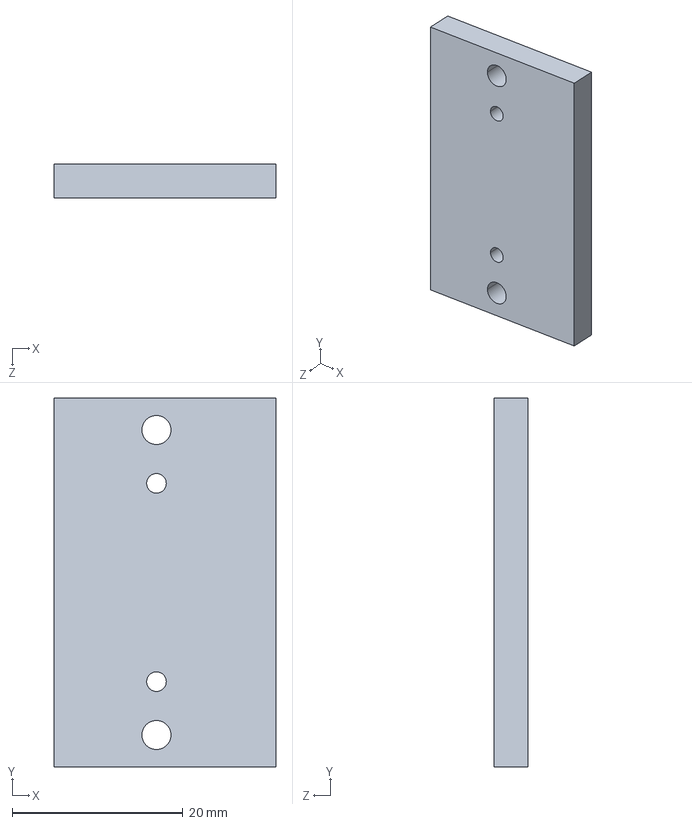
[picture p48: CAD file, 2026-10-14]
5_cad/solidworks/clamp_lid_v0_1.STEP
26.0 x 43.2 x 4.00 mm
