soham0777/dermasense-vishwakarma-2026/5_cad/solidworks/dermasense_bench_v0_1.STEP

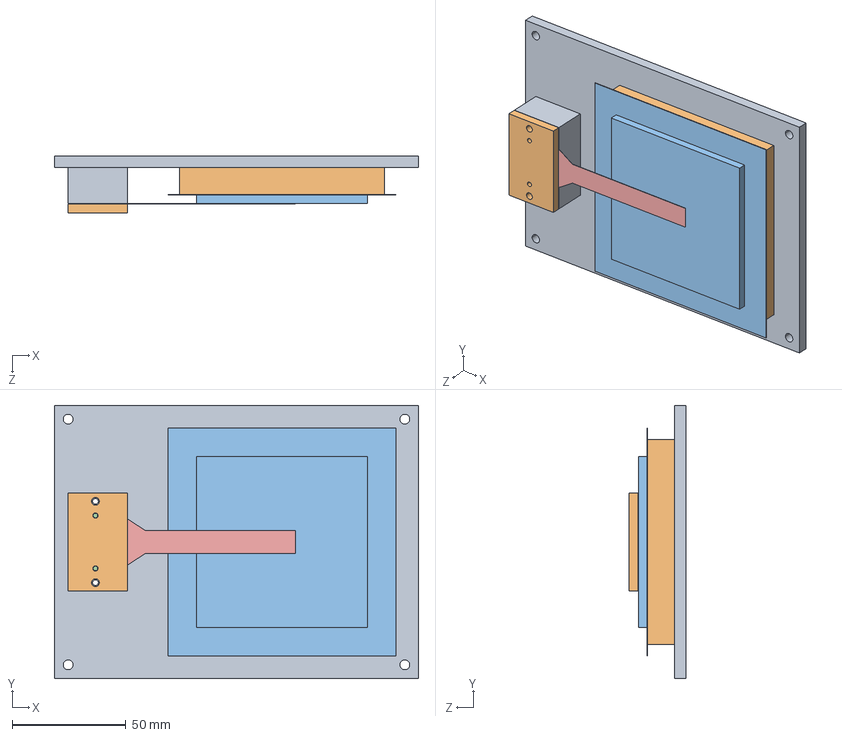
[picture p49: CAD file, 2026-10-14]
5_cad/solidworks/dermasense_bench_v0_1.STEP
160.0 x 120.0 x 25.1 mm
rig_base_v0_1
wound_bed_spacer_v0_1
dressing_reference_bordered_foam
seal_v0_1
strip_v0_1
clamp_base_v0_1
clamp_lid_v0_1
pogo_pin_P75_simplified x 4
dowel_2x12 x 2
