soham0777/dermasense-vishwakarma-2026/5_cad/solidworks/seal_v0_1.STEP

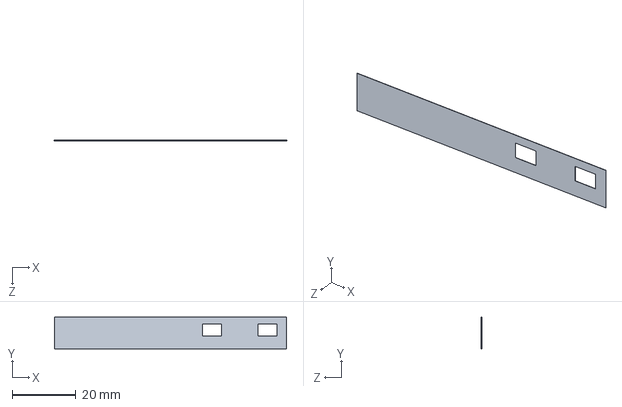
[picture p50: CAD file, 2026-10-14]
5_cad/solidworks/seal_v0_1.STEP
73.0 x 10.0 x 0.09 mm
