soham0777/dermasense-vishwakarma-2026/5_cad/solidworks/wound_bed_spacer_v0_1.STEP

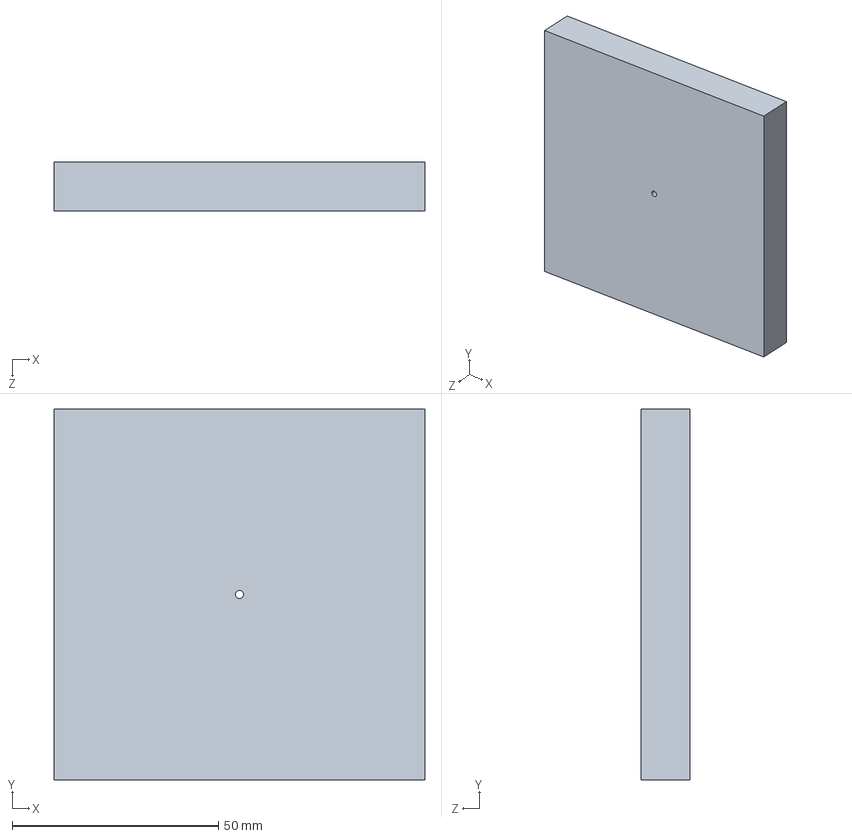
[picture p51: CAD file, 2026-10-14]
5_cad/solidworks/wound_bed_spacer_v0_1.STEP
90.0 x 90.0 x 11.9 mm
