soham0777/dermasense-vishwakarma-2026/5_cad/solidworks/strip_v0_1.STEP

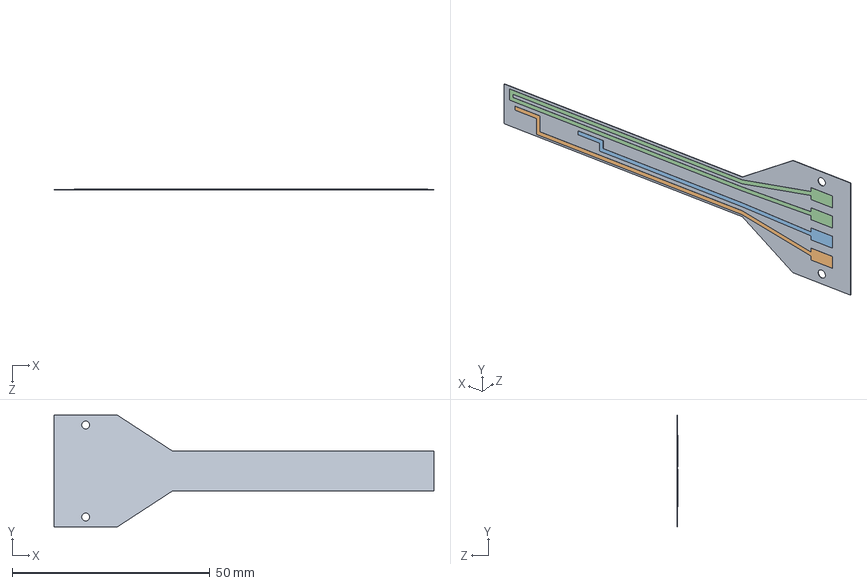
[picture p52: CAD file, 2026-10-14]
5_cad/solidworks/strip_v0_1.STEP
96.0 x 28.2 x 0.145 mm
