soham0777/dermasense-vishwakarma-2026/(list of files, cad)

Other CAD files:
5_cad/solidworks/clamp_base_v0_1.SLDDRW
5_cad/solidworks/clamp_base_v0_1.SLDPRT
5_cad/solidworks/clamp_lid_v0_1.SLDDRW
5_cad/solidworks/clamp_lid_v0_1.SLDPRT
5_cad/solidworks/dermasense_bench_v0_1.SLDASM
5_cad/solidworks/dermasense_bench_v0_1.SLDDRW
5_cad/solidworks/dowel_2x12.SLDPRT
5_cad/solidworks/dressing_reference_bordered_foam.SLDPRT
5_cad/solidworks/pogo_pin_P75_simplified.SLDPRT
5_cad/solidworks/rig_base_v0_1.SLDDRW
5_cad/solidworks/rig_base_v0_1.SLDPRT
5_cad/solidworks/seal_v0_1.SLDDRW
5_cad/solidworks/seal_v0_1.SLDPRT
5_cad/solidworks/strip_v0_1.SLDDRW
5_cad/solidworks/strip_v0_1.SLDPRT
5_cad/solidworks/wound_bed_spacer_v0_1.SLDDRW
5_cad/solidworks/wound_bed_spacer_v0_1.SLDPRT
