soham0777/dermasense-vishwakarma-2026/7_firmware/WIRING.md

# Reader v0.1: point-to-point wiring (perfboard)

Generated by `tools/check_consistency.py` from the KiCad netlist. **Do not edit by hand.**
Each row is one electrical node: join everything in the row.
Check every row with the multimeter's continuity beeper before applying power.

| Net | Connect together |
|---|---|
| `+3V3` | SuperMini 3V3 · ADS1115 VDD · ADS1115 A1 |
| `COM1` | pogo pin 3 (strip COM_1) · R3 (1k) end 1 |
| `COM2` | pogo pin 4 (strip COM_2) · R4 (1k) end 2 |
| `DRV_A` | SuperMini GPIO4 · R2 (1k) end 1 |
| `DRV_C` | SuperMini GPIO3 · R1 (1k) end 1 |
| `DRV_CHK` | SuperMini GPIO20 · R6 (100k 0.1%) end 1 |
| `DRV_LOOP` | SuperMini GPIO5 · R4 (1k) end 1 |
| `DRV_REF` | SuperMini GPIO10 · R5 (100k 0.1%) end 1 |
| `GND` | C1 (10nF C0G) end 2 · D1 LED cathode (-) · D2 LED cathode (-) · D3 LED cathode (-) · SuperMini GND · ADS1115 GND · ADS1115 ADDR |
| `LED_G` | SuperMini GPIO0 · R7 (1k) end 1 |
| `LED_R` | SuperMini GPIO21 · R9 (1k) end 1 |
| `LED_Y` | SuperMini GPIO1 · R8 (1k) end 1 |
| `N` | C1 (10nF C0G) end 1 · ADS1115 A0 · R3 (1k) end 2 · R5 (100k 0.1%) end 2 · R6 (100k 0.1%) end 2 |
| `Net-(D1-A)` | D1 LED anode (+) · R7 (1k) end 2 |
| `Net-(D2-A)` | D2 LED anode (+) · R8 (1k) end 2 |
| `Net-(D3-A)` | D3 LED anode (+) · R9 (1k) end 2 |
| `SCL` | SuperMini GPIO7 · ADS1115 SCL |
| `SDA` | SuperMini GPIO6 · ADS1115 SDA |
| `S_A` | pogo pin 2 (strip SENSE_A) · R2 (1k) end 2 |
| `S_C` | pogo pin 1 (strip SENSE_C) · R1 (1k) end 2 |

**Leave unconnected:** ADS1115 A2, ADS1115 A3, ADS1115 ALRT, SuperMini 5V, SuperMini GPIO2, SuperMini GPIO8, SuperMini GPIO9

**Parts:** C1 10nF C0G, D1 LED green OK, D2 LED amber CHANGE, D3 LED red CHECK/FAULT, J1 SuperMini left header, J2 SuperMini right header, J3 ADS1115 module header, J4 Strip pads (pogo P75-B1), R1 1k, R2 1k, R3 1k, R4 1k, R5 100k 0.1%, R6 100k 0.1%, R7 1k, R8 1k, R9 1k

R5 and R6 must be 0.1 % parts (they set the accuracy). C1 must be C0G/NP0.
