soham0777/dermasense-vishwakarma-2026/1_presentation/figures/cad_assembly_iso.png

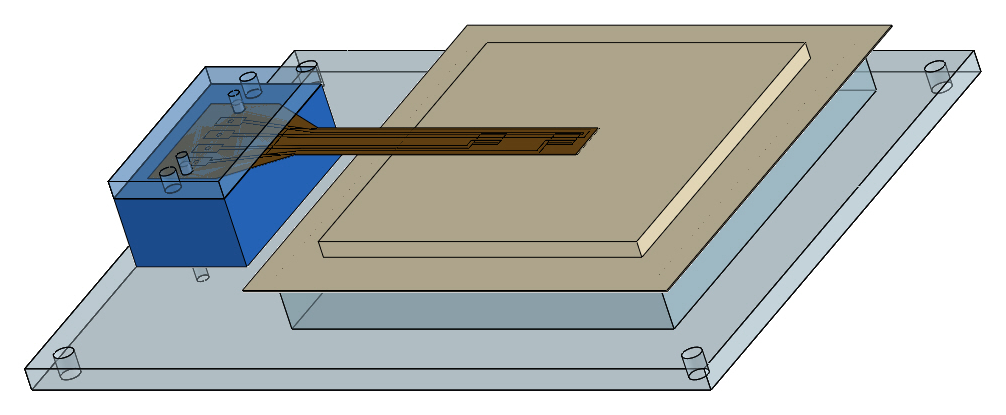
1_presentation/figures/cad_assembly_iso.png
