soham0777/dermasense-vishwakarma-2026/Stage2_Review_Output_2026-10-20/build/assets/placeholder_team_photo.png

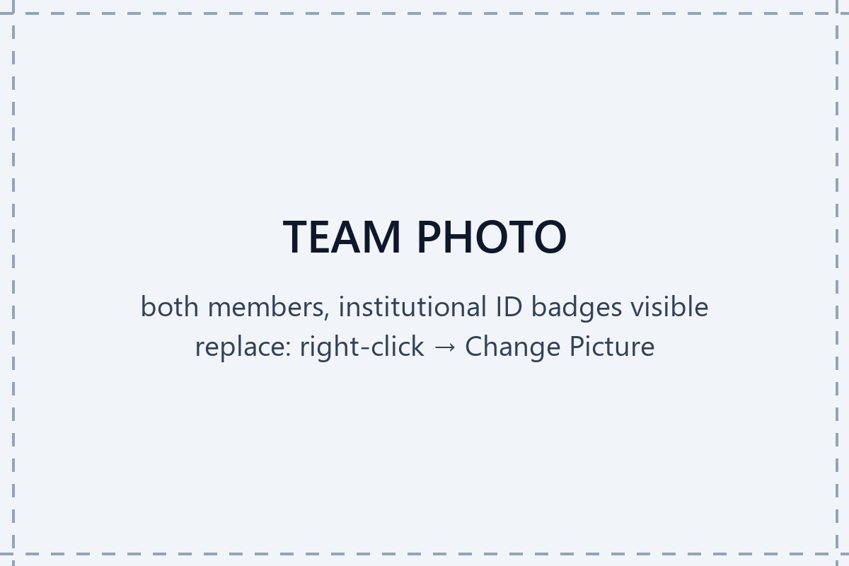
Stage2_Review_Output_2026-10-20/build/assets/placeholder_team_photo.png
