soham0777/dermasense-vishwakarma-2026/4_sensor_strip/e2_experiment/e2_machine_log.csv

coupon_id | date_time | layer_colour | purpose | mode_planned | power_planned | speed_planned_mm_s | interval_planned_mm | entered_mode | entered_min_power | entered_max_power | power_field_units | entered_speed_mm_s | entered_interval_mm | entered_passes | scan_direction_X_or_Y | bidirectional_YN | layer_order_no | focus_method_and_height | air_assist | tube_current_mA | job_file_name | screenshot_photo | notes
E2-A-R |  | RED | speed ladder | Scan | 12 | 50 | 0.1
E2-A-R |  | YELLOW | speed ladder | Scan | 12 | 100 | 0.1
E2-A-R |  | GREEN | speed ladder | Scan | 12 | 150 | 0.1
E2-A-R |  | CYAN | speed ladder | Scan | 12 | 200 | 0.1
E2-A-R |  | BLUE | speed ladder | Scan | 12 | 300 | 0.1
E2-A-R |  | MAGENTA | speed ladder | Scan | 12 | 400 | 0.1
CUTSEARCH |  | BLUE | cut attempt 1 | Cut | ref + 3 per step | 20
CUTSEARCH |  | BLUE | cut attempt 2 | Cut | ref + 3 per step | 20
CUTSEARCH |  | BLUE | cut attempt 3 | Cut | ref + 3 per step | 20
CUTSEARCH |  | BLUE | cut attempt 4 | Cut | ref + 3 per step | 20
CUTSEARCH |  | BLUE | cut attempt 5 | Cut | ref + 3 per step | 20
CUTSEARCH |  | BLUE | cut attempt 6 | Cut | ref + 3 per step | 20
CUTSEARCH |  | BLUE | cut attempt 7 | Cut | ref + 3 per step | 20
CUTSEARCH |  | BLUE | cut attempt 8 | Cut | ref + 3 per step | 20
E2-A-D1-C1 |  | RED | power -2 | Scan | 10 | S_ref | 0.1
E2-A-D1-C1 |  | YELLOW | speed -33 % | Scan | 12 | 0.67 x S_ref | 0.1
E2-A-D1-C1 |  | GREEN | REFERENCE replicate 1 | Scan | 12 | S_ref | 0.1
E2-A-D1-C1 |  | CYAN | speed +50 % | Scan | 12 | 1.5 x S_ref | 0.1
E2-A-D1-C1 |  | BLUE | power +2 | Scan | 14 | S_ref | 0.1
E2-A-D1-C1 |  | MAGENTA | REFERENCE replicate 2 (other end) | Scan | 12 | S_ref | 0.1
E2-A-D1-C1 |  | BLACK (OUTLINE_CUT) | coupon outline | Cut or OFF | cut setting | cut speed
E2-A-D1-C2 |  | RED | power -2 | Scan | 10 | S_ref | 0.1
E2-A-D1-C2 |  | YELLOW | speed -33 % | Scan | 12 | 0.67 x S_ref | 0.1
E2-A-D1-C2 |  | GREEN | REFERENCE replicate 1 | Scan | 12 | S_ref | 0.1
E2-A-D1-C2 |  | CYAN | speed +50 % | Scan | 12 | 1.5 x S_ref | 0.1
E2-A-D1-C2 |  | BLUE | power +2 | Scan | 14 | S_ref | 0.1
E2-A-D1-C2 |  | MAGENTA | REFERENCE replicate 2 (other end) | Scan | 12 | S_ref | 0.1
E2-A-D1-C2 |  | BLACK (OUTLINE_CUT) | coupon outline | Cut or OFF | cut setting | cut speed
E2-A-D2-C1 |  | RED | power -2 | Scan | 10 | S_ref | 0.1
E2-A-D2-C1 |  | YELLOW | speed -33 % | Scan | 12 | 0.67 x S_ref | 0.1
E2-A-D2-C1 |  | GREEN | REFERENCE replicate 1 | Scan | 12 | S_ref | 0.1
E2-A-D2-C1 |  | CYAN | speed +50 % | Scan | 12 | 1.5 x S_ref | 0.1
E2-A-D2-C1 |  | BLUE | power +2 | Scan | 14 | S_ref | 0.1
E2-A-D2-C1 |  | MAGENTA | REFERENCE replicate 2 (other end) | Scan | 12 | S_ref | 0.1
E2-A-D2-C1 |  | BLACK (OUTLINE_CUT) | coupon outline | Cut or OFF | cut setting | cut speed
E2-A-D2-C2 |  | RED | power -2 | Scan | 10 | S_ref | 0.1
E2-A-D2-C2 |  | YELLOW | speed -33 % | Scan | 12 | 0.67 x S_ref | 0.1
E2-A-D2-C2 |  | GREEN | REFERENCE replicate 1 | Scan | 12 | S_ref | 0.1
E2-A-D2-C2 |  | CYAN | speed +50 % | Scan | 12 | 1.5 x S_ref | 0.1
E2-A-D2-C2 |  | BLUE | power +2 | Scan | 14 | S_ref | 0.1
E2-A-D2-C2 |  | MAGENTA | REFERENCE replicate 2 (other end) | Scan | 12 | S_ref | 0.1
E2-A-D2-C2 |  | BLACK (OUTLINE_CUT) | coupon outline | Cut or OFF | cut setting | cut speed
E2-B-D1-C1 |  | GREEN (ENGRAVE) | all lines and gaps | Scan | reference | S_ref | 0.1
E2-B-D1-C1 |  | BLUE (CUT) | outline + holes (after engraving) | Cut | cut setting | cut speed
E2-B-D1-C2 |  | GREEN (ENGRAVE) | all lines and gaps | Scan | reference | S_ref | 0.1
E2-B-D1-C2 |  | BLUE (CUT) | outline + holes (after engraving) | Cut | cut setting | cut speed
E2-B-D2-C1 |  | GREEN (ENGRAVE) | all lines and gaps | Scan | reference | S_ref | 0.1
E2-B-D2-C1 |  | BLUE (CUT) | outline + holes (after engraving) | Cut | cut setting | cut speed
