soham0777/dermasense-vishwakarma-2026/4_sensor_strip/e2_experiment/e2_summary.md

# E2 summary (2026-10-16 03:04)

**Status: NO DATA**

No measurements entered yet. Fill the e2_*.csv files (see E2_procedure.md) and run again.
measured_process.json is NOT written until real data exists.
