soham0777/dermasense-vishwakarma-2026/7_firmware/bench_test.csv

step | setup | quantity | dmm_true_value | reader_value | error_pct_or_result | pass_fail | log_file | date | operator | notes
T0 | all | DMM values of test resistors
T1 | - | flash + banner
T2 | J4 open | FAULT LOOP_OPEN, k_check
T3 | loop 10k | rloop vs DMM
T4 | zone C = 1k, loop 10k | rc median of 5 vs DMM
T4 | zone C = 10k, loop 10k | rc median of 5 vs DMM
T4 | zone C = 47k, loop 10k | rc median of 5 vs DMM
T4 | zone C = 100k, loop 10k | rc median of 5 vs DMM
T4 | zone C = 220k, loop 10k | rc median of 5 vs DMM
T4 | zone C = 470k, loop 10k | rc median of 5 vs DMM
T4 | zone C = 1M, loop 10k | rc median of 5 vs DMM
T5 | zone A = 1k, loop 10k | ra median of 5 vs DMM
T5 | zone A = 10k, loop 10k | ra median of 5 vs DMM
T5 | zone A = 47k, loop 10k | ra median of 5 vs DMM
T5 | zone A = 100k, loop 10k | ra median of 5 vs DMM
T5 | zone A = 220k, loop 10k | ra median of 5 vs DMM
T5 | zone A = 470k, loop 10k | ra median of 5 vs DMM
T5 | zone A = 1M, loop 10k | ra median of 5 vs DMM
T6a | C open, A open | state
T6b | C 10k | state + scans to c_wet
T6c | C 10k + A 10k | CHANGE after scans
T6d | C open, A 10k | CHECK after scans
T7 | C 10k -> 220k -> 470k | hysteresis
T8 | C 10k | DC mV across J4.1-J4.3
T9 | loop removed | FAULT next scan
T10 | C 10k, A 100k, loop 10k, 30 min | bad lines, drift %, resets
T11 | C/A per T6, loop 10 k | BLE state vs serial state
