soham0777/dermasense-vishwakarma-2026/4_sensor_strip/e2_experiment/e2_isolation.csv

sample_id | drawn_gap_mm | reading_no | R_ohm | display_if_not_number | meter_range_ohm | bridge_seen_YN | notes
E2-B-D1-C1-G020 | 0.2 | 1
E2-B-D1-C1-G020 | 0.2 | 2
E2-B-D1-C1-G030 | 0.3 | 1
E2-B-D1-C1-G030 | 0.3 | 2
E2-B-D1-C1-G050 | 0.5 | 1
E2-B-D1-C1-G050 | 0.5 | 2
E2-B-D1-C1-G080 | 0.8 | 1
E2-B-D1-C1-G080 | 0.8 | 2
E2-B-D1-C1-G100 | 1.0 | 1
E2-B-D1-C1-G100 | 1.0 | 2
E2-B-D1-C1-G150 | 1.5 | 1
E2-B-D1-C1-G150 | 1.5 | 2
E2-B-D1-C2-G020 | 0.2 | 1
E2-B-D1-C2-G020 | 0.2 | 2
E2-B-D1-C2-G030 | 0.3 | 1
E2-B-D1-C2-G030 | 0.3 | 2
E2-B-D1-C2-G050 | 0.5 | 1
E2-B-D1-C2-G050 | 0.5 | 2
E2-B-D1-C2-G080 | 0.8 | 1
E2-B-D1-C2-G080 | 0.8 | 2
E2-B-D1-C2-G100 | 1.0 | 1
E2-B-D1-C2-G100 | 1.0 | 2
E2-B-D1-C2-G150 | 1.5 | 1
E2-B-D1-C2-G150 | 1.5 | 2
E2-B-D2-C1-G020 | 0.2 | 1
E2-B-D2-C1-G020 | 0.2 | 2
E2-B-D2-C1-G030 | 0.3 | 1
E2-B-D2-C1-G030 | 0.3 | 2
E2-B-D2-C1-G050 | 0.5 | 1
E2-B-D2-C1-G050 | 0.5 | 2
E2-B-D2-C1-G080 | 0.8 | 1
E2-B-D2-C1-G080 | 0.8 | 2
E2-B-D2-C1-G100 | 1.0 | 1
E2-B-D2-C1-G100 | 1.0 | 2
E2-B-D2-C1-G150 | 1.5 | 1
E2-B-D2-C1-G150 | 1.5 | 2
