soham0777/dermasense-vishwakarma-2026/4_sensor_strip/e2_experiment/e2_linewidth.csv

sample_id | feature | drawn_mm | position_no | measured_mm | instrument | magnification | scale_reference | photo_file | notes
E2-A-D1-C1-RED-L16 | line | 2.0 | 1
E2-A-D1-C1-RED-L16 | line | 2.0 | 2
E2-A-D1-C1-RED-L16 | line | 2.0 | 3
E2-A-D1-C1-YELLOW-L16 | line | 2.0 | 1
E2-A-D1-C1-YELLOW-L16 | line | 2.0 | 2
E2-A-D1-C1-YELLOW-L16 | line | 2.0 | 3
E2-A-D1-C1-GREEN-L16 | line | 2.0 | 1
E2-A-D1-C1-GREEN-L16 | line | 2.0 | 2
E2-A-D1-C1-GREEN-L16 | line | 2.0 | 3
E2-A-D1-C1-CYAN-L16 | line | 2.0 | 1
E2-A-D1-C1-CYAN-L16 | line | 2.0 | 2
E2-A-D1-C1-CYAN-L16 | line | 2.0 | 3
E2-A-D1-C1-BLUE-L16 | line | 2.0 | 1
E2-A-D1-C1-BLUE-L16 | line | 2.0 | 2
E2-A-D1-C1-BLUE-L16 | line | 2.0 | 3
E2-A-D1-C1-MAGENTA-L16 | line | 2.0 | 1
E2-A-D1-C1-MAGENTA-L16 | line | 2.0 | 2
E2-A-D1-C1-MAGENTA-L16 | line | 2.0 | 3
E2-A-D1-C2-RED-L16 | line | 2.0 | 1
E2-A-D1-C2-RED-L16 | line | 2.0 | 2
E2-A-D1-C2-RED-L16 | line | 2.0 | 3
E2-A-D1-C2-YELLOW-L16 | line | 2.0 | 1
E2-A-D1-C2-YELLOW-L16 | line | 2.0 | 2
E2-A-D1-C2-YELLOW-L16 | line | 2.0 | 3
E2-A-D1-C2-GREEN-L16 | line | 2.0 | 1
E2-A-D1-C2-GREEN-L16 | line | 2.0 | 2
E2-A-D1-C2-GREEN-L16 | line | 2.0 | 3
E2-A-D1-C2-CYAN-L16 | line | 2.0 | 1
E2-A-D1-C2-CYAN-L16 | line | 2.0 | 2
E2-A-D1-C2-CYAN-L16 | line | 2.0 | 3
E2-A-D1-C2-BLUE-L16 | line | 2.0 | 1
E2-A-D1-C2-BLUE-L16 | line | 2.0 | 2
E2-A-D1-C2-BLUE-L16 | line | 2.0 | 3
E2-A-D1-C2-MAGENTA-L16 | line | 2.0 | 1
E2-A-D1-C2-MAGENTA-L16 | line | 2.0 | 2
E2-A-D1-C2-MAGENTA-L16 | line | 2.0 | 3
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
E2-B-D2-C1-H2 | hole | 2.0 | 2 |  |  |  |  |  | position 1 and 2 = perpendicular diameters
E2-B-D2-C1-H3 | hole | 2.0 | 1 |  |  |  |  |  | position 1 and 2 = perpendicular diameters
E2-B-D2-C1-H3 | hole | 2.0 | 2 |  |  |  |  |  | position 1 and 2 = perpendicular diameters
