soham0777/dermasense-vishwakarma-2026/4_sensor_strip/e2_experiment/e2_res_coupon.png

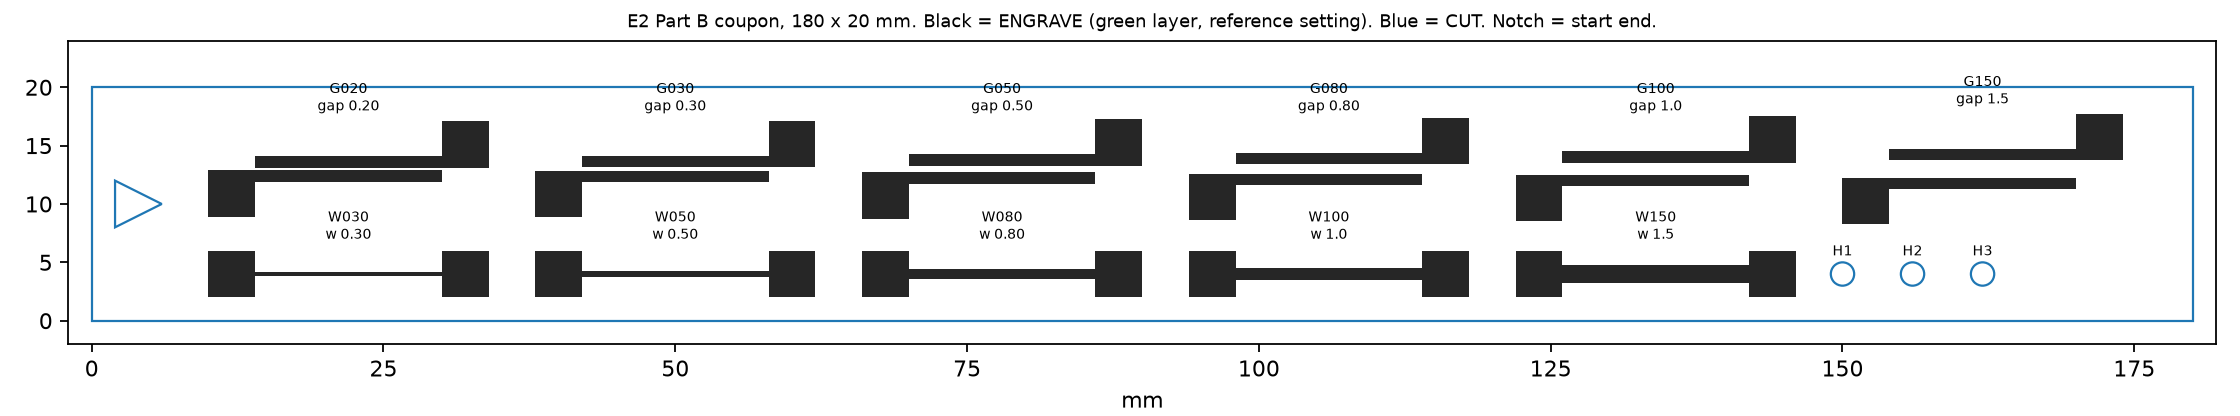
4_sensor_strip/e2_experiment/e2_res_coupon.png
