soham0777/dermasense-vishwakarma-2026/5_cad/solidworks/build_log.txt

--- run 2026-10-14 22:11:27 stages=('parts', 'drawings', 'assembly')
SolidWorks 27.4.0; templates {'part': 'C:\\ProgramData\\SolidWorks\\SOLIDWORKS 2019\\templates\\Part.prtdot', 'asm': 'C:\\ProgramData\\SolidWorks\\SOLIDWORKS 2019\\templates\\Assembly.asmdot', 'drw': 'C:\\ProgramData\\SolidWorks\\SOLIDWORKS 2019\\templates\\Drawing.drwdot'}
strip: Kapton volume 171.7 mm3; LIG bodies extruded 0.02 mm down (LIG faces the pad)
PART strip_v0_1: volume 179.5 mm3; sketch dims 7/7; save 0, STEP 0
PART seal_v0_1: volume 71.4 mm3; sketch dims 0/0; save 0, STEP 0
clamp base: block 17988 mm3 before cuts
PART clamp_base_v0_1: volume 16414.9 mm3; sketch dims 8/8; save 0, STEP 0
PART clamp_lid_v0_1: volume 4391.1 mm3; sketch dims 7/7; save 0, STEP 0
PART pogo_pin_P75_simplified: volume 12.9 mm3; sketch dims 1/1; save 0, STEP 0
PART dowel_2x12: volume 37.7 mm3; sketch dims 1/1; save 0, STEP 0
PART rig_base_v0_1: volume 95644.8 mm3; sketch dims 7/7; save 0, STEP 0
PART wound_bed_spacer_v0_1: volume 96433.6 mm3; sketch dims 5/5; save 0, STEP 0
PART dressing_reference_bordered_foam: volume 23812.5 mm3; sketch dims 0/0; save 0, STEP 0
DRAWING strip_v0_1: A3 ISO sheet True, scale 1:1, views True, imported dimensions 9, save 0, PDF 0
DRAWING seal_v0_1: A3 ISO sheet True, scale 1:1, views True, imported dimensions 1, save 0, PDF 0
DRAWING clamp_base_v0_1: A3 ISO sheet True, scale 1:1, views True, imported dimensions 10, save 0, PDF 0
DRAWING clamp_lid_v0_1: A3 ISO sheet True, scale 1:1, views True, imported dimensions 8, save 0, PDF 0
DRAWING rig_base_v0_1: A3 ISO sheet True, scale 1:2, views True, imported dimensions 8, save 0, PDF 0
DRAWING wound_bed_spacer_v0_1: A3 ISO sheet True, scale 1:2, views True, imported dimensions 6, save 0, PDF 0
RENDER strip_v0_1_iso.JPG: 0
RENDER clamp_base_v0_1_iso.JPG: 0
RENDER clamp_lid_v0_1_iso.JPG: 0
  rig_base_v0_1-1: 3 mates; position (0.0, 0.0, -21.02) vs target (0, 0, -21.02)
  wound_bed_spacer_v0_1-1: 3 mates; position (0.0, 0.0, -16.02) vs target (0, 0, -16.02)
  dressing_reference_bordered_foam-1: 3 mates; position (90.0, 5.0, -4.11) vs target (90.0, 5.0, -4.11) flipped axis 0; flipped axis 1;
  seal_v0_1-1: 3 mates; position (0.0, 0.0, -0.11) vs target (0, 0, -0.11)
  strip_v0_1-1: 3 mates; position (0.0, 0.0, 0.0) vs target (0, 0, 0.0)
  clamp_base_v0_1-1: 3 mates; position (0.0, 0.0, -16.02) vs target (0, 0, -16.02)
  clamp_lid_v0_1-1: 3 mates; position (0.0, 0.0, 0.125) vs target (0, 0, 0.125) flipped axis 2;
  pogo_pin_P75_simplified-1: 3 mates; position (8.0, -2.62, -15.82) vs target (8.0, -2.62, -15.82) flipped axis 0;
  pogo_pin_P75_simplified-2: 3 mates; position (8.0, 2.46, -15.82) vs target (8.0, 2.46, -15.82) flipped axis 0; flipped axis 1;
  pogo_pin_P75_simplified-3: 3 mates; position (8.0, 7.54, -15.82) vs target (8.0, 7.54, -15.82) flipped axis 0; flipped axis 1;
  pogo_pin_P75_simplified-4: 3 mates; position (8.0, 12.62, -15.82) vs target (8.0, 12.62, -15.82) flipped axis 0; flipped axis 1;
  dowel_2x12-1: 3 mates; position (8.0, -6.62, -10.02) vs target (8.0, -6.62, -10.02) flipped axis 0;
  dowel_2x12-2: 3 mates; position (8.0, 16.62, -10.02) vs target (8.0, 16.62, -10.02) flipped axis 0; flipped axis 1;
ASSEMBLY saved 0: dermasense_bench_v0_1.SLDASM
RENDER dermasense_bench_v0_1_iso.JPG: 0
RENDER dermasense_bench_v0_1_side.JPG: 0
DRAWING dermasense_bench_v0_1: A3 ISO sheet True, scale 1:2, views True, imported dimensions 66, save 0, PDF 0
done in 132 s
--- run 2026-10-14 22:17:33 stages=('parts', 'drawings', 'assembly')
SolidWorks 27.4.0; templates {'part': 'C:\\ProgramData\\SolidWorks\\SOLIDWORKS 2019\\templates\\Part.prtdot', 'asm': 'C:\\ProgramData\\SolidWorks\\SOLIDWORKS 2019\\templates\\Assembly.asmdot', 'drw': 'C:\\ProgramData\\SolidWorks\\SOLIDWORKS 2019\\templates\\Drawing.drwdot'}
strip: Kapton volume 171.7 mm3; LIG bodies extruded 0.02 mm down (LIG faces the pad)
PART strip_v0_1: volume 179.5 mm3; sketch dims 9/9; save 0, STEP 0
PART seal_v0_1: volume 71.4 mm3; sketch dims 7/7; save 0, STEP 0
clamp base: block 17988 mm3 before cuts
PART clamp_base_v0_1: volume 16414.9 mm3; sketch dims 8/8; save 0, STEP 0
PART clamp_lid_v0_1: volume 4391.1 mm3; sketch dims 7/7; save 0, STEP 0
PART pogo_pin_P75_simplified: volume 12.9 mm3; sketch dims 1/1; save 0, STEP 0
PART dowel_2x12: volume 37.7 mm3; sketch dims 1/1; save 0, STEP 0
PART rig_base_v0_1: volume 95644.8 mm3; sketch dims 7/7; save 0, STEP 0
PART wound_bed_spacer_v0_1: volume 96433.6 mm3; sketch dims 5/5; save 0, STEP 0
PART dressing_reference_bordered_foam: volume 23812.5 mm3; sketch dims 0/0; save 0, STEP 0
done in 64 s
--- run 2026-10-14 22:19:25 stages=('drawings', 'assembly')
SolidWorks 27.4.0; templates {'part': 'C:\\ProgramData\\SolidWorks\\SOLIDWORKS 2019\\templates\\Part.prtdot', 'asm': 'C:\\ProgramData\\SolidWorks\\SOLIDWORKS 2019\\templates\\Assembly.asmdot', 'drw': 'C:\\ProgramData\\SolidWorks\\SOLIDWORKS 2019\\templates\\Drawing.drwdot'}
SolidWorks 27.4.0; templates {'part': 'C:\\ProgramData\\SolidWorks\\SOLIDWORKS 2019\\templates\\Part.prtdot', 'asm': 'C:\\ProgramData\\SolidWorks\\SOLIDWORKS 2019\\templates\\Assembly.asmdot', 'drw': 'C:\\ProgramData\\SolidWorks\\SOLIDWORKS 2019\\templates\\Drawing.drwdot'}
DRAWING strip_v0_1: A3 ISO sheet True, scale 1:1, views True, imported dimensions 24, note True, save 0, PDF 0
DRAWING seal_v0_1: A3 ISO sheet True, scale 1:1, views True, imported dimensions 16, note True, save 0, PDF 0
DRAWING clamp_base_v0_1: A3 ISO sheet True, scale 1:1, views True, imported dimensions 14, note True, save 0, PDF 0
DRAWING clamp_lid_v0_1: A3 ISO sheet True, scale 1:1, views True, imported dimensions 18, note True, save 0, PDF 0
DRAWING rig_base_v0_1: A3 ISO sheet True, scale 1:2, views True, imported dimensions 18, note True, save 0, PDF 0
DRAWING wound_bed_spacer_v0_1: A3 ISO sheet True, scale 1:2, views True, imported dimensions 13, note True, save 0, PDF 0
RENDER strip_v0_1_iso.JPG: 0
RENDER clamp_base_v0_1_iso.JPG: 0
RENDER clamp_lid_v0_1_iso.JPG: 0
  rig_base_v0_1-1: 3 mates; position (0.0, 0.0, -21.02) vs target (0, 0, -21.02)
  wound_bed_spacer_v0_1-1: 3 mates; position (0.0, 0.0, -16.02) vs target (0, 0, -16.02)
  dressing_reference_bordered_foam-1: 3 mates; position (90.0, 5.0, -4.11) vs target (90.0, 5.0, -4.11) flipped axis 0; flipped axis 1;
  seal_v0_1-1: 3 mates; position (0.0, 0.0, -0.11) vs target (0, 0, -0.11)
  strip_v0_1-1: 3 mates; position (0.0, 0.0, 0.0) vs target (0, 0, 0.0)
  clamp_base_v0_1-1: 3 mates; position (0.0, 0.0, -16.02) vs target (0, 0, -16.02)
  clamp_lid_v0_1-1: 3 mates; position (0.0, 0.0, 0.125) vs target (0, 0, 0.125) flipped axis 2;
  pogo_pin_P75_simplified-1: 3 mates; position (8.0, -2.62, -15.82) vs target (8.0, -2.62, -15.82) flipped axis 0;
  pogo_pin_P75_simplified-2: 3 mates; position (8.0, 2.46, -15.82) vs target (8.0, 2.46, -15.82) flipped axis 0; flipped axis 1;
  pogo_pin_P75_simplified-3: 3 mates; position (8.0, 7.54, -15.82) vs target (8.0, 7.54, -15.82) flipped axis 0; flipped axis 1;
  pogo_pin_P75_simplified-4: 3 mates; position (8.0, 12.62, -15.82) vs target (8.0, 12.62, -15.82) flipped axis 0; flipped axis 1;
  dowel_2x12-1: 3 mates; position (8.0, -6.62, -10.02) vs target (8.0, -6.62, -10.02) flipped axis 0;
  dowel_2x12-2: 3 mates; position (8.0, 16.62, -10.02) vs target (8.0, 16.62, -10.02) flipped axis 0; flipped axis 1;
ASSEMBLY saved 0: dermasense_bench_v0_1.SLDASM
RENDER dermasense_bench_v0_1_iso.JPG: 0
RENDER dermasense_bench_v0_1_side.JPG: 0
DRAWING dermasense_bench_v0_1: A3 ISO sheet True, scale 1:2, views True, imported dimensions 135, note True, save 0, PDF 0
done in 91 s
--- run 2026-10-14 22:28:47 stages=('parts', 'drawings', 'assembly')
SolidWorks 27.4.0; templates {'part': 'C:\\ProgramData\\SolidWorks\\SOLIDWORKS 2019\\templates\\Part.prtdot', 'asm': 'C:\\ProgramData\\SolidWorks\\SOLIDWORKS 2019\\templates\\Assembly.asmdot', 'drw': 'C:\\ProgramData\\SolidWorks\\SOLIDWORKS 2019\\templates\\Drawing.drwdot'}
strip: Kapton volume 171.7 mm3; LIG bodies extruded 0.02 mm down (LIG faces the pad)
PART strip_v0_1: volume 179.5 mm3; sketch dims 11/11; save 0, STEP 0
PART seal_v0_1: volume 71.4 mm3; sketch dims 7/7; save 0, STEP 0
clamp base: block 17988 mm3 before cuts
PART clamp_base_v0_1: volume 16414.9 mm3; sketch dims 8/8; save 0, STEP 0
PART clamp_lid_v0_1: volume 4391.1 mm3; sketch dims 7/7; save 0, STEP 0
PART pogo_pin_P75_simplified: volume 12.9 mm3; sketch dims 1/1; save 0, STEP 0
PART dowel_2x12: volume 37.7 mm3; sketch dims 1/1; save 0, STEP 0
PART rig_base_v0_1: volume 95644.8 mm3; sketch dims 7/7; save 0, STEP 0
PART wound_bed_spacer_v0_1: volume 96433.6 mm3; sketch dims 5/5; save 0, STEP 0
PART dressing_reference_bordered_foam: volume 23812.5 mm3; sketch dims 0/0; save 0, STEP 0
DRAWING strip_v0_1: A3 ISO sheet True; sheet scale 1:1 (asked 1:1); first-angle; views 4/4; dimensions 13 (removed 15 repeats); note True; DWG NO. resized 1; save 0, PDF 0
DRAWING seal_v0_1: A3 ISO sheet True; sheet scale 1:1 (asked 1:1); first-angle; views 4/4; dimensions 8 (removed 8 repeats); note True; DWG NO. resized 1; save 0, PDF 0
DRAWING clamp_base_v0_1: A3 ISO sheet True; sheet scale 1:1 (asked 1:1); first-angle; views 4/4; dimensions 11 (removed 4 repeats); note True; DWG NO. resized 1; save 0, PDF 0
DRAWING clamp_lid_v0_1: A3 ISO sheet True; sheet scale 1:1 (asked 1:1); first-angle; views 4/4; dimensions 8 (removed 10 repeats); note True; DWG NO. resized 1; save 0, PDF 0
DRAWING rig_base_v0_1: A3 ISO sheet True; sheet scale 1:2 (asked 1:2); first-angle; views 4/4; dimensions 8 (removed 10 repeats); note True; DWG NO. resized 1; save 0, PDF 0
DRAWING wound_bed_spacer_v0_1: A3 ISO sheet True; sheet scale 1:2 (asked 1:2); first-angle; views 4/4; dimensions 6 (removed 7 repeats); note True; DWG NO. resized 1; save 0, PDF 0
RENDER strip_v0_1_iso.JPG: 0
RENDER clamp_base_v0_1_iso.JPG: 0
RENDER clamp_lid_v0_1_iso.JPG: 0
  rig_base_v0_1-1: 3 mates; position (0.0, 0.0, -21.02) vs target (0, 0, -21.02)
  wound_bed_spacer_v0_1-1: 3 mates; position (0.0, 0.0, -16.02) vs target (0, 0, -16.02)
  dressing_reference_bordered_foam-1: 3 mates; position (90.0, 5.0, -4.11) vs target (90.0, 5.0, -4.11) flipped axis 0; flipped axis 1;
  seal_v0_1-1: 3 mates; position (0.0, 0.0, -0.11) vs target (0, 0, -0.11)
  strip_v0_1-1: 3 mates; position (0.0, 0.0, 0.0) vs target (0, 0, 0.0)
  clamp_base_v0_1-1: 3 mates; position (0.0, 0.0, -16.02) vs target (0, 0, -16.02)
  clamp_lid_v0_1-1: 3 mates; position (0.0, 0.0, 0.125) vs target (0, 0, 0.125) flipped axis 2;
  pogo_pin_P75_simplified-1: 3 mates; position (8.0, -2.62, -15.82) vs target (8.0, -2.62, -15.82) flipped axis 0;
  pogo_pin_P75_simplified-2: 3 mates; position (8.0, 2.46, -15.82) vs target (8.0, 2.46, -15.82) flipped axis 0; flipped axis 1;
  pogo_pin_P75_simplified-3: 3 mates; position (8.0, 7.54, -15.82) vs target (8.0, 7.54, -15.82) flipped axis 0; flipped axis 1;
  pogo_pin_P75_simplified-4: 3 mates; position (8.0, 12.62, -15.82) vs target (8.0, 12.62, -15.82) flipped axis 0; flipped axis 1;
  dowel_2x12-1: 3 mates; position (8.0, -6.62, -10.02) vs target (8.0, -6.62, -10.02) flipped axis 0;
  dowel_2x12-2: 3 mates; position (8.0, 16.62, -10.02) vs target (8.0, 16.62, -10.02) flipped axis 0; flipped axis 1;
ASSEMBLY saved 0: dermasense_bench_v0_1.SLDASM
RENDER dermasense_bench_v0_1_iso.JPG: 0
RENDER dermasense_bench_v0_1_side.JPG: 0
done in 242 s
--- run 2026-10-14 22:30:55 stages=('drawings', 'assembly')
SolidWorks 27.4.0; templates {'part': 'C:\\ProgramData\\SolidWorks\\SOLIDWORKS 2019\\templates\\Part.prtdot', 'asm': 'C:\\ProgramData\\SolidWorks\\SOLIDWORKS 2019\\templates\\Assembly.asmdot', 'drw': 'C:\\ProgramData\\SolidWorks\\SOLIDWORKS 2019\\templates\\Drawing.drwdot'}
DRAWING strip_v0_1: A3 ISO sheet True; sheet scale 1:1 (asked 1:1); first-angle; views 4/4; dimensions 13 (removed 15 repeats); note True; DWG NO. resized 1; save 0, PDF 0
DRAWING seal_v0_1: A3 ISO sheet True; sheet scale 1:1 (asked 1:1); first-angle; views 4/4; dimensions 8 (removed 8 repeats); note True; DWG NO. resized 1; save 0, PDF 0
DRAWING clamp_base_v0_1: A3 ISO sheet True; sheet scale 2:1 (asked 2:1); first-angle; views 4/4; dimensions 11 (removed 4 repeats); note True; DWG NO. resized 1; save 0, PDF 0
DRAWING clamp_lid_v0_1: A3 ISO sheet True; sheet scale 2:1 (asked 2:1); first-angle; views 4/4; dimensions 8 (removed 10 repeats); note True; DWG NO. resized 1; save 0, PDF 0
DRAWING rig_base_v0_1: A3 ISO sheet True; sheet scale 1:2 (asked 1:2); first-angle; views 4/4; dimensions 8 (removed 10 repeats); note True; DWG NO. resized 1; save 0, PDF 0
DRAWING wound_bed_spacer_v0_1: A3 ISO sheet True; sheet scale 1:2 (asked 1:2); first-angle; views 4/4; dimensions 6 (removed 7 repeats); note True; DWG NO. resized 1; save 0, PDF 0
done in 115 s
--- run 2026-10-14 22:32:31 stages=('assembly',)
SolidWorks 27.4.0; templates {'part': 'C:\\ProgramData\\SolidWorks\\SOLIDWORKS 2019\\templates\\Part.prtdot', 'asm': 'C:\\ProgramData\\SolidWorks\\SOLIDWORKS 2019\\templates\\Assembly.asmdot', 'drw': 'C:\\ProgramData\\SolidWorks\\SOLIDWORKS 2019\\templates\\Drawing.drwdot'}
SolidWorks 27.4.0; templates {'part': 'C:\\ProgramData\\SolidWorks\\SOLIDWORKS 2019\\templates\\Part.prtdot', 'asm': 'C:\\ProgramData\\SolidWorks\\SOLIDWORKS 2019\\templates\\Assembly.asmdot', 'drw': 'C:\\ProgramData\\SolidWorks\\SOLIDWORKS 2019\\templates\\Drawing.drwdot'}
RENDER strip_v0_1_iso.JPG: 0
RENDER clamp_base_v0_1_iso.JPG: 0
RENDER clamp_lid_v0_1_iso.JPG: 0
SolidWorks 27.4.0; templates {'part': 'C:\\ProgramData\\SolidWorks\\SOLIDWORKS 2019\\templates\\Part.prtdot', 'asm': 'C:\\ProgramData\\SolidWorks\\SOLIDWORKS 2019\\templates\\Assembly.asmdot', 'drw': 'C:\\ProgramData\\SolidWorks\\SOLIDWORKS 2019\\templates\\Drawing.drwdot'}
  rig_base_v0_1-1: 3 mates; position (0.0, 0.0, -21.02) vs target (0, 0, -21.02)
  wound_bed_spacer_v0_1-1: 3 mates; position (0.0, 0.0, -16.02) vs target (0, 0, -16.02)
  dressing_reference_bordered_foam-1: 3 mates; position (90.0, 5.0, -4.11) vs target (90.0, 5.0, -4.11) flipped axis 0; flipped axis 1;
  seal_v0_1-1: 3 mates; position (0.0, 0.0, -0.11) vs target (0, 0, -0.11)
  strip_v0_1-1: 3 mates; position (0.0, 0.0, 0.0) vs target (0, 0, 0.0)
  clamp_base_v0_1-1: 3 mates; position (0.0, 0.0, -16.02) vs target (0, 0, -16.02)
  clamp_lid_v0_1-1: 3 mates; position (0.0, 0.0, 0.125) vs target (0, 0, 0.125) flipped axis 2;
  pogo_pin_P75_simplified-1: 3 mates; position (8.0, -2.62, -15.82) vs target (8.0, -2.62, -15.82) flipped axis 0;
  pogo_pin_P75_simplified-2: 3 mates; position (8.0, 2.46, -15.82) vs target (8.0, 2.46, -15.82) flipped axis 0; flipped axis 1;
  pogo_pin_P75_simplified-3: 3 mates; position (8.0, 7.54, -15.82) vs target (8.0, 7.54, -15.82) flipped axis 0; flipped axis 1;
  pogo_pin_P75_simplified-4: 3 mates; position (8.0, 12.62, -15.82) vs target (8.0, 12.62, -15.82) flipped axis 0; flipped axis 1;
  dowel_2x12-1: 3 mates; position (8.0, -6.62, -10.02) vs target (8.0, -6.62, -10.02) flipped axis 0;
  dowel_2x12-2: 3 mates; position (8.0, 16.62, -10.02) vs target (8.0, 16.62, -10.02) flipped axis 0; flipped axis 1;
ASSEMBLY saved 0: dermasense_bench_v0_1.SLDASM
RENDER dermasense_bench_v0_1_iso.JPG: 0
RENDER dermasense_bench_v0_1_side.JPG: 0
DRAWING dermasense_bench_v0_1: A3 ISO sheet True; sheet scale 1:2 (asked 1:2); first-angle; views 4/4; BOM inserted, balloons 5; note True; DWG NO. resized 1; save 0, PDF 0
done in 62 s
--- run 2026-10-14 22:38:01 stages=('parts', 'drawings', 'assembly')
SolidWorks 27.4.0; templates {'part': 'C:\\ProgramData\\SolidWorks\\SOLIDWORKS 2019\\templates\\Part.prtdot', 'asm': 'C:\\ProgramData\\SolidWorks\\SOLIDWORKS 2019\\templates\\Assembly.asmdot', 'drw': 'C:\\ProgramData\\SolidWorks\\SOLIDWORKS 2019\\templates\\Drawing.drwdot'}
strip: Kapton volume 171.7 mm3; LIG bodies extruded 0.02 mm down (LIG faces the pad)
PART strip_v0_1: volume 179.5 mm3; sketch dims 11/11; save 0, STEP 0
PART seal_v0_1: volume 71.4 mm3; sketch dims 7/7; save 0, STEP 0
clamp base: block 17988 mm3 before cuts
PART clamp_base_v0_1: volume 16414.9 mm3; sketch dims 15/15; save 0, STEP 0
PART clamp_lid_v0_1: volume 4391.1 mm3; sketch dims 7/7; save 0, STEP 0
PART pogo_pin_P75_simplified: volume 12.9 mm3; sketch dims 1/1; save 0, STEP 0
PART dowel_2x12: volume 37.7 mm3; sketch dims 1/1; save 0, STEP 0
PART rig_base_v0_1: volume 95644.8 mm3; sketch dims 10/10; save 0, STEP 0
PART wound_bed_spacer_v0_1: volume 96433.6 mm3; sketch dims 5/5; save 0, STEP 0
PART dressing_reference_bordered_foam: volume 23812.5 mm3; sketch dims 0/0; save 0, STEP 0
DRAWING strip_v0_1: A3 ISO sheet True; sheet scale 1:1 (asked 1:1); first-angle; views 4/4; dimensions 13 (removed 15 repeats); note True; DWG NO. resized 1; save 0, PDF 0
DRAWING seal_v0_1: A3 ISO sheet True; sheet scale 1:1 (asked 1:1); first-angle; views 4/4; dimensions 8 (removed 8 repeats); note True; DWG NO. resized 1; save 0, PDF 0
DRAWING clamp_base_v0_1: A3 ISO sheet True; sheet scale 2:1 (asked 2:1); first-angle; views 4/4; dimensions 16 (removed 5 repeats); note True; DWG NO. resized 1; save 0, PDF 0
DRAWING clamp_lid_v0_1: A3 ISO sheet True; sheet scale 2:1 (asked 2:1); first-angle; views 4/4; dimensions 8 (removed 10 repeats); note True; DWG NO. resized 1; save 0, PDF 0
DRAWING rig_base_v0_1: A3 ISO sheet True; sheet scale 1:2 (asked 1:2); first-angle; views 4/4; dimensions 11 (removed 14 repeats); note True; DWG NO. resized 1; save 0, PDF 0
DRAWING wound_bed_spacer_v0_1: A3 ISO sheet True; sheet scale 1:2 (asked 1:2); first-angle; views 4/4; dimensions 6 (removed 7 repeats); note True; DWG NO. resized 1; save 0, PDF 0
RENDER strip_v0_1_iso.JPG: 0
RENDER clamp_base_v0_1_iso.JPG: 0
RENDER clamp_lid_v0_1_iso.JPG: 0
  rig_base_v0_1-1: 3 mates; position (0.0, 0.0, -21.02) vs target (0, 0, -21.02)
  wound_bed_spacer_v0_1-1: 3 mates; position (0.0, 0.0, -16.02) vs target (0, 0, -16.02)
  dressing_reference_bordered_foam-1: 3 mates; position (90.0, 5.0, -4.11) vs target (90.0, 5.0, -4.11) flipped axis 0; flipped axis 1;
  seal_v0_1-1: 3 mates; position (0.0, 0.0, -0.11) vs target (0, 0, -0.11)
  strip_v0_1-1: 3 mates; position (0.0, 0.0, 0.0) vs target (0, 0, 0.0)
  clamp_base_v0_1-1: 3 mates; position (0.0, 0.0, -16.02) vs target (0, 0, -16.02)
  clamp_lid_v0_1-1: 3 mates; position (0.0, 0.0, 0.125) vs target (0, 0, 0.125) flipped axis 2;
  pogo_pin_P75_simplified-1: 3 mates; position (8.0, -2.62, -15.82) vs target (8.0, -2.62, -15.82) flipped axis 0;
  pogo_pin_P75_simplified-2: 3 mates; position (8.0, 2.46, -15.82) vs target (8.0, 2.46, -15.82) flipped axis 0; flipped axis 1;
  pogo_pin_P75_simplified-3: 3 mates; position (8.0, 7.54, -15.82) vs target (8.0, 7.54, -15.82) flipped axis 0; flipped axis 1;
  pogo_pin_P75_simplified-4: 3 mates; position (8.0, 12.62, -15.82) vs target (8.0, 12.62, -15.82) flipped axis 0; flipped axis 1;
  dowel_2x12-1: 3 mates; position (8.0, -6.62, -10.02) vs target (8.0, -6.62, -10.02) flipped axis 0;
  dowel_2x12-2: 3 mates; position (8.0, 16.62, -10.02) vs target (8.0, 16.62, -10.02) flipped axis 0; flipped axis 1;
ASSEMBLY saved 0: dermasense_bench_v0_1.SLDASM
RENDER dermasense_bench_v0_1_iso.JPG: 0
RENDER dermasense_bench_v0_1_side.JPG: 0
DRAWING dermasense_bench_v0_1: A3 ISO sheet True; sheet scale 1:2 (asked 1:2); first-angle; views 4/4; BOM inserted, balloons 5; note True; DWG NO. resized 1; save 0, PDF 0
done in 264 s
--- run 2026-10-14 22:40:55 stages=('drawings',)
SolidWorks 27.4.0; templates {'part': 'C:\\ProgramData\\SolidWorks\\SOLIDWORKS 2019\\templates\\Part.prtdot', 'asm': 'C:\\ProgramData\\SolidWorks\\SOLIDWORKS 2019\\templates\\Assembly.asmdot', 'drw': 'C:\\ProgramData\\SolidWorks\\SOLIDWORKS 2019\\templates\\Drawing.drwdot'}
DRAWING strip_v0_1: A3 ISO sheet True; sheet scale 1:1 (asked 1:1); first-angle; views 4/4; dimensions 13 (removed 15 repeats); note True; DWG NO. resized 1; save 0, PDF 0
DRAWING seal_v0_1: A3 ISO sheet True; sheet scale 1:1 (asked 1:1); first-angle; views 4/4; dimensions 8 (removed 8 repeats); note True; DWG NO. resized 1; save 0, PDF 0
DRAWING clamp_base_v0_1: A3 ISO sheet True; sheet scale 2:1 (asked 2:1); first-angle; views 4/4; dimensions 16 (removed 5 repeats); note True; DWG NO. resized 1; save 0, PDF 0
DRAWING clamp_lid_v0_1: A3 ISO sheet True; sheet scale 2:1 (asked 2:1); first-angle; views 4/4; dimensions 8 (removed 10 repeats); note True; DWG NO. resized 1; save 0, PDF 0
DRAWING rig_base_v0_1: A3 ISO sheet True; sheet scale 1:2 (asked 1:2); first-angle; views 4/4; dimensions 11 (removed 14 repeats); note True; DWG NO. resized 1; save 0, PDF 0
DRAWING wound_bed_spacer_v0_1: A3 ISO sheet True; sheet scale 1:2 (asked 1:2); first-angle; views 4/4; dimensions 6 (removed 7 repeats); note True; DWG NO. resized 1; save 0, PDF 0
RENDER strip_v0_1_iso.JPG: 0
RENDER clamp_base_v0_1_iso.JPG: 0
RENDER clamp_lid_v0_1_iso.JPG: 0
done in 136 s
--- run 2026-10-14 22:43:13 stages=('assembly',)
SolidWorks 27.4.0; templates {'part': 'C:\\ProgramData\\SolidWorks\\SOLIDWORKS 2019\\templates\\Part.prtdot', 'asm': 'C:\\ProgramData\\SolidWorks\\SOLIDWORKS 2019\\templates\\Assembly.asmdot', 'drw': 'C:\\ProgramData\\SolidWorks\\SOLIDWORKS 2019\\templates\\Drawing.drwdot'}
  rig_base_v0_1-1: 3 mates; position (0.0, 0.0, -21.02) vs target (0, 0, -21.02)
  wound_bed_spacer_v0_1-1: 3 mates; position (0.0, 0.0, -16.02) vs target (0, 0, -16.02)
  dressing_reference_bordered_foam-1: 3 mates; position (90.0, 5.0, -4.11) vs target (90.0, 5.0, -4.11) flipped axis 0; flipped axis 1;
  seal_v0_1-1: 3 mates; position (0.0, 0.0, -0.11) vs target (0, 0, -0.11)
  strip_v0_1-1: 3 mates; position (0.0, 0.0, 0.0) vs target (0, 0, 0.0)
  clamp_base_v0_1-1: 3 mates; position (0.0, 0.0, -16.02) vs target (0, 0, -16.02)
  clamp_lid_v0_1-1: 3 mates; position (0.0, 0.0, 0.125) vs target (0, 0, 0.125) flipped axis 2;
  pogo_pin_P75_simplified-1: 3 mates; position (8.0, -2.62, -15.82) vs target (8.0, -2.62, -15.82) flipped axis 0;
  pogo_pin_P75_simplified-2: 3 mates; position (8.0, 2.46, -15.82) vs target (8.0, 2.46, -15.82) flipped axis 0; flipped axis 1;
  pogo_pin_P75_simplified-3: 3 mates; position (8.0, 7.54, -15.82) vs target (8.0, 7.54, -15.82) flipped axis 0; flipped axis 1;
  pogo_pin_P75_simplified-4: 3 mates; position (8.0, 12.62, -15.82) vs target (8.0, 12.62, -15.82) flipped axis 0; flipped axis 1;
  dowel_2x12-1: 3 mates; position (8.0, -6.62, -10.02) vs target (8.0, -6.62, -10.02) flipped axis 0;
  dowel_2x12-2: 3 mates; position (8.0, 16.62, -10.02) vs target (8.0, 16.62, -10.02) flipped axis 0; flipped axis 1;
ASSEMBLY saved 0: dermasense_bench_v0_1.SLDASM
RENDER dermasense_bench_v0_1_iso.JPG: 0
RENDER dermasense_bench_v0_1_side.JPG: 0
DRAWING dermasense_bench_v0_1: A3 ISO sheet True; sheet scale 1:2 (asked 1:2); first-angle; views 4/4; BOM inserted, balloons 5; note True; DWG NO. resized 1; save 0, PDF 0
done in 64 s
--- run 2026-10-14 22:51:14 stages=('parts', 'drawings', 'assembly')
SolidWorks 27.4.0; templates {'part': 'C:\\ProgramData\\SolidWorks\\SOLIDWORKS 2019\\templates\\Part.prtdot', 'asm': 'C:\\ProgramData\\SolidWorks\\SOLIDWORKS 2019\\templates\\Assembly.asmdot', 'drw': 'C:\\ProgramData\\SolidWorks\\SOLIDWORKS 2019\\templates\\Drawing.drwdot'}
strip: Kapton volume 171.7 mm3; LIG bodies extruded 0.02 mm down (LIG faces the pad)
PART strip_v0_1: volume 179.5 mm3; sketch dims 11/11; save 0, STEP 0
PART seal_v0_1: volume 61.5 mm3; sketch dims 7/7; save 0, STEP 0
clamp base: block 17988 mm3 before cuts
PART clamp_base_v0_1: volume 16414.9 mm3; sketch dims 15/15; save 0, STEP 0
PART clamp_lid_v0_1: volume 4391.1 mm3; sketch dims 7/7; save 0, STEP 0
PART pogo_pin_P75_simplified: volume 12.9 mm3; sketch dims 1/1; save 0, STEP 0
PART dowel_2x12: volume 37.7 mm3; sketch dims 1/1; save 0, STEP 0
PART rig_base_v0_1: volume 95644.8 mm3; sketch dims 10/10; save 0, STEP 0
PART wound_bed_spacer_v0_1: volume 96433.6 mm3; sketch dims 5/5; save 0, STEP 0
PART dressing_reference_bordered_foam: volume 23812.5 mm3; sketch dims 0/0; save 0, STEP 0
DRAWING strip_v0_1: A3 ISO sheet True; sheet scale 1:1 (asked 1:1); first-angle; views 4/4; dimensions 13 (removed 15 repeats); note True; DWG NO. resized 1; save 0, PDF 0
DRAWING seal_v0_1: A3 ISO sheet True; sheet scale 1:1 (asked 1:1); first-angle; views 4/4; dimensions 8 (removed 8 repeats); note True; DWG NO. resized 1; save 0, PDF 0
DRAWING clamp_base_v0_1: A3 ISO sheet True; sheet scale 2:1 (asked 2:1); first-angle; views 4/4; dimensions 16 (removed 5 repeats); note True; DWG NO. resized 1; save 0, PDF 0
DRAWING clamp_lid_v0_1: A3 ISO sheet True; sheet scale 2:1 (asked 2:1); first-angle; views 4/4; dimensions 8 (removed 10 repeats); note True; DWG NO. resized 1; save 0, PDF 0
DRAWING rig_base_v0_1: A3 ISO sheet True; sheet scale 1:2 (asked 1:2); first-angle; views 4/4; dimensions 11 (removed 14 repeats); note True; DWG NO. resized 1; save 0, PDF 0
DRAWING wound_bed_spacer_v0_1: A3 ISO sheet True; sheet scale 1:2 (asked 1:2); first-angle; views 4/4; dimensions 6 (removed 7 repeats); note True; DWG NO. resized 1; save 0, PDF 0
RENDER strip_v0_1_iso.JPG: 0
RENDER clamp_base_v0_1_iso.JPG: 0
RENDER clamp_lid_v0_1_iso.JPG: 0
  rig_base_v0_1-1: 3 mates; position (0.0, 0.0, -21.02) vs target (0, 0, -21.02)
  wound_bed_spacer_v0_1-1: 3 mates; position (0.0, 0.0, -16.02) vs target (0, 0, -16.02)
  dressing_reference_bordered_foam-1: 3 mates; position (90.0, 5.0, -4.11) vs target (90.0, 5.0, -4.11) flipped axis 0; flipped axis 1;
  seal_v0_1-1: 3 mates; position (0.0, 0.0, -0.11) vs target (0, 0, -0.11)
  strip_v0_1-1: 3 mates; position (0.0, 0.0, 0.0) vs target (0, 0, 0.0)
  clamp_base_v0_1-1: 3 mates; position (0.0, 0.0, -16.02) vs target (0, 0, -16.02)
  clamp_lid_v0_1-1: 3 mates; position (0.0, 0.0, 0.125) vs target (0, 0, 0.125) flipped axis 2;
  pogo_pin_P75_simplified-1: 3 mates; position (8.0, -2.62, -15.82) vs target (8.0, -2.62, -15.82) flipped axis 0;
  pogo_pin_P75_simplified-2: 3 mates; position (8.0, 2.46, -15.82) vs target (8.0, 2.46, -15.82) flipped axis 0; flipped axis 1;
  pogo_pin_P75_simplified-3: 3 mates; position (8.0, 7.54, -15.82) vs target (8.0, 7.54, -15.82) flipped axis 0; flipped axis 1;
  pogo_pin_P75_simplified-4: 3 mates; position (8.0, 12.62, -15.82) vs target (8.0, 12.62, -15.82) flipped axis 0; flipped axis 1;
  dowel_2x12-1: 3 mates; position (8.0, -6.62, -10.02) vs target (8.0, -6.62, -10.02) flipped axis 0;
  dowel_2x12-2: 3 mates; position (8.0, 16.62, -10.02) vs target (8.0, 16.62, -10.02) flipped axis 0; flipped axis 1;
ASSEMBLY saved 0: dermasense_bench_v0_1.SLDASM
RENDER dermasense_bench_v0_1_iso.JPG: 0
RENDER dermasense_bench_v0_1_side.JPG: 0
DRAWING dermasense_bench_v0_1: A3 ISO sheet True; sheet scale 1:2 (asked 1:2); first-angle; views 4/4; BOM inserted, balloons 5; note True; DWG NO. resized 1; save 0, PDF 0
done in 277 s
--- run 2026-10-16 03:12:29 stages=('drawings',)
SolidWorks 27.4.0; templates {'part': 'C:\\ProgramData\\SolidWorks\\SOLIDWORKS 2019\\templates\\Part.prtdot', 'asm': 'C:\\ProgramData\\SolidWorks\\SOLIDWORKS 2019\\templates\\Assembly.asmdot', 'drw': 'C:\\ProgramData\\SolidWorks\\SOLIDWORKS 2019\\templates\\Drawing.drwdot'}
DRAWING strip_v0_1: A3 ISO sheet True; sheet scale 1:1 (asked 1:1); first-angle; views 4/4; dimensions 13 (removed 15 repeats); note True; DWG NO. resized 1; save 0, PDF 0
DRAWING seal_v0_1: A3 ISO sheet True; sheet scale 1:1 (asked 1:1); first-angle; views 4/4; dimensions 8 (removed 8 repeats); note True; DWG NO. resized 1; save 0, PDF 0
DRAWING clamp_base_v0_1: A3 ISO sheet True; sheet scale 2:1 (asked 2:1); first-angle; views 4/4; dimensions 16 (removed 5 repeats); note True; DWG NO. resized 1; save 0, PDF 0
DRAWING clamp_lid_v0_1: A3 ISO sheet True; sheet scale 2:1 (asked 2:1); first-angle; views 4/4; dimensions 8 (removed 10 repeats); note True; DWG NO. resized 1; save 0, PDF 0
DRAWING rig_base_v0_1: A3 ISO sheet True; sheet scale 1:2 (asked 1:2); first-angle; views 4/4; dimensions 11 (removed 14 repeats); note True; DWG NO. resized 1; save 0, PDF 0
DRAWING wound_bed_spacer_v0_1: A3 ISO sheet True; sheet scale 1:2 (asked 1:2); first-angle; views 4/4; dimensions 6 (removed 7 repeats); note True; DWG NO. resized 1; save 0, PDF 0
RENDER strip_v0_1_iso.JPG: 0
RENDER clamp_base_v0_1_iso.JPG: 0
RENDER clamp_lid_v0_1_iso.JPG: 0
done in 115 s
