soham0777/dermasense-vishwakarma-2026/5_cad/solidworks/clamp_base_v0_1_drawing.PDF

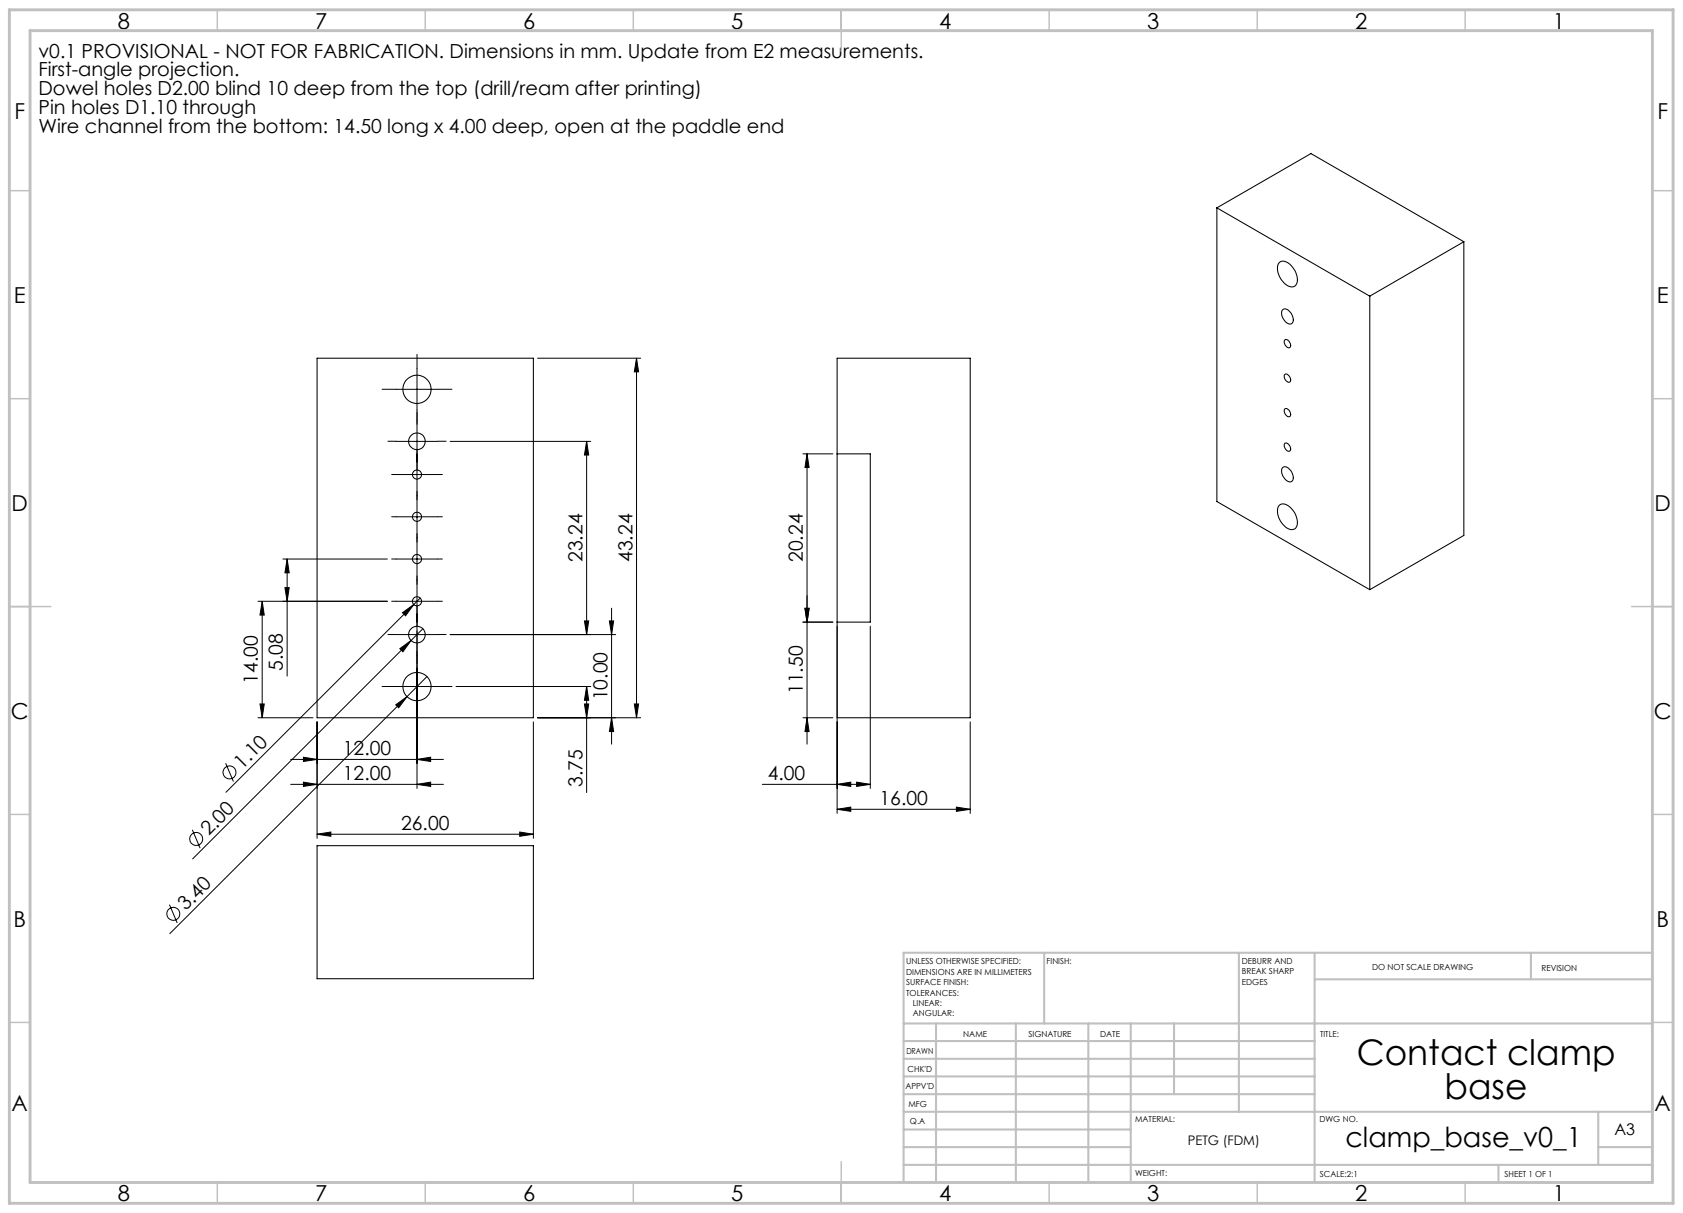
[picture p57: page 1]
FINISH:; DEBURR AND; BREAK SHARP; DO NOT SCALE DRAWING; REVISION; SCALE:2:1; SHEET 1 OF 1

v0.1 PROVISIONAL - NOT FOR FABRICATION. Dimensions in mm. Update from E2 measurements.
First-angle projection.
Dowel holes D2.00 blind 10 deep from the top (drill/ream after printing)
Pin holes D1.10 through
Wire channel from the bottom: 14.50 long x 4.00 deep, open at the paddle end

UNLESS OTHERWISE SPECIFIED:
DIMENSIONS ARE IN MILLIMETERS
SURFACE FINISH:
TOLERANCES:
LINEAR:
ANGULAR:

NAME | SIGNATURE | DATE | | | | TITLE: Contact clamp base

DRAWN
CHK'D
APPV'D
MFG
Q.A | | | | MATERIAL: | DWG NO. clamp_base_v0_1 | A3 PETG (FDM)
