soham0777/dermasense-vishwakarma-2026/5_cad/solidworks/clamp_lid_v0_1_drawing.PDF

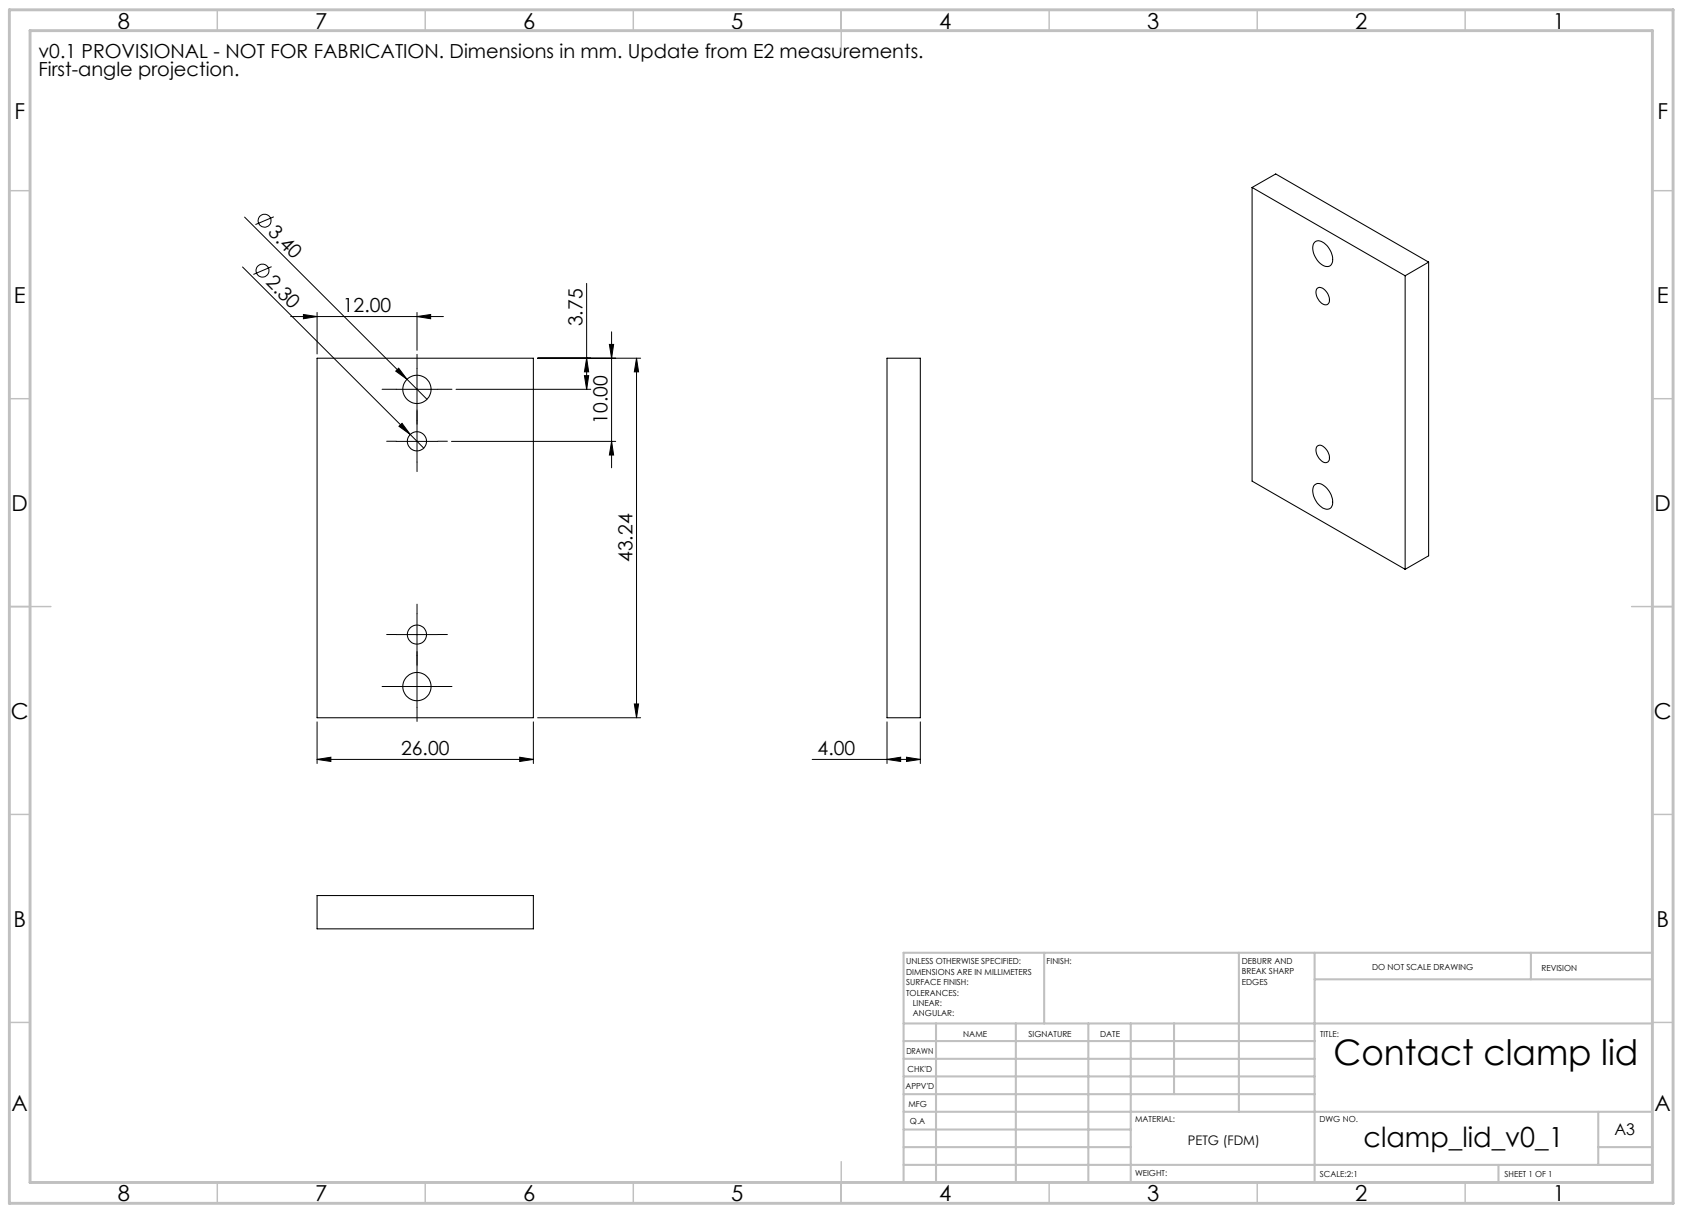
[picture p58: page 1]
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

v0.1 PROVISIONAL - NOT FOR FABRICATION. Dimensions in mm. Update from E2 measurements.
First-angle projection.

UNLESS OTHERWISE SPECIFIED:
DIMENSIONS ARE IN MILLIMETERS
SURFACE FINISH:
TOLERANCES:
LINEAR:
ANGULAR:

NAME | SIGNATURE | DATE | | | | TITLE: Contact clamp lid

DRAWN
CHK'D
APPV'D
MFG
Q.A | | | | MATERIAL: | DWG NO. clamp_lid_v0_1 | A3 PETG (FDM)
