soham0777/dermasense-vishwakarma-2026/5_cad/solidworks/rig_base_v0_1_drawing.PDF

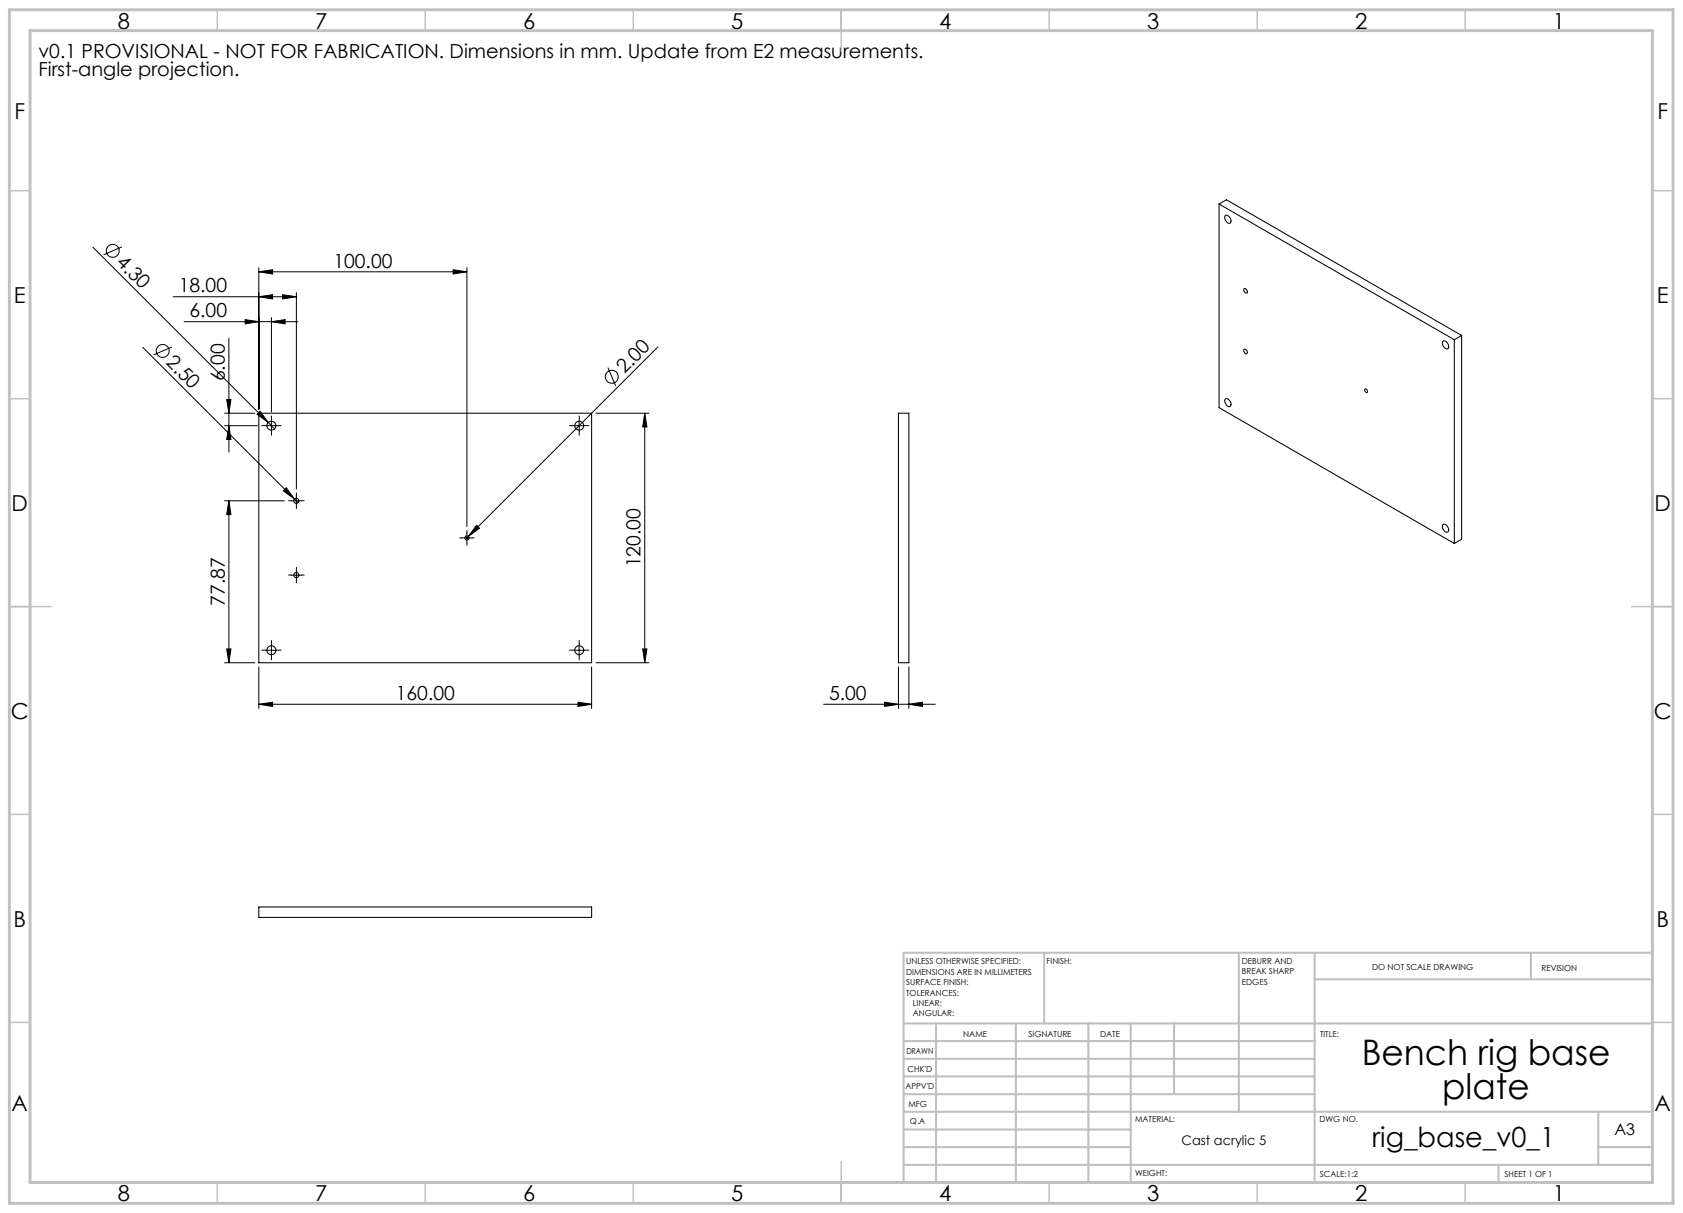
[picture p59: page 1]
FINISH:; DEBURR AND; BREAK SHARP; DO NOT SCALE DRAWING; REVISION; SCALE:1:2; SHEET 1 OF 1

v0.1 PROVISIONAL - NOT FOR FABRICATION. Dimensions in mm. Update from E2 measurements.
First-angle projection.

UNLESS OTHERWISE SPECIFIED:
DIMENSIONS ARE IN MILLIMETERS
SURFACE FINISH:
TOLERANCES:
LINEAR:
ANGULAR:

NAME | SIGNATURE | DATE | | | | TITLE: Bench rig base plate

DRAWN
CHK'D
APPV'D
MFG
Q.A | | | | MATERIAL: | DWG NO. rig_base_v0_1 | A3 Cast acrylic 5
