soham0777/dermasense-vishwakarma-2026/5_cad/solidworks/seal_v0_1_drawing.PDF

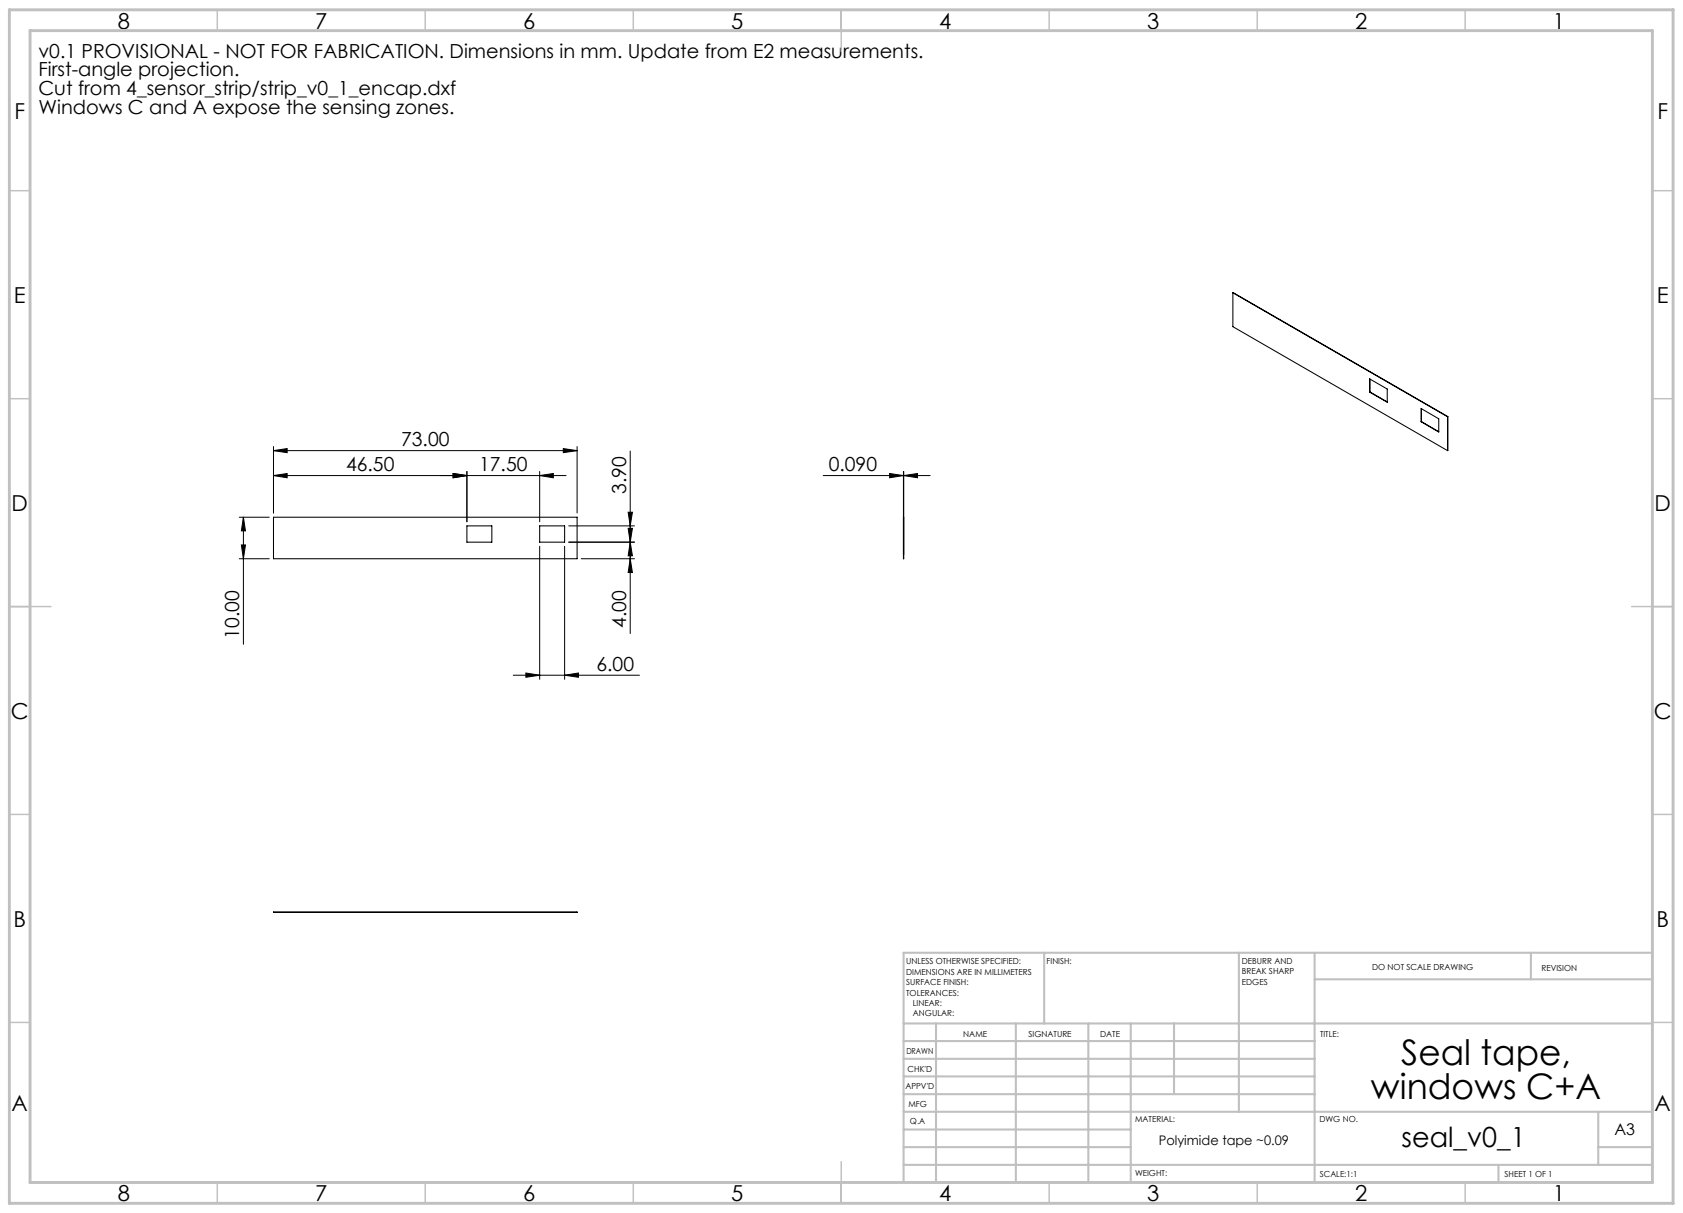
[picture p60: page 1]
FINISH:; DEBURR AND; BREAK SHARP; DO NOT SCALE DRAWING; REVISION; SCALE:1:1; SHEET 1 OF 1

v0.1 PROVISIONAL - NOT FOR FABRICATION. Dimensions in mm. Update from E2 measurements.
First-angle projection.
Cut from 4_sensor_strip/strip_v0_1_encap.dxf
Windows C and A expose the sensing zones.

UNLESS OTHERWISE SPECIFIED:
DIMENSIONS ARE IN MILLIMETERS
SURFACE FINISH:
TOLERANCES:
LINEAR:
ANGULAR:

NAME | SIGNATURE | DATE | | | | TITLE: Seal tape, windows C+A

DRAWN
CHK'D
APPV'D
MFG
Q.A | | | | MATERIAL: | DWG NO. seal_v0_1 | A3 Polyimide tape ~0.09
