soham0777/dermasense-vishwakarma-2026/5_cad/solidworks/strip_v0_1_drawing.PDF

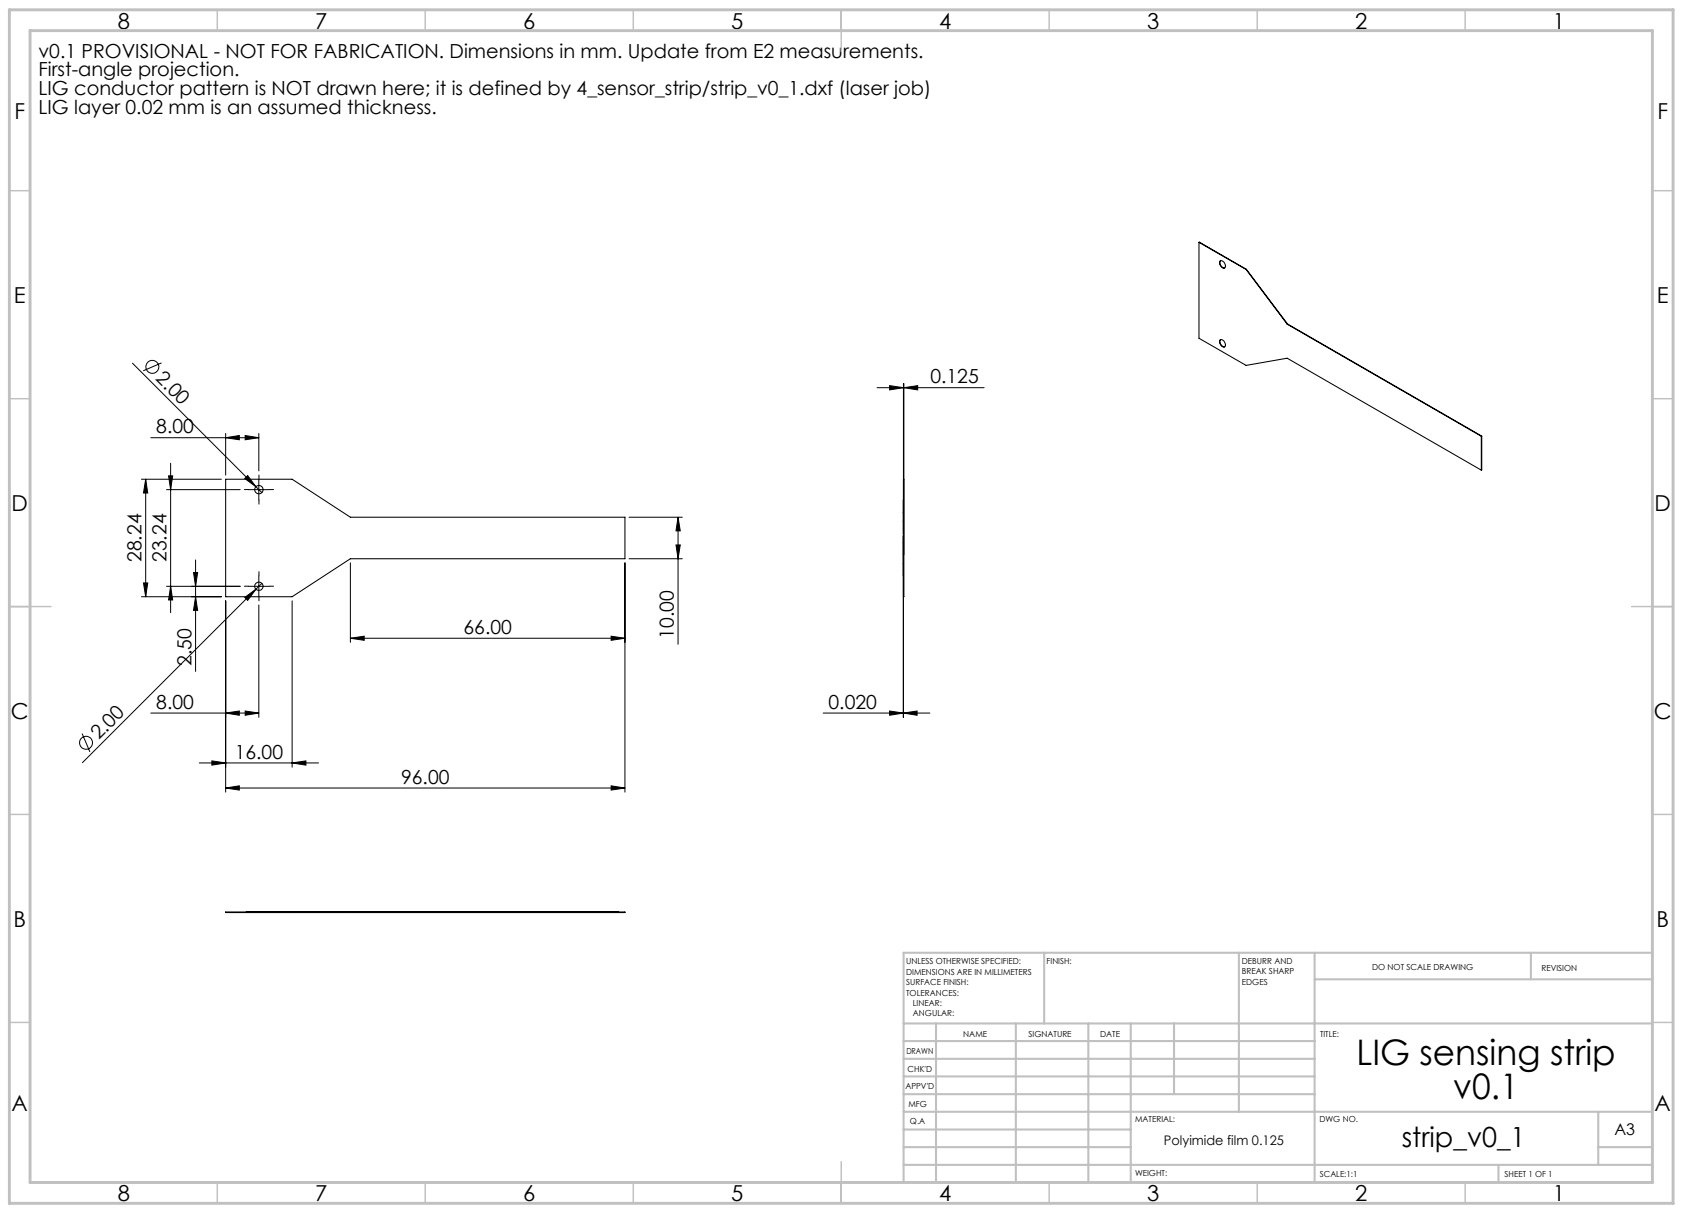
[picture p61: page 1]
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

v0.1 PROVISIONAL - NOT FOR FABRICATION. Dimensions in mm. Update from E2 measurements.
First-angle projection.
LIG conductor pattern is NOT drawn here; it is defined by 4_sensor_strip/strip_v0_1.dxf (laser job)
LIG layer 0.02 mm is an assumed thickness.

UNLESS OTHERWISE SPECIFIED:
DIMENSIONS ARE IN MILLIMETERS
SURFACE FINISH:
TOLERANCES:
LINEAR:
ANGULAR:

NAME | SIGNATURE | DATE | | | | TITLE: LIG sensing strip v0.1

DRAWN
CHK'D
APPV'D
MFG
Q.A | | | | MATERIAL: | DWG NO. strip_v0_1 | A3 Polyimide film 0.125
