soham0777/dermasense-vishwakarma-2026/5_cad/solidworks/dermasense_bench_v0_1_drawing.PDF

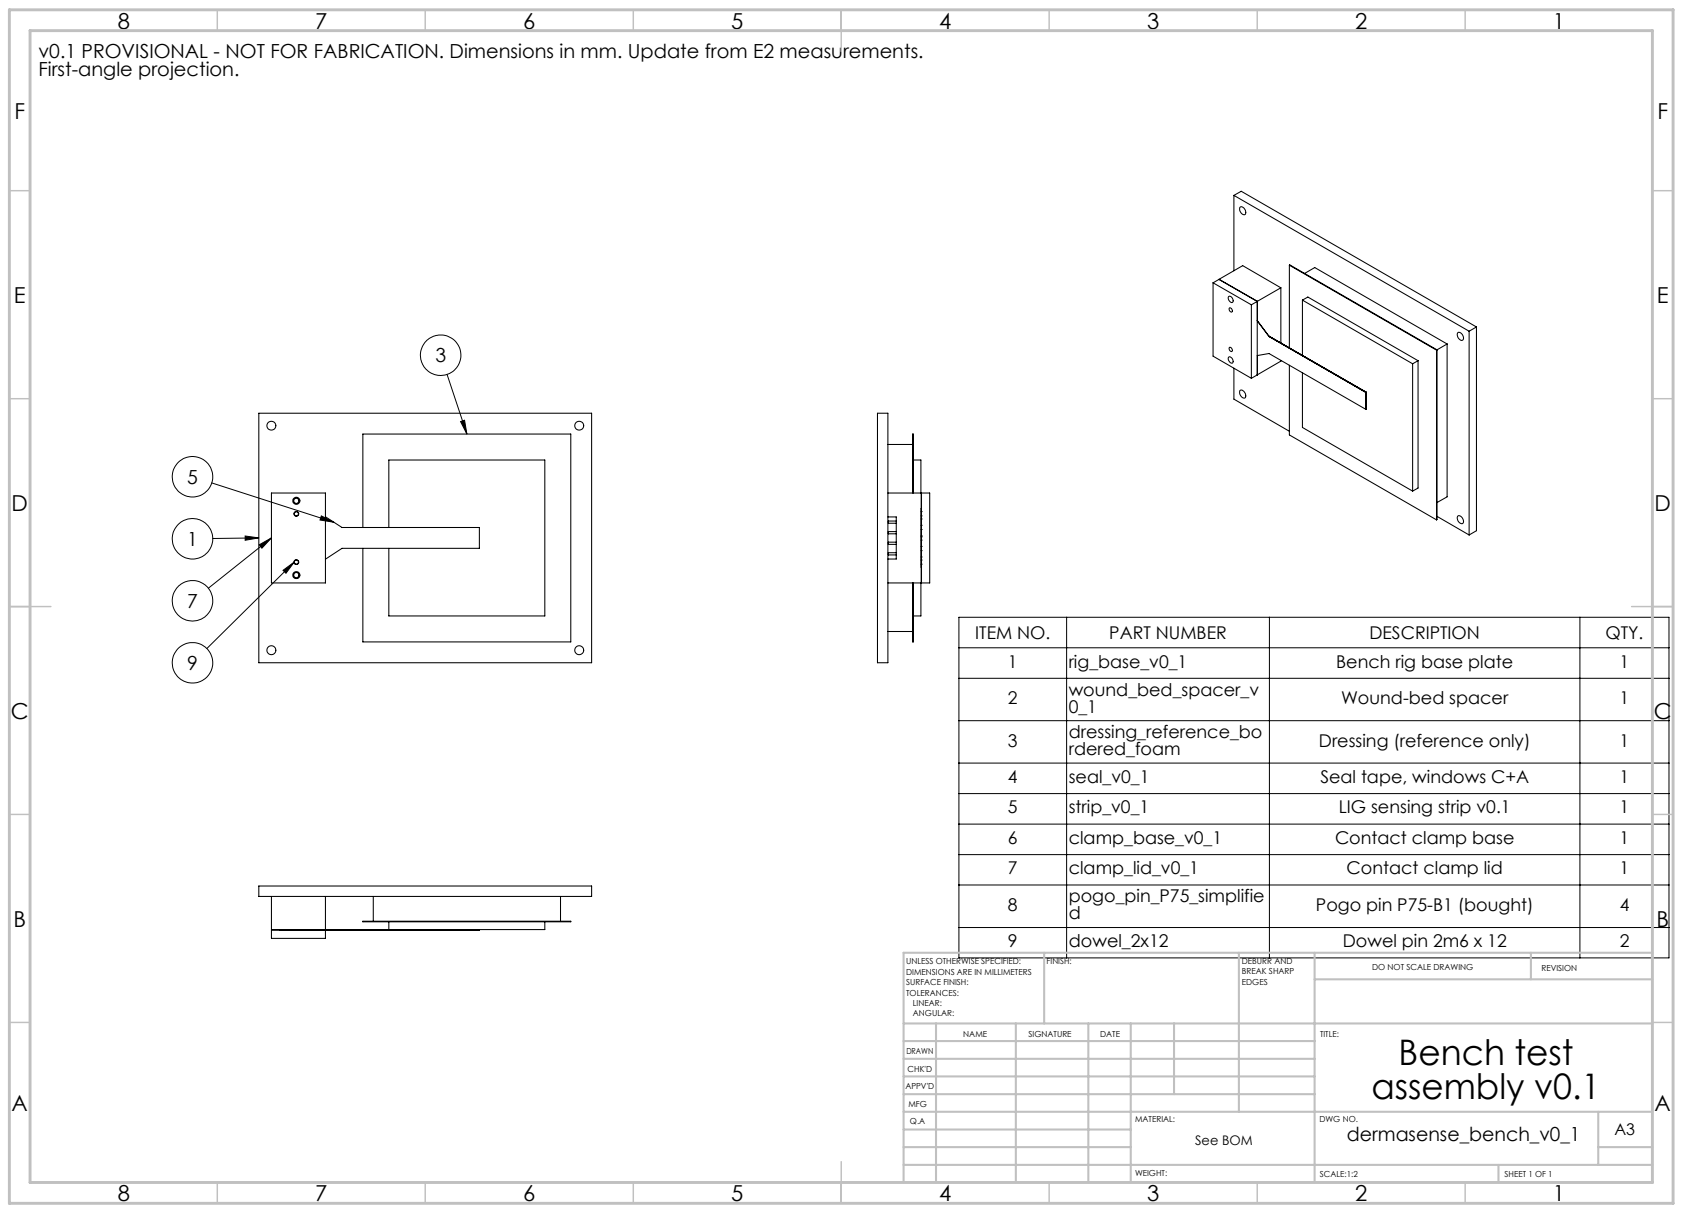
[picture p62: page 1]
Pogo pin P75-B1 (bought); FINISH:; DEBURR AND; BREAK SHARP; DO NOT SCALE DRAWING; REVISION; SCALE:1:2; SHEET 1 OF 1

v0.1 PROVISIONAL - NOT FOR FABRICATION. Dimensions in mm. Update from E2 measurements.
First-angle projection.

ITEM NO. | PART NUMBER | DESCRIPTION | QTY.
1 | rig_base_v0_1 | Bench rig base plate | 1
2 | wound_bed_spacer_v 0_1 | Wound-bed spacer | 1
3 | dressing_reference_bo rdered_foam | Dressing (reference only) | 1
4 | seal_v0_1 | Seal tape, windows C+A | 1
5 | strip_v0_1 | LIG sensing strip v0.1 | 1
6 | clamp_base_v0_1 | Contact clamp base | 1
7 | clamp_lid_v0_1 | Contact clamp lid | 1

9 | dowel_2x12 | Dowel pin 2m6 x 12 | 2

UNLESS OTHERWISE SPECIFIED:
DIMENSIONS ARE IN MILLIMETERS

SURFACE FINISH: TOLERANCES: LINEAR: ANGULAR:

NAME | SIGNATURE | DATE | | | | TITLE: Bench test assembly v0.1

DRAWN
CHK'D
APPV'D
MFG
Q.A | | | | MATERIAL: | DWG NO. dermasense_bench_v0_1 | A3 See BOM
