soham0777/dermasense-vishwakarma-2026/6_electronics/kicad/reader_v0_1.kicad_sch

## KiCad design 6_electronics/kicad/reader_v0_1.kicad_sch (2026-10-15)

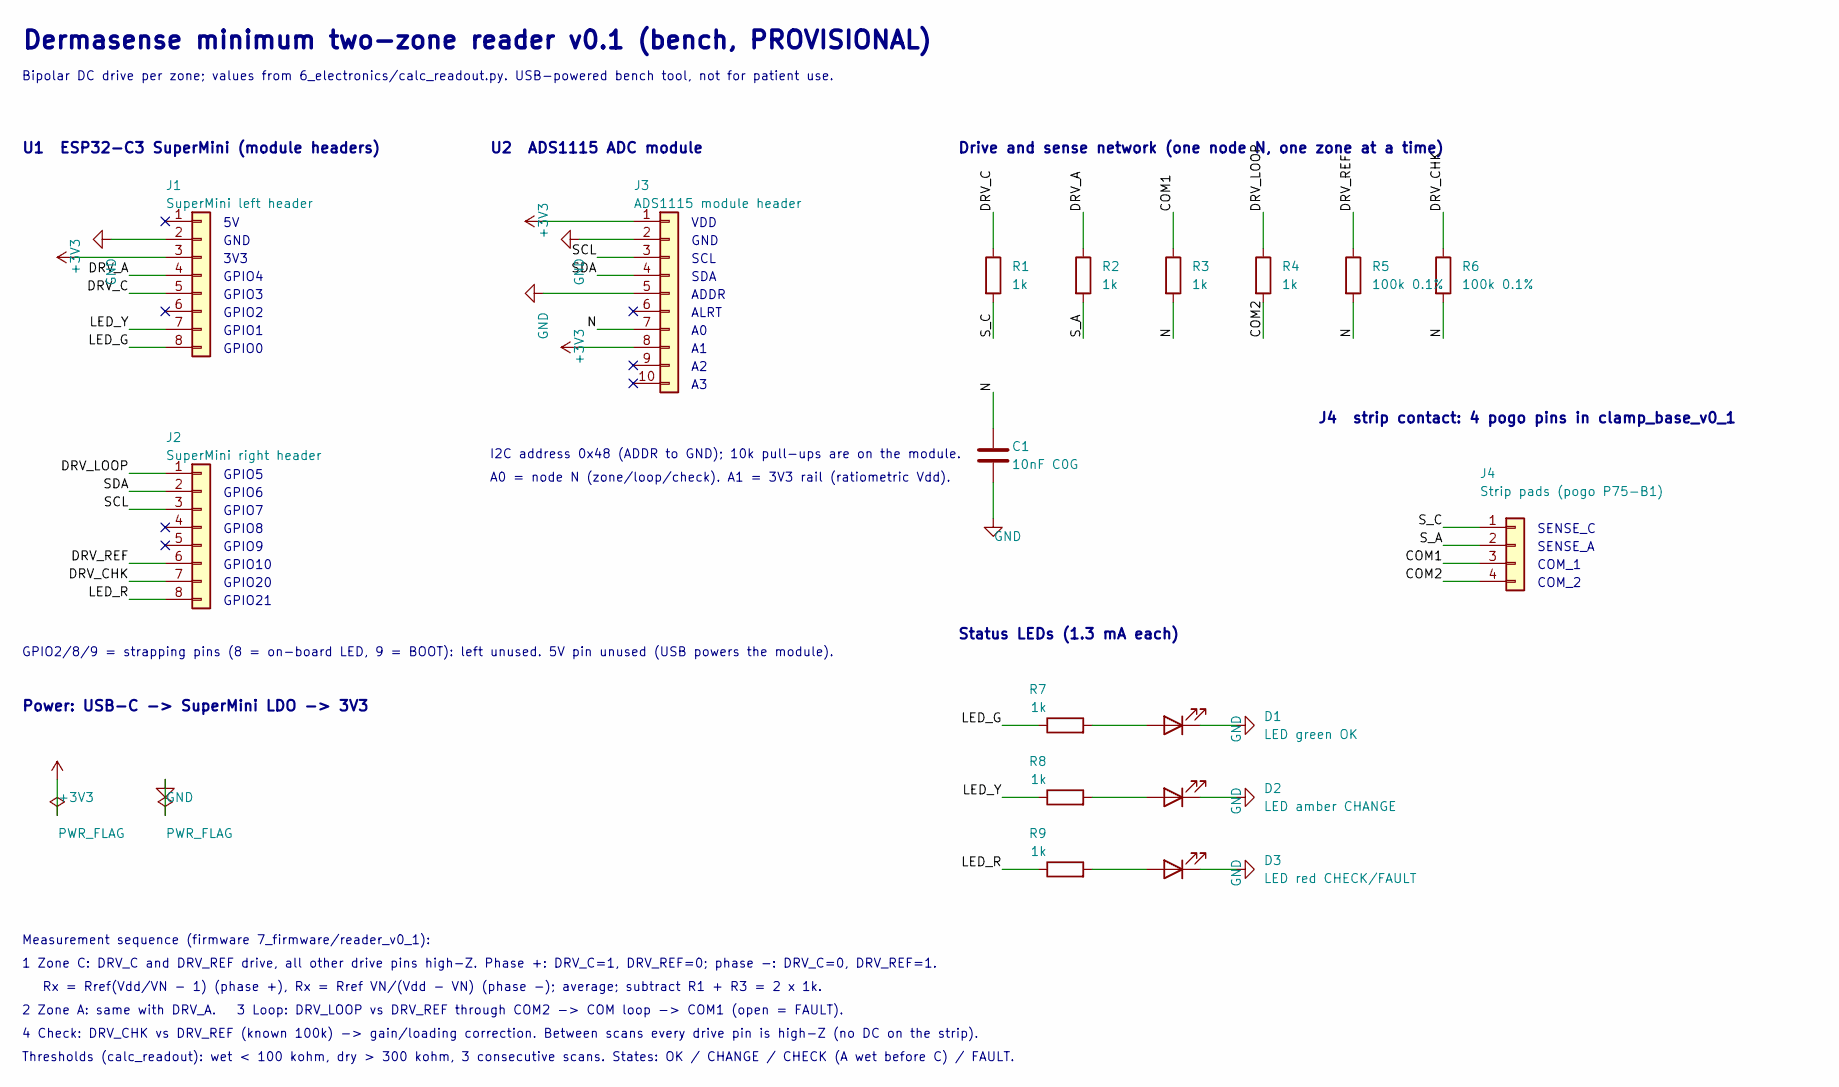
[picture p63: schematic reader_v0_1.kicad_sch]

Parts:
C1: 10nF C0G; C_Disc_D5.0mm_W2.5mm_P5.00mm
D1: LED green OK; LED_D3.0mm
D2: LED amber CHANGE; LED_D3.0mm
D3: LED red CHECK/FAULT; LED_D3.0mm
J1: SuperMini left header; PinHeader_1x08_P2.54mm_Vertical
J2: SuperMini right header; PinHeader_1x08_P2.54mm_Vertical
J3: ADS1115 module header; PinHeader_1x10_P2.54mm_Vertical
J4: Strip pads (pogo P75-B1); PinHeader_1x04_P2.54mm_Vertical
R1, R2, R3, R4, R7, R8, R9: 1k; R_Axial_DIN0207_L6.3mm_D2.5mm_P10.16mm_Horizontal
R5, R6: 100k 0.1%; R_Axial_DIN0207_L6.3mm_D2.5mm_P10.16mm_Horizontal

Connections:
+3V3: J1.3, J3.1, J3.8
COM1: J4.3, R3.1
COM2: J4.4, R4.2
DRV_A: J1.4, R2.1
DRV_C: J1.5, R1.1
DRV_CHK: J2.7, R6.1
DRV_LOOP: J2.1, R4.1
DRV_REF: J2.6, R5.1
GND: C1.2, D1.1 (K), D2.1 (K), D3.1 (K), J1.2, J3.2, J3.5
LED_G: J1.8, R7.1
LED_R: J2.8, R9.1
LED_Y: J1.7, R8.1
N: C1.1, J3.7, R3.2, R5.2, R6.2
unnamed: D1.2 (A), R7.2
unnamed: D2.2 (A), R8.2
unnamed: D3.2 (A), R9.2
SCL: J2.3, J3.3
SDA: J2.2, J3.4
S_A: J4.2, R2.2
S_C: J4.1, R1.2

Notes on the sheet:
Dermasense minimum two-zone reader v0.1 (bench, PROVISIONAL)
Bipolar DC drive per zone; values from 6_electronics/calc_readout.py. USB-powered bench tool, not for patient use.
U1 ESP32-C3 SuperMini (module headers)
GND
3V3
GPIO4
GPIO3
GPIO2
GPIO1
GPIO0
GPIO5
GPIO6
GPIO7
GPIO8
GPIO9
GPIO10
GPIO20
GPIO21
GPIO2/8/9 = strapping pins (8 = on-board LED, 9 = BOOT): left unused. 5V pin unused (USB powers the module).
U2 ADS1115 ADC module
VDD
SCL
SDA
ADDR
ALRT
I2C address 0x48 (ADDR to GND); 10k pull-ups are on the module.
A0 = node N (zone/loop/check). A1 = 3V3 rail (ratiometric Vdd).
Drive and sense network (one node N, one zone at a time)
J4 strip contact: 4 pogo pins in clamp_base_v0_1
SENSE_C
SENSE_A
COM_1
COM_2
Status LEDs (1.3 mA each)
Power: USB-C -> SuperMini LDO -> 3V3
Measurement sequence (firmware 7_firmware/reader_v0_1):
1 Zone C: DRV_C and DRV_REF drive, all other drive pins high-Z. Phase +: DRV_C=1, DRV_REF=0; phase -: DRV_C=0, DRV_REF=1.
Rx = Rref(Vdd/VN - 1) (phase +), Rx = Rref VN/(Vdd - VN) (phase -); average; subtract R1 + R3 = 2 x 1k.
2 Zone A: same with DRV_A. 3 Loop: DRV_LOOP vs DRV_REF through COM2 -> COM loop -> COM1 (open = FAULT).
4 Check: DRV_CHK vs DRV_REF (known 100k) -> gain/loading correction. Between scans every drive pin is high-Z (no DC on the strip).
Thresholds (calc_readout): wet < 100 kohm, dry > 300 kohm, 3 consecutive scans. States: OK / CHANGE / CHECK (A wet before C) / FAULT.
