soham0777/dermasense-vishwakarma-2026/(commit log)

2026-10-14 Restart project from scratch: iteration 1 (requirements + sensor selection)
    - Clean structure: control docs, people, research, sensors, LIG lab,
    electronics, CAD, firmware, submission
    - Verified literature database (25 sources) + critique of Rezaei 2024
    - Sensor concept comparison (11 concepts) and proposed portfolio
    S1 moisture / S2 temperature / S3 pH (pending team approval)
    - Requirements, traceability matrix, test log, decision log, review checklist
    - Electronics architecture, preliminary BOM, power budget script
    - LIG test coupon generator (TLM strips), laser log + analysis script
    - No experimental data yet; all numbers are literature or labelled estimates
    [bom_preliminary.csv, laser_log.csv, lig_test_coupon.dxf, literature.csv, test_log.csv, traceability.csv]
2026-10-14 Add differentiator analysis: edge-alert strip (D5), proposed
    Compares five candidate differentiators against verified prior art
    (McColl 2007 in-vitro moisture array, moisture-map patents, dressing
    makers' "2 cm from edge" change criterion) and recommends an outer-face
    LIG strip that reads the change criterion directly, with a single
    centre zone as the built-in baseline. Includes pass/fail criteria for
    experiment E01. Nothing built or tested yet; status PROPOSED.
2026-10-14 Process-first iteration: E1 protocol, evidence register, filled Stage 2 template
    - Evidence register (A: team records, B: planned, C: literature, X: excluded
    earlier claims); machine facts recovered from the LaserCAD V8.28 config
    - Experiment E1: reproduce and bracket the earlier "setting 12" observation;
    machine record form, pre-filled sample sheet, raw-data CSVs, pre-registered
    decision rules; analyze_e1.py (TLM sheet resistance, CV) tested on synthetic
    data outside the repo only
    - Focused research-gap analysis; literature L26-L36 added
    - Official Vishwakarma Stage 2 template filled in place by build_deck.py
    (20 slides, original order/layout); figures generated from project files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
    [e1_controls.csv, e1_linewidth.csv, e1_resistance.csv, e1_samples.csv, e1_setting_current.csv, evidence_register.csv, laser_log.csv, literature.csv]
2026-10-14 Deck v2: one strong slide per section, story-first, real-file visuals
    - Removed the template's instruction slides; kept its content-slide designs and
    section order (11 slides); User Journey gets its own slide (duplicated design)
    - New figures: problem illustration, before/after journey, labelled product
    concept, E1 coupon + settings, readout schematic, real-file evidence panel
    (E1 data sheet + LaserCAD config); figures sized to fill the left column
    - Numbered citations replace [A]/[B]/[C] tags; targets and concepts labelled
    - Risk cards merged into readable single boxes with a concrete "Test" line
    - Decision D-011 recorded
    [build_deck.py, make_figures.py]
2026-10-14 WIP stage2 rebuild: audit, research matrix, two-zone strip, calcs, SolidWorks CAD
    - Baseline audit; research matrix incl. diaper-wetness prior art
    - Sensor decision matrix: two-zone strip (C + change line A) selected over 4-zone
    - Strip v0.1 generator (DXF + seal + JSON), DRC PASS; readout and mechanical calcs
    - SolidWorks 2019 native parts, STEP, A3 drawings, 13-component mated assembly
    (generated by 06_cad/sw_build.py); KiCad 10.0.6 installed, schematic not yet done
    - KNOWN ISSUE: last sw_build.py run (mm units + colours patch) crashed SolidWorks
    after strip_v0_1; other parts/drawings are from the previous run (cm units)
    [clamp_base_v0_1.SLDDRW, clamp_base_v0_1.SLDPRT, clamp_base_v0_1.STEP, clamp_lid_v0_1.SLDDRW, clamp_lid_v0_1.SLDPRT, clamp_lid_v0_1.STEP, dermasense_bench_v0_1.SLDASM, dermasense_bench_v0_1.SLDDRW]
2026-10-14 CAD v0.1 freeze + verification; E2 fabrication-validation package
    CAD (06_cad):
    - sw_build.py: first-angle A3 drawings, dimensions shown once (dedupe
    by dimension identity), 3-decimal film thicknesses, short titles,
    Material field, notes (DXF reference, provisional status), assembly
    BOM + balloons, assembly and STEP in mm (were cm), render fix.
    - verify_cad.py (new): independent re-open of every part/assembly/
    drawing, units, volumes and bounding boxes recomputed from the
    geometry JSON, STEP header + re-import volumes, component positions,
    interference detection, PDF content. Result 99 PASS / 0 FAIL /
    5 BLOCKED (E2 measurements not yet available).
    - Interference found and fixed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
    [clamp_base_v0_1.SLDDRW, clamp_base_v0_1.SLDPRT, clamp_base_v0_1.STEP, clamp_lid_v0_1.SLDDRW, clamp_lid_v0_1.SLDPRT, clamp_lid_v0_1.STEP, dermasense_bench_v0_1.SLDASM, dermasense_bench_v0_1.SLDDRW]
2026-10-14 Minimum two-zone reader: KiCad schematic (ERC clean) + ESP32-C3 firmware
    05_electronics/kicad:
    - make_reader_schematic.py generates reader_v0_1.kicad_sch from real
    KiCad 10 library symbols; ERC 0 violations (all severities); PDF,
    netlist and BOM exported. Project library tables added.
    - Circuit: bipolar GPIO drive per zone through 1k into node N,
    100k 0.1% Rref, 100k check resistor, ADS1115 A0 = N, A1 = 3V3.
    07_firmware:
    - reader_v0_1 (ESP32-C3 SuperMini + ADS1115): check/zone C/zone A/
    COM-loop scan, hysteresis + 3-scan persistence, OK/CHANGE/CHECK/
    FAULT, CSV over USB. Compiles with 0 warnings; 22 static_assert
    tests (a deliberately false assert breaks the build).
    - tools: ser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
    [bench_test.csv, reader_v0_1.kicad_sch, reader_v0_1_bom.csv]
2026-10-14 Procurement BOM v0.1, design FMEA v0.1, official Template (2), submission assembler
    - 09_procurement/bom_v0_1.csv: 23 lines traced to requirement files;
    prices are estimates (to verify before ordering).
    - 00_control/make_fmea.py -> fmea_v0_1.csv/.md: 15 failure modes,
    estimated S/O/D; top risk F04 (unmonitored sense-lead break) needs a
    v0.2 design change.
    - 08_submission/template: team-named official Template (2) added next
    to the first copy (identical slide content, different bytes);
    provenance recorded; build_deck.py points at Template (2). No deck
    redesign.
    - 00_control/assemble_submission.py: builds FINAL_SUBMISSION from the
    source folders and verifies every copy.
    [bom_v0_1.csv, fmea_v0_1.csv]
2026-10-14 FINAL_SUBMISSION: verified copies, file index, checklist, readiness report
    - FINAL_SUBMISSION/ built by 00_control/assemble_submission.py from the
    source folders: 107 files, all SHA-256 identical to their sources.
    - Copies re-verified in their intended software:
    - SolidWorks: 9/9 parts; assembly self-contained (13/13 components
    from the copy); 7/7 drawings
    - PowerPoint: official template, 20 slides
    - KiCad ERC on the copy: 0 violations
    - arduino-cli: the copy compiles, 0 warnings
    - Also checked: PDF/DXF/CSV readers, internal Markdown links,
    35/39 reference links resolve automatically (+1 in the browser,
    2 unreachable -> references marked Complete, not Verified), and a
    per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
    [bench_test.csv, bom_v0_1.csv, clamp_base_v0_1.SLDDRW, clamp_base_v0_1.SLDPRT, clamp_base_v0_1.STEP, clamp_lid_v0_1.SLDDRW, clamp_lid_v0_1.SLDPRT, clamp_lid_v0_1.STEP]
2026-10-14 Store FINAL_SUBMISSION bytes exactly as checksummed (renormalize under -text)
    [bench_test.csv, clamp_base_v0_1.STEP, clamp_lid_v0_1.STEP, dermasense_bench_v0_1.STEP, dowel_2x12.STEP, dressing_reference_bordered_foam.STEP, e2_res_coupon.dxf, e2_res_coupon_features.csv]
2026-10-14 Final Stage 2 deck on the official template + PDF, QA, claim and asset reports
    08_submission/Stage2_Final (deliverables folder):
    - Vishwakarma_Stage2_Final.pptx (18 slides) and .pdf, built by
    build_final_deck.py on the unchanged official Template (2): template
    section order and slide limits, each section's own example-slide
    design reused, guideline slides mapped instead of kept.
    - Real engineering visuals: SolidWorks renders incl. an exploded view
    and a genuine UI capture (render_cad.py, read-only, temp copies),
    KiCad schematic export, DXF-drawn strip and E2 coupon, block and
    data-flow diagrams, FMEA, decision matrix, roadmap
    (make_final_figures.py).
    - One evidence-status pill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
    [file_index.csv, research_matrix.csv]
2026-10-15 Reorganise project into 7 clear folders; declutter the Stage 2 deck
    Structure (one copy of everything, max depth 3):
    FINAL_SUBMISSION/ only the deck .pptx + .pdf
    1_presentation 2_research 3_decisions 4_sensor_strip (+e2_experiment)
    5_cad 6_electronics (+kicad, BOM) 7_firmware
    - Removed the 112-file duplicate copy tree (FINAL_SUBMISSION copies)
    and its assembler; superseded iteration-1 docs (build plan, concept
    comparison, architecture, old requirements/traceability, E1 files,
    preliminary BOM, power budget, CAD plan, audit); the v2 deck; the
    duplicate template copy. All remain in git history
    (tag backup/pre-reorganize-a5e776f).
    - New requirements.md for strip v0.1 with t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
    [bench_test.csv, bom_preliminary.csv, bom_v0_1.csv, clamp_base_v0_1.SLDDRW, clamp_base_v0_1.SLDPRT, clamp_base_v0_1.STEP, clamp_lid_v0_1.SLDDRW, clamp_lid_v0_1.SLDPRT]
2026-10-19 Stage 2 gap review: checklist, roadmap on programme dates, BLE broadcast
    Full review of every folder against the official template, the organiser's
    email and website, and the Stage 1 proposal (STAGE2_CHECKLIST.md).
    Deck (QA: 18 slides, 0 issues; ~104 words per content slide):
    - Roadmap moved onto the programme's dates: prototype video early Dec,
    January semi-final, IIT Indore finale 26 Jan - 1 Feb (D-014)
    - Before state: cited time (18 min/visit) and cost (Rs 240-510/dressing)
    - After state: "up to 44.9 %" and strip payback, labelled projections
    - BOM in the template's table form; 3 prices quoted 19 Oct
    - Prior art: ALLEVYN LIFE visual change indicator; Stage 1 Kapton
    "medical-grade" cl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
    [bench_test.csv, bom_v0_1.csv, literature.csv]
2026-10-19 Audit + deck refinement: show the engineering, keep it readable (19 slides)
    Read-only audit (PROJECT_AUDIT.md); template read twice and mapped to our
    files (TEMPLATE_EVIDENCE_MAP.md); plan and changelog per slide
    (SLIDE_BY_SLIDE_CHANGELOG.md). CAD verification (99/0/5) and KiCad ERC (0)
    re-run today.
    Deck, 18 -> 19 slides (the template's maximum):
    - New Project Overview & Team slide (template T2) with photo placeholders
    the team replaces (Change Picture, or 1_presentation/team_photos/)
    - "How it senses" figure: dressing layers -> dry vs wet gap -> reader
    - Annotated SolidWorks exploded view; measurement path drawn from the
    netlist above the real KiCad sheet; evidence gallery of real fil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
    [build_deck.py, make_figures.py, qa_deck.py]
2026-10-19 Rebuild Stage 2 deck on the team's own template (Stage2_Review_Output_2026-10-20)
    Template from the team's Downloads (MD5 4d96244a...) read page by page twice;
    it matches copy "(2)" in text, notes and layout. Organiser email deadline:
    "11:59 PM on 25th October 2026".
    New deck (19 slides, QA 0 issues, PDF exported by PowerPoint):
    - Slide 1: Application ID + team names only
    - Problem Context x2, problem only: definition, Project Overview in the
    bottom bar (template example page 4); editable comparison table of
    today's options and the gap
    - User Journey x2: who is affected (Indian prevalence, ICMR diabetes,
    foot-ulcer risk, dressing-change pain; 5 new verified sources) and
    editable bef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
    [new_sources.csv]
2026-10-20 Public project report (README) + MIT license; team's deck edits
    - README.md rewritten as the public report: problem in one sentence, who
    is affected (cited), how it works, what is built, verification results
    (re-run 19 Oct), what is not done yet, roadmap, repository map, how this
    work was done (AI-assisted scripts, disclosed), references.
    - LICENSE: MIT for the team's own work; the official Vishwakarma template
    and logos (Maker Bhavan Foundation) and third-party sources excluded.
    - Stage2_Review_Output_2026-10-20/Vishwakarma_Stage2_Refined.pptx/.pdf:
    edits made by the team after the 00:27 build (simpler wording, team
    photo on slide 12, 20 x 11.25 in). QA_Report.md notes the 6 lay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
2026-10-20 Showcase README (banner, diagrams, gallery); update commit IDs after history cleanup
    README redesigned: banner from our SolidWorks render, project badges, the problem in numbers, state diagram and signal-flow diagram (Mermaid), gallery of CAD / circuit / laser files, verification table, roadmap timeline, collapsible repo map, checks, method and references. docs/make_banner.py rebuilds the banner. Commit IDs and backup-tag names quoted in the documents updated to the cleaned history.
    [build_deck.py, make_figures.py]
2026-10-20 Final Stage 2 submission: team deck with feedback, photos and GitHub link
    - FINAL_SUBMISSION/: the team's deck with the slide-by-slide feedback applied,
    team photos and roles on slide 12, the repository link, and the PDF exported by PowerPoint
    - Removed the earlier deck versions (Stage2_Review_Output .pptx/.pdf)
    - Lid bending stress added to calc_mechanical (analytical, not FEA)
    - Data-flow figure: CHECK = zone A wet before C
    - README links point to the final PDF
2026-10-20 Stage 2 submitted on 20 Oct 2026
